NONGbixi/GONGCHUANG_Intelligent_Logistics_Handling_Tower_Crane_Mechanical/README.md

## 📢 装配验证更新｜2026.10.24

近期实车装配过程中发现并修复了三处影响安装的结构干涉与紧固件适配问题，修正涉及云台轴承、升降底板及底板。

**已下载或克隆旧版模型的使用者，请获取最新修复版本后再进行加工。详细修改记录请参阅 [Releases](https://github.com/NONGbixi/GONGCHUANG_Intelligent_Logistics_Handling_Tower_Crane_Mechanical/releases)。项目仍在持续调试与完善中。**

---

# 2027工创赛智梭速运升降台

面向智能物流搬运任务的升降台机械资料，包含 SolidWorks 零件模型、装配体、紧固件清单和三物料搬运动画。

## 原型来源

**原型车来自西安理工大学工程训练中心的 2025 工创赛塔吊方案。**

- 原文：[《工创赛2025-塔吊方案机械开源（2分15秒）》西安理工大学工程训练中心](https://blog.csdn.net/louisaerdusai/article/details/150106890)
- CSDN 作者账号：`louisaerdusai`。
- 本项目在该原型基础上进行升降台及夹取机构的修改与整理；原型设计的署名归原作者所有。
- 原文标示 CC BY-SA 4.0 版权协议；转载原文内容时应保留原作者、出处和版权声明。机械附件及第三方模型的具体授权以原始发布说明为准，详见 [来源与改动说明](文档/来源与改动说明.md)。

## 打开装配体

解压或完整克隆仓库后，用 SolidWorks 打开：

`模型/智梭_2027升降台总_铝条支架_标准紧固件.SLDASM`

请保留整个“模型”文件夹及其中的相对位置。发布副本的 CAD 文件统一添加“智梭_”前缀，方便与本机已有的同名源模型区分。

## 资料目录

| 目录 | 内容 |
| --- | --- |
| 模型 | 指定车辆的 5 个装配体和 85 个零件，共 90 个模型文件 |
| 清单 | 原有紧固件清单及商家采购清单的原样副本 |
| 动画 | 三物料搬运俯视与斜视配乐 MP4 |
| 预览 | 从指定发布总装导出的预览图 |
| 文档 | 来源说明、引用检查与完整性报告 |

## 本次整理

- 以标准紧固件版本总装为发布入口，补入原文件夹外的装配依赖。
- 排除 SolidWorks 锁文件、缓存、建模中间文件与重复备份；历史资料仍保留在本机源目录。
- 仅在新建发布副本中调整模型引用。源目录及源模型未执行改名、移动或保存。
- 发布副本中的旧上下文关联及导入链接处理，见“文档”内记录。

## 清单与动画说明

两份 Excel 清单为原样复制，分别用于紧固件明细与商家采购参考。采购前请结合当前装配、加工工艺和实际库存复核；本次没有重写清单数量。

动画为现有方案演示素材，预览图由指定发布总装导出。它们不代替最终装配的尺寸、运动干涉和加工验证。

## 验证

文档中的 [装配完整性报告](文档/装配完整性报告.txt)、[装配引用检查](文档/装配引用检查.tsv) 及文件校验清单为最初整理版本的历史记录，不代表后续模型变更已重新验证。最新实车装配反馈与修复说明请参阅 [Releases](https://github.com/NONGbixi/GONGCHUANG_Intelligent_Logistics_Handling_Tower_Crane_Mechanical/releases)。
