NONGbixi/GONGCHUANG_Intelligent_Logistics_Handling_Tower_Crane_Mechanical/建模记录/智梭_JY62陀螺仪/模型说明.txt

模型文件：D:\Robot\2027工创赛智梭速运升降台\模型\智梭_JY62陀螺仪.SLDPRT
一个 SolidWorks 多实体零件，陀螺仪模块及载板均包含在同一 SLDPRT 内。
外表无文字。PCB RGB(16,56,32)，银色 RGB(174,186,198)。
模块 15.24 x 15.24 mm，PCB 厚 0.8 mm，屏蔽罩高 2 mm。
12 个完整引脚通孔，D0.8 mm（孔径按图片比例估算），同排间距 2.54 mm，双排中心距 12.7 mm，同时保留板边半孔。
载板 30 x 30 x 1.6 mm，圆角 R1.5，四孔 D2.2，孔距 24.6 mm；载板外形、孔位及外围元件均为按图片比例建立的示意细节。
原目录 88 个已有模型文件的长度与修改时间均未变化。
建模脚本只新建文档，后续 FinishJY62 脚本按完整路径锁定本次新建文件。
