NONGbixi/GONGCHUANG_Intelligent_Logistics_Handling_Tower_Crane_Mechanical/文档/来源与改动说明.md

# 来源与改动说明

原型车来源：西安理工大学工程训练中心，2025 工创赛塔吊方案机械开源。

原文：https://blog.csdn.net/louisaerdusai/article/details/150106890

作者账号：louisaerdusai。原文页面声明采用 CC BY-SA 4.0，并要求转载附原文出处链接和版权声明。保留此署名及声明；机械附件、标准件和第三方模型的授权范围以各自原始说明为准。

本项目基于上述原型整理升降台资料，源目录中已有改动涉及底板、铝条支架、标准紧固件、转台、夹爪和物料模型。这里说明的是资料范围，不将这些改动全部归于本次整理。

本次整理只创建独立发布副本、收集依赖、调整副本文件名与引用、复制清单和动画、补充文档。不改动原目录中的源文件。

发布副本为脱离原电脑路径使用，对部分旧装配上下文关联进行了断开，保留副本中已有特征与几何；具体对象见独立副本说明.tsv。这样不会继续联动旧原型装配。原始参数化关联仍保留在本机源文件中。

未将整套资料另行标为 MIT 或其他新许可证，也未对第三方模型和配乐声明新的授权。
