NONGbixi/GONGCHUANG_Intelligent_Logistics_Handling_Tower_Crane_Mechanical/建模记录/智梭_JY62陀螺仪/智梭_JY62陀螺仪_正视.bmp

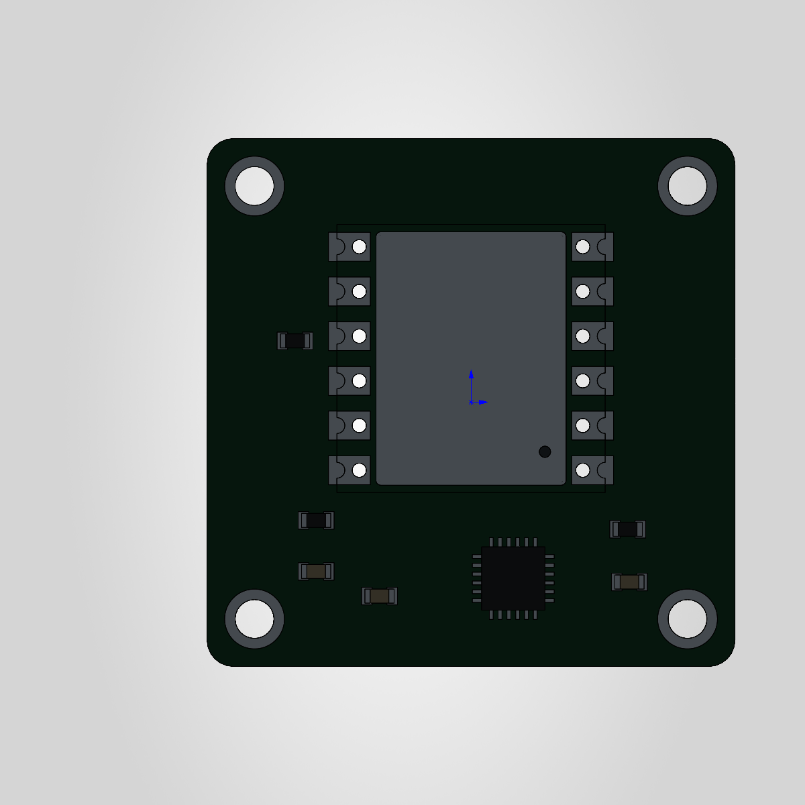
建模记录/智梭_JY62陀螺仪/智梭_JY62陀螺仪_正视.bmp
