NONGbixi/GONGCHUANG_Intelligent_Logistics_Handling_Tower_Crane_Mechanical/预览/指定总装预览.png

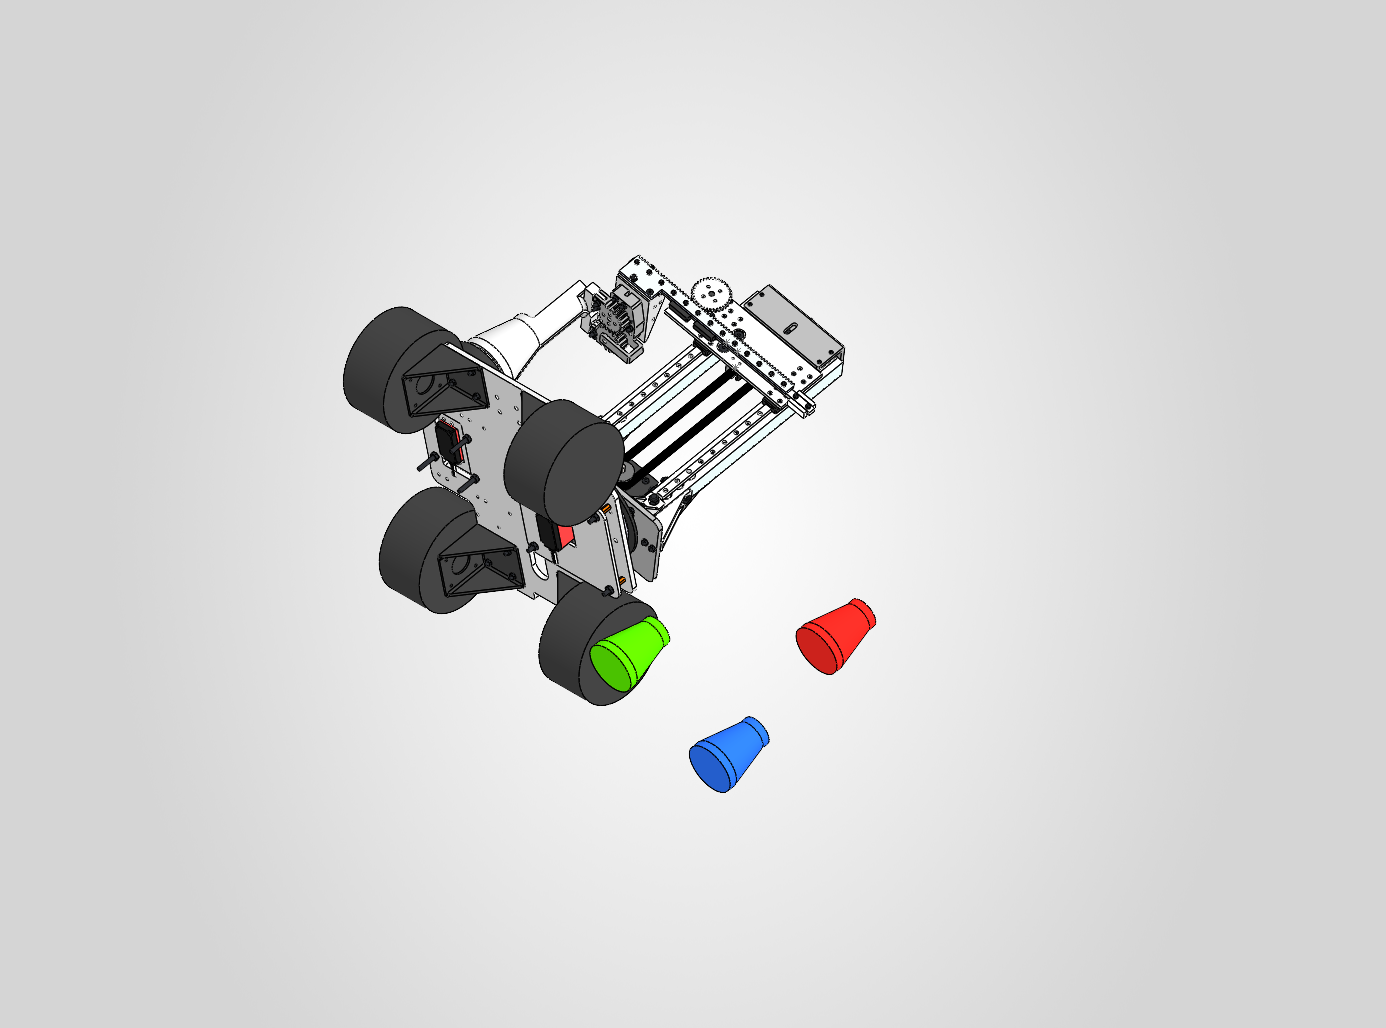
预览/指定总装预览.png
