NONGbixi/GONGCHUANG_Intelligent_Logistics_Handling_Tower_Crane_Mechanical/清单/2027升降台_紧固件商家采购清单.xlsx

种类 | 规格 | 数量
十字槽盘头螺钉 | M2×4（头径 3.5 mm，头厚 1.3 mm） | 24
十字槽盘头螺钉 | M2×6（头径 3.5 mm，头厚 1.3 mm） | 2
十字槽盘头螺钉 | M2×8（头径 3.5 mm，头厚 1.3 mm） | 13
十字槽超薄头螺钉 | M2×12（头径 4 mm，头厚 0.5 mm） | 2
十字槽盘头螺钉 | M2×25（头径 3.5 mm，头厚 1.3 mm） | 12
十字槽盘头螺钉 | M2×40（头径 3.5 mm，头厚 1.3 mm） | 4
十字槽超薄头螺钉 | M3×5（头径 6 mm，头厚 0.8 mm） | 4
十字槽超薄头螺钉 | M3×6（头径 6 mm，头厚 0.8 mm） | 4
十字槽超薄头螺钉 | M3×8（头径 6 mm，头厚 0.8 mm） | 4
十字槽超薄头螺钉 | M3×10（头径 6 mm，头厚 0.8 mm） | 4
十字槽超薄头螺钉 | M3×12（头径 6 mm，头厚 0.8 mm） | 36
十字槽超薄头螺钉 | M3×16（头径 6 mm，头厚 0.8 mm） | 6
十字槽超薄头螺钉 | M3×20（头径 6 mm，头厚 0.8 mm） | 7
十字槽超薄头螺钉 | M3×25（头径 6 mm，头厚 0.8 mm） | 4
十字槽超薄头螺钉 | M4×30（头径 8 mm，头厚 0.9 mm） | 4
十字槽超薄头螺钉 | M5×12（头径 9 mm，头厚 1 mm） | 14
十字槽超薄头螺钉 | M5×16（头径 9 mm，头厚 1 mm） | 2
十字槽超薄头螺钉 | M5×20（头径 9 mm，头厚 1 mm） | 1
十字槽超薄头螺钉 | M5×30（头径 9 mm，头厚 1 mm） | 9
六角螺母（ISO 4032） | M2 | 33
六角螺母（ISO 4032） | M3 | 53
六角螺母（ISO 4032） | M4 | 4
六角螺母（ISO 4032） | M5 | 26
