NONGbixi/GONGCHUANG_Intelligent_Logistics_Handling_Tower_Crane_Mechanical/清单/2027铝条支架总装_紧固件清单.xlsx

Sheet: 采购汇总
铝条支架总装紧固件清单（十字薄头方案）
 | 螺钉（颗） |  | 158 |  | 螺母（颗） |  | 118
 | 螺钉长度为头下长度；螺母对应厚度。数量为本次总装实际布置数量，不含备件。
序号 | 名称 | 规格 | 标准 | 公称直径 (mm) | 长度/厚度 (mm) | 螺距 (mm) | 数量 | 说明
1 | 螺钉 | M2×4 | JIS B 1111 盘头 | 2.0 | 4.0 | 0.4 | 26 | 十字槽盘头；头径 3.5，头厚 1.3 mm
2 | 螺钉 | M2×6 | JIS B 1111 盘头 | 2.0 | 6.0 | 0.4 | 2 | 十字槽盘头；头径 3.5，头厚 1.3 mm
3 | 螺钉 | M2×8 | JIS B 1111 盘头 | 2.0 | 8.0 | 0.4 | 13 | 十字槽盘头；头径 3.5，头厚 1.3 mm
4 | 螺钉 | M2×12 | JIS B 1111 盘头 | 2.0 | 12.0 | 0.4 | 2 | 十字槽盘头；头径 3.5，头厚 1.3 mm
5 | 螺钉 | M2×25 | JIS B 1111 盘头 | 2.0 | 25.0 | 0.4 | 12 | 十字槽盘头；头径 3.5，头厚 1.3 mm
6 | 螺钉 | M2×30 | JIS B 1111 盘头 | 2.0 | 30.0 | 0.4 | 4 | 十字槽盘头；头径 3.5，头厚 1.3 mm
7 | 螺钉 | M3×5 | NBK SEC/SECS 薄头 | 3.0 | 5.0 | 0.5 | 4 | 十字槽超薄头；头径 6，头厚 0.8 mm
8 | 螺钉 | M3×6 | NBK SEC/SECS 薄头 | 3.0 | 6.0 | 0.5 | 4 | 十字槽超薄头；头径 6，头厚 0.8 mm
9 | 螺钉 | M3×8 | NBK SEC/SECS 薄头 | 3.0 | 8.0 | 0.5 | 4 | 十字槽超薄头；头径 6，头厚 0.8 mm
10 | 螺钉 | M3×10 | NBK SEC/SECS 薄头 | 3.0 | 10.0 | 0.5 | 4 | 十字槽超薄头；头径 6，头厚 0.8 mm
11 | 螺钉 | M3×12 | NBK SEC/SECS 薄头 | 3.0 | 12.0 | 0.5 | 36 | 十字槽超薄头；头径 6，头厚 0.8 mm
12 | 螺钉 | M3×16 | NBK SEC/SECS 薄头 | 3.0 | 16.0 | 0.5 | 6 | 十字槽超薄头；头径 6，头厚 0.8 mm
13 | 螺钉 | M3×20 | NBK SEC/SECS 薄头 | 3.0 | 20.0 | 0.5 | 7 | 十字槽超薄头；头径 6，头厚 0.8 mm
14 | 螺钉 | M3×25 | NBK SEC/SECS 薄头 | 3.0 | 25.0 | 0.5 | 4 | 十字槽超薄头；头径 6，头厚 0.8 mm
15 | 螺钉 | M4×30 | NBK SEC/SECS 薄头 | 4.0 | 30.0 | 0.7 | 4 | 十字槽超薄头；头径 8，头厚 0.9 mm
16 | 螺钉 | M5×12 | NBK SEC/SECS 薄头 | 5.0 | 12.0 | 0.8 | 14 | 十字槽超薄头；头径 9，头厚 1 mm
17 | 螺钉 | M5×16 | NBK SEC/SECS 薄头 | 5.0 | 16.0 | 0.8 | 2 | 十字槽超薄头；头径 9，头厚 1 mm
18 | 螺钉 | M5×20 | NBK SEC/SECS 薄头 | 5.0 | 20.0 | 0.8 | 1 | 十字槽超薄头；头径 9，头厚 1 mm
19 | 螺钉 | M5×30 | NBK SEC/SECS 薄头 | 5.0 | 30.0 | 0.8 | 9 | 十字槽超薄头；头径 9，头厚 1 mm
20 | 螺母 | M2 | ISO 4032 | 2.0 | 1.6 | 0.4 | 35 | 标准六角螺母
21 | 螺母 | M3 | ISO 4032 | 3.0 | 2.4 | 0.5 | 53 | 标准六角螺母
22 | 螺母 | M4 | ISO 4032 | 4.0 | 3.2 | 0.7 | 4 | 标准六角螺母
23 | 螺母 | M5 | ISO 4032 | 5.0 | 4.7 | 0.8 | 26 | 标准六角螺母
 | 建模说明 |  | M3/M4/M5 采用十字槽超薄头目录尺寸：Ø6×0.8、Ø8×0.9、Ø9×1.0 mm；杆长按安装位置。螺纹、驱动槽、小圆角为简化表示。原云台、顶端支承等仍有模型穿插，本表不代表整机零干涉制造确认。
 | M2 沉孔适配 |  | M2 采用 JIS 十字槽盘头 Ø3.5×1.3 mm，适配原 Ø4 沉孔；导轨螺钉头落入沉孔，螺母位于齿条或铝管外侧。顶片后侧连接使用 M2×30，舵机支架由其 M3 连接独立夹紧。全部螺钉使用十字驱动。
 | 滑块连接 |  | 仅布置螺钉，旋入滑块螺纹孔，不配置螺母。
 | 侧支架对孔 |  | 利用 v2/v4 底槽调位约 0.535 mm，8 处侧孔轴线对正，使用 M5×30 螺钉和 M5 螺母；与其正交的 M5 连接采用两侧独立紧固，避免铝管内螺杆相交。
 | 排除位置 |  | 云台装配与底板之间不新增紧固件；功能转轴及带轮、齿轮定位轴不按安装孔加螺钉。
 | 薄头尺寸依据 |  | NBK SEC/SECS 目录（薄头为厂家系列规格）：https://www.nbk1560.com/images/en-US/product/lowsmallheadscrew/SEC-TZB/SEC-TZB_1.pdf
 | M2 盘头依据 |  | JIS B 1111:2017 尺寸表：https://www.onoue1950.co.jp/products/koneji/jujikoneji/1667/；螺母按 ISO 4032。

Sheet: 安装明细
紧固件安装明细
编号对应总装中的“紧固_Fxxx”配合；模型沿用原文件引用，头型及采购标准以本清单和零件属性为准。
编号 | 类别 | 零件规格 | 标准 | 公称直径 (mm) | 长度/厚度 (mm) | 螺距 (mm) | 数量 | 安装部位 | 选择说明
F001 | 螺钉 | SEC_十字超薄头_M5x30 | NBK SEC/SECS 目录尺寸 | 5.0 | 30.0 | 0.8 | 1 | 升降台带轮-1 + 升降台惰轮座-1 | 按现有孔径选型；按已确认的十字超薄头系列，头径 9、头厚 1.0 mm。
F002 | 螺母 | ISO4032_M5螺母 | ISO4032 | 5.0 | 4.7 | 0.8 | 1 | 升降台带轮-1 + 升降台惰轮座-1 | 通孔连接，配ISO4032标准六角螺母
F003 | 螺钉 | JISB1111_十字盘头_M2x30 | JIS B 1111:2017 十字槽盘头 | 2.0 | 30.0 | 0.4 | 1 | 升降台250mm导轨-2 + 铝管-2 + 滑轨顶部片-1 | 头部落入导轨原沉孔，使用标准 M2×30 夹紧导轨、铝管和顶片后侧；避免长螺杆横穿滑块通道。
F004 | 螺母 | ISO4032_M2螺母 | ISO 4032 | 2.0 | 1.6 | 0.4 | 1 | 升降台250mm导轨-2 + 滑轨顶部片-1 + 铝管-2 | 通孔连接，配ISO4032标准六角螺母
F005 | 螺钉 | JISB1111_十字盘头_M2x30 | JIS B 1111:2017 十字槽盘头 | 2.0 | 30.0 | 0.4 | 1 | 升降台250mm导轨-2 + 铝管-2 + 滑轨顶部片-1 | 头部落入导轨原沉孔，使用标准 M2×30 夹紧导轨、铝管和顶片后侧；避免长螺杆横穿滑块通道。
F006 | 螺母 | ISO4032_M2螺母 | ISO 4032 | 2.0 | 1.6 | 0.4 | 1 | 升降台250mm导轨-2 + 滑轨顶部片-1 + 铝管-2 | 通孔连接，配ISO4032标准六角螺母
F007 | 螺钉 | JISB1111_十字盘头_M2x25 | JIS B 1111:2017 十字槽盘头 | 2.0 | 25.0 | 0.4 | 1 | 升降台250mm导轨-2 + 铝管-2 | 受限孔采用标准十字槽盘头 Ø3.5×1.3；保持板件、导轨及原孔尺寸。
F008 | 螺母 | ISO4032_M2螺母 | ISO 4032 | 2.0 | 1.6 | 0.4 | 1 | 升降台250mm导轨-2 + 铝管-2 | 通孔连接，配ISO4032标准六角螺母
F009 | 螺钉 | JISB1111_十字盘头_M2x25 | JIS B 1111:2017 十字槽盘头 | 2.0 | 25.0 | 0.4 | 1 | 升降台250mm导轨-2 + 铝管-2 | 受限孔采用标准十字槽盘头 Ø3.5×1.3；保持板件、导轨及原孔尺寸。
F010 | 螺母 | ISO4032_M2螺母 | ISO 4032 | 2.0 | 1.6 | 0.4 | 1 | 升降台250mm导轨-2 + 铝管-2 | 通孔连接，配ISO4032标准六角螺母
F011 | 螺钉 | JISB1111_十字盘头_M2x25 | JIS B 1111:2017 十字槽盘头 | 2.0 | 25.0 | 0.4 | 1 | 升降台250mm导轨-2 + 铝管-2 | 受限孔采用标准十字槽盘头 Ø3.5×1.3；保持板件、导轨及原孔尺寸。
F012 | 螺母 | ISO4032_M2螺母 | ISO 4032 | 2.0 | 1.6 | 0.4 | 1 | 升降台250mm导轨-2 + 铝管-2 | 通孔连接，配ISO4032标准六角螺母
F013 | 螺钉 | JISB1111_十字盘头_M2x25 | JIS B 1111:2017 十字槽盘头 | 2.0 | 25.0 | 0.4 | 1 | 升降台250mm导轨-2 + 铝管-2 | 受限孔采用标准十字槽盘头 Ø3.5×1.3；保持板件、导轨及原孔尺寸。
F014 | 螺母 | ISO4032_M2螺母 | ISO 4032 | 2.0 | 1.6 | 0.4 | 1 | 升降台250mm导轨-2 + 铝管-2 | 通孔连接，配ISO4032标准六角螺母
F015 | 螺钉 | JISB1111_十字盘头_M2x25 | JIS B 1111:2017 十字槽盘头 | 2.0 | 25.0 | 0.4 | 1 | 升降台250mm导轨-2 + 铝管-2 | 受限孔采用标准十字槽盘头 Ø3.5×1.3；保持板件、导轨及原孔尺寸。
F016 | 螺母 | ISO4032_M2螺母 | ISO 4032 | 2.0 | 1.6 | 0.4 | 1 | 升降台250mm导轨-2 + 铝管-2 | 通孔连接，配ISO4032标准六角螺母
F017 | 螺钉 | JISB1111_十字盘头_M2x25 | JIS B 1111:2017 十字槽盘头 | 2.0 | 25.0 | 0.4 | 1 | 升降台250mm导轨-2 + 铝管-2 | 受限孔采用标准十字槽盘头 Ø3.5×1.3；保持板件、导轨及原孔尺寸。
F018 | 螺母 | ISO4032_M2螺母 | ISO 4032 | 2.0 | 1.6 | 0.4 | 1 | 升降台250mm导轨-2 + 铝管-2 | 通孔连接，配ISO4032标准六角螺母
F019 | 螺钉 | JISB1111_十字盘头_M2x6 | JIS B 1111:2017 十字槽盘头 | 2.0 | 6.0 | 0.4 | 1 | 升降台250mm导轨-2 + 铝管-2 | 受限孔采用标准十字槽盘头 Ø3.5×1.3；保持板件、导轨及原孔尺寸。
F020 | 螺母 | ISO4032_M2螺母 | ISO 4032 | 2.0 | 1.6 | 0.4 | 1 | 升降台250mm导轨-2 + 铝管-2 | 通孔连接，配ISO4032标准六角螺母
F021 | 螺钉 | JISB1111_十字盘头_M2x4 | JIS B 1111:2017 十字槽盘头 | 2.0 | 4.0 | 0.4 | 1 | 导轨L形架v2-1 + 铝管-2 | 受限孔采用标准十字槽盘头 Ø3.5×1.3；保持板件、导轨及原孔尺寸。
F022 | 螺母 | ISO4032_M2螺母 | ISO 4032 | 2.0 | 1.6 | 0.4 | 1 | 导轨L形架v2-1 + 铝管-2 | 通孔连接，配ISO4032标准六角螺母
F023 | 螺钉 | SEC_十字超薄头_M5x12 | NBK SEC/SECS 目录尺寸 | 5.0 | 12.0 | 0.8 | 1 | 导轨L形架v2-1 + 铝管-2 | 按现有孔径选型；按已确认的十字超薄头系列，头径 9、头厚 1.0 mm。；从铝管内侧向外安装，薄头在管内、螺母在支架外侧，避开管内横向螺杆。
F024 | 螺母 | ISO4032_M5螺母 | ISO4032 | 5.0 | 4.7 | 0.8 | 1 | 导轨L形架v2-1 + 铝管-2 | 通孔连接，配ISO4032标准六角螺母；从铝管内侧向外安装，薄头在管内、螺母在支架外侧，避开管内横向螺杆。
F025 | 螺钉 | SEC_十字超薄头_M5x12 | NBK SEC/SECS 目录尺寸 | 5.0 | 12.0 | 0.8 | 1 | 导轨L形架v2-1 + 铝管-2 | 按现有孔径选型；按已确认的十字超薄头系列，头径 9、头厚 1.0 mm。；从铝管内侧向外安装，薄头在管内、螺母在支架外侧，避开管内横向螺杆。
F026 | 螺母 | ISO4032_M5螺母 | ISO4032 | 5.0 | 4.7 | 0.8 | 1 | 导轨L形架v2-1 + 铝管-2 | 通孔连接，配ISO4032标准六角螺母；从铝管内侧向外安装，薄头在管内、螺母在支架外侧，避开管内横向螺杆。
F027 | 螺钉 | SEC_十字超薄头_M5x12 | NBK SEC/SECS 目录尺寸 | 5.0 | 12.0 | 0.8 | 1 | 导轨L形架v2-1 + 铝管-2 | 按现有孔径选型；按已确认的十字超薄头系列，头径 9、头厚 1.0 mm。；从铝管内侧向外安装，薄头在管内、螺母在支架外侧，避开管内横向螺杆。
F028 | 螺母 | ISO4032_M5螺母 | ISO4032 | 5.0 | 4.7 | 0.8 | 1 | 导轨L形架v2-1 + 铝管-2 | 通孔连接，配ISO4032标准六角螺母；从铝管内侧向外安装，薄头在管内、螺母在支架外侧，避开管内横向螺杆。
F029 | 螺钉 | JISB1111_十字盘头_M2x4 | JIS B 1111:2017 十字槽盘头 | 2.0 | 4.0 | 0.4 | 1 | 前伸水平轴连接板-1 + 升降台滑块-4 | 受限孔采用标准十字槽盘头 Ø3.5×1.3；保持板件、导轨及原孔尺寸。
F030 | 螺钉 | JISB1111_十字盘头_M2x4 | JIS B 1111:2017 十字槽盘头 | 2.0 | 4.0 | 0.4 | 1 | 前伸水平轴连接板-1 + 升降台滑块-4 | 受限孔采用标准十字槽盘头 Ø3.5×1.3；保持板件、导轨及原孔尺寸。
F031 | 螺钉 | JISB1111_十字盘头_M2x4 | JIS B 1111:2017 十字槽盘头 | 2.0 | 4.0 | 0.4 | 1 | 前伸水平轴连接板-1 + 升降台滑块-4 | 受限孔采用标准十字槽盘头 Ø3.5×1.3；保持板件、导轨及原孔尺寸。
F032 | 螺钉 | JISB1111_十字盘头_M2x4 | JIS B 1111:2017 十字槽盘头 | 2.0 | 4.0 | 0.4 | 1 | 前伸水平轴连接板-1 + 升降台滑块-4 | 受限孔采用标准十字槽盘头 Ø3.5×1.3；保持板件、导轨及原孔尺寸。
F033 | 螺钉 | JISB1111_十字盘头_M2x4 | JIS B 1111:2017 十字槽盘头 | 2.0 | 4.0 | 0.4 | 1 | 前伸水平轴连接板-1 + 升降台滑块-1 | 受限孔采用标准十字槽盘头 Ø3.5×1.3；保持板件、导轨及原孔尺寸。
F034 | 螺钉 | JISB1111_十字盘头_M2x4 | JIS B 1111:2017 十字槽盘头 | 2.0 | 4.0 | 0.4 | 1 | 前伸水平轴连接板-1 + 升降台滑块-1 | 受限孔采用标准十字槽盘头 Ø3.5×1.3；保持板件、导轨及原孔尺寸。
F035 | 螺钉 | JISB1111_十字盘头_M2x4 | JIS B 1111:2017 十字槽盘头 | 2.0 | 4.0 | 0.4 | 1 | 前伸水平轴连接板-1 + 升降台滑块-1 | 受限孔采用标准十字槽盘头 Ø3.5×1.3；保持板件、导轨及原孔尺寸。
F036 | 螺钉 | JISB1111_十字盘头_M2x4 | JIS B 1111:2017 十字槽盘头 | 2.0 | 4.0 | 0.4 | 1 | 前伸水平轴连接板-1 + 升降台滑块-1 | 受限孔采用标准十字槽盘头 Ø3.5×1.3；保持板件、导轨及原孔尺寸。
F037 | 螺钉 | JISB1111_十字盘头_M2x30 | JIS B 1111:2017 十字槽盘头 | 2.0 | 30.0 | 0.4 | 1 | 升降台250mm导轨-3 + 铝管-1 + 滑轨顶部片-1 | 头部落入导轨原沉孔，使用标准 M2×30 夹紧导轨、铝管和顶片后侧；避免长螺杆横穿滑块通道。
F038 | 螺母 | ISO4032_M2螺母 | ISO 4032 | 2.0 | 1.6 | 0.4 | 1 | 升降台250mm导轨-3 + 滑轨顶部片-1 + 铝管-1 | 通孔连接，配ISO4032标准六角螺母
F039 | 螺钉 | JISB1111_十字盘头_M2x30 | JIS B 1111:2017 十字槽盘头 | 2.0 | 30.0 | 0.4 | 1 | 升降台250mm导轨-3 + 铝管-1 + 滑轨顶部片-1 | 头部落入导轨原沉孔，使用标准 M2×30 夹紧导轨、铝管和顶片后侧；避免长螺杆横穿滑块通道。
F040 | 螺母 | ISO4032_M2螺母 | ISO 4032 | 2.0 | 1.6 | 0.4 | 1 | 升降台250mm导轨-3 + 滑轨顶部片-1 + 铝管-1 | 通孔连接，配ISO4032标准六角螺母
F041 | 螺钉 | JISB1111_十字盘头_M2x25 | JIS B 1111:2017 十字槽盘头 | 2.0 | 25.0 | 0.4 | 1 | 升降台250mm导轨-3 + 铝管-1 | 受限孔采用标准十字槽盘头 Ø3.5×1.3；保持板件、导轨及原孔尺寸。
F042 | 螺母 | ISO4032_M2螺母 | ISO 4032 | 2.0 | 1.6 | 0.4 | 1 | 升降台250mm导轨-3 + 铝管-1 | 通孔连接，配ISO4032标准六角螺母
F043 | 螺钉 | JISB1111_十字盘头_M2x25 | JIS B 1111:2017 十字槽盘头 | 2.0 | 25.0 | 0.4 | 1 | 升降台250mm导轨-3 + 铝管-1 | 受限孔采用标准十字槽盘头 Ø3.5×1.3；保持板件、导轨及原孔尺寸。
F044 | 螺母 | ISO4032_M2螺母 | ISO 4032 | 2.0 | 1.6 | 0.4 | 1 | 升降台250mm导轨-3 + 铝管-1 | 通孔连接，配ISO4032标准六角螺母
F045 | 螺钉 | JISB1111_十字盘头_M2x25 | JIS B 1111:2017 十字槽盘头 | 2.0 | 25.0 | 0.4 | 1 | 升降台250mm导轨-3 + 铝管-1 | 受限孔采用标准十字槽盘头 Ø3.5×1.3；保持板件、导轨及原孔尺寸。
F046 | 螺母 | ISO4032_M2螺母 | ISO 4032 | 2.0 | 1.6 | 0.4 | 1 | 升降台250mm导轨-3 + 铝管-1 | 通孔连接，配ISO4032标准六角螺母
F047 | 螺钉 | SEC_十字超薄头_M5x12 | NBK SEC/SECS 目录尺寸 | 5.0 | 12.0 | 0.8 | 1 | 铝管-1 + 导轨L形架v2-2 | 管内横向螺杆避让：原贯穿连接改为两侧分别紧固；采用现有 M5×12 标准薄头螺钉，头在管内，螺母在支架外侧。
F048 | 螺母 | ISO4032_M5螺母 | ISO4032 | 5.0 | 4.7 | 0.8 | 1 | 铝管-1 + 导轨L形架v2-2 | 管内横向螺杆避让：原贯穿连接改为两侧分别紧固；采用现有 M5×12 标准薄头螺钉，头在管内，螺母在支架外侧。
F049 | 螺钉 | JISB1111_十字盘头_M2x25 | JIS B 1111:2017 十字槽盘头 | 2.0 | 25.0 | 0.4 | 1 | 升降台250mm导轨-3 + 铝管-1 | 受限孔采用标准十字槽盘头 Ø3.5×1.3；保持板件、导轨及原孔尺寸。
F050 | 螺母 | ISO4032_M2螺母 | ISO 4032 | 2.0 | 1.6 | 0.4 | 1 | 升降台250mm导轨-3 + 铝管-1 | 通孔连接，配ISO4032标准六角螺母
F051 | 螺钉 | JISB1111_十字盘头_M2x6 | JIS B 1111:2017 十字槽盘头 | 2.0 | 6.0 | 0.4 | 1 | 升降台250mm导轨-3 + 铝管-1 | 受限孔采用标准十字槽盘头 Ø3.5×1.3；保持板件、导轨及原孔尺寸。
F052 | 螺母 | ISO4032_M2螺母 | ISO 4032 | 2.0 | 1.6 | 0.4 | 1 | 升降台250mm导轨-3 + 铝管-1 | 通孔连接，配ISO4032标准六角螺母
F053 | 螺钉 | JISB1111_十字盘头_M2x4 | JIS B 1111:2017 十字槽盘头 | 2.0 | 4.0 | 0.4 | 1 | 导轨L形架v2-2 + 铝管-1 | 受限孔采用标准十字槽盘头 Ø3.5×1.3；保持板件、导轨及原孔尺寸。
F054 | 螺母 | ISO4032_M2螺母 | ISO 4032 | 2.0 | 1.6 | 0.4 | 1 | 导轨L形架v2-2 + 铝管-1 | 通孔连接，配ISO4032标准六角螺母
F055 | 螺钉 | JISB1111_十字盘头_M2x25 | JIS B 1111:2017 十字槽盘头 | 2.0 | 25.0 | 0.4 | 1 | 升降台250mm导轨-3 + 铝管-1 | 受限孔采用标准十字槽盘头 Ø3.5×1.3；保持板件、导轨及原孔尺寸。
F056 | 螺母 | ISO4032_M2螺母 | ISO 4032 | 2.0 | 1.6 | 0.4 | 1 | 升降台250mm导轨-3 + 铝管-1 | 通孔连接，配ISO4032标准六角螺母
F057 | 螺钉 | JISB1111_十字盘头_M2x25 | JIS B 1111:2017 十字槽盘头 | 2.0 | 25.0 | 0.4 | 1 | 升降台250mm导轨-3 + 铝管-1 | 受限孔采用标准十字槽盘头 Ø3.5×1.3；保持板件、导轨及原孔尺寸。
F058 | 螺母 | ISO4032_M2螺母 | ISO 4032 | 2.0 | 1.6 | 0.4 | 1 | 升降台250mm导轨-3 + 铝管-1 | 通孔连接，配ISO4032标准六角螺母
F059 | 螺钉 | SEC_十字超薄头_M5x12 | NBK SEC/SECS 目录尺寸 | 5.0 | 12.0 | 0.8 | 1 | 铝管-1 + 导轨L形架v2-2 | 管内横向螺杆避让：原贯穿连接改为两侧分别紧固；采用现有 M5×12 标准薄头螺钉，头在管内，螺母在支架外侧。
F060 | 螺母 | ISO4032_M5螺母 | ISO4032 | 5.0 | 4.7 | 0.8 | 1 | 铝管-1 + 导轨L形架v2-2 | 管内横向螺杆避让：原贯穿连接改为两侧分别紧固；采用现有 M5×12 标准薄头螺钉，头在管内，螺母在支架外侧。
F061 | 螺钉 | SEC_十字超薄头_M5x12 | NBK SEC/SECS 目录尺寸 | 5.0 | 12.0 | 0.8 | 1 | 导轨L形架v2-2 + 铝管-1 | 按现有孔径选型；按已确认的十字超薄头系列，头径 9、头厚 1.0 mm。；从铝管内侧向外安装，薄头在管内、螺母在支架外侧，避开管内横向螺杆。
F062 | 螺母 | ISO4032_M5螺母 | ISO4032 | 5.0 | 4.7 | 0.8 | 1 | 导轨L形架v2-2 + 铝管-1 | 通孔连接，配ISO4032标准六角螺母；从铝管内侧向外安装，薄头在管内、螺母在支架外侧，避开管内横向螺杆。
F063 | 螺钉 | SEC_十字超薄头_M5x12 | NBK SEC/SECS 目录尺寸 | 5.0 | 12.0 | 0.8 | 1 | 导轨L形架v2-2 + 铝管-1 | 按现有孔径选型；按已确认的十字超薄头系列，头径 9、头厚 1.0 mm。；从铝管内侧向外安装，薄头在管内、螺母在支架外侧，避开管内横向螺杆。
F064 | 螺母 | ISO4032_M5螺母 | ISO4032 | 5.0 | 4.7 | 0.8 | 1 | 导轨L形架v2-2 + 铝管-1 | 通孔连接，配ISO4032标准六角螺母；从铝管内侧向外安装，薄头在管内、螺母在支架外侧，避开管内横向螺杆。
F065 | 螺钉 | SEC_十字超薄头_M5x12 | NBK SEC/SECS 目录尺寸 | 5.0 | 12.0 | 0.8 | 1 | 导轨L形架v2-2 + 铝管-1 | 按现有孔径选型；按已确认的十字超薄头系列，头径 9、头厚 1.0 mm。；从铝管内侧向外安装，薄头在管内、螺母在支架外侧，避开管内横向螺杆。
F066 | 螺母 | ISO4032_M5螺母 | ISO4032 | 5.0 | 4.7 | 0.8 | 1 | 导轨L形架v2-2 + 铝管-1 | 通孔连接，配ISO4032标准六角螺母；从铝管内侧向外安装，薄头在管内、螺母在支架外侧，避开管内横向螺杆。
F067 | 螺钉 | SEC_十字超薄头_M5x30 | NBK SEC/SECS 目录尺寸 | 5.0 | 30.0 | 0.8 | 1 | 导轨L形架v3-1 + 铝管-1 | 按用户要求，铝管侧面 Ø5.3 孔采用 M5 标准螺钉、螺母；通过 v2/v4 底槽调位使 8 处轴线对正。十字超薄头 Ø9×1.0 mm，头下长度 30 mm。
F068 | 螺母 | ISO4032_M5螺母 | ISO 4032 | 5.0 | 4.7 | 0.8 | 1 | 导轨L形架v3-1 + 铝管-1 | 按用户要求，铝管侧面 Ø5.3 孔采用 M5 标准螺钉、螺母；通过 v2/v4 底槽调位使 8 处轴线对正。ISO 4032 M5 标准六角螺母。
F069 | 螺钉 | SEC_十字超薄头_M5x30 | NBK SEC/SECS 目录尺寸 | 5.0 | 30.0 | 0.8 | 1 | 导轨L形架v3-2 + 铝管-2 | 按用户要求，铝管侧面 Ø5.3 孔采用 M5 标准螺钉、螺母；通过 v2/v4 底槽调位使 8 处轴线对正。十字超薄头 Ø9×1.0 mm，头下长度 30 mm。
F070 | 螺母 | ISO4032_M5螺母 | ISO 4032 | 5.0 | 4.7 | 0.8 | 1 | 导轨L形架v3-2 + 铝管-2 | 按用户要求，铝管侧面 Ø5.3 孔采用 M5 标准螺钉、螺母；通过 v2/v4 底槽调位使 8 处轴线对正。ISO 4032 M5 标准六角螺母。
F071 | 螺钉 | SEC_十字超薄头_M5x30 | NBK SEC/SECS 目录尺寸 | 5.0 | 30.0 | 0.8 | 1 | 导轨L形架v3-1 + 铝管-1 | 按用户要求，铝管侧面 Ø5.3 孔采用 M5 标准螺钉、螺母；通过 v2/v4 底槽调位使 8 处轴线对正。十字超薄头 Ø9×1.0 mm，头下长度 30 mm。
F072 | 螺母 | ISO4032_M5螺母 | ISO 4032 | 5.0 | 4.7 | 0.8 | 1 | 导轨L形架v3-1 + 铝管-1 | 按用户要求，铝管侧面 Ø5.3 孔采用 M5 标准螺钉、螺母；通过 v2/v4 底槽调位使 8 处轴线对正。ISO 4032 M5 标准六角螺母。
F073 | 螺钉 | SEC_十字超薄头_M5x30 | NBK SEC/SECS 目录尺寸 | 5.0 | 30.0 | 0.8 | 1 | 导轨L形架v3-2 + 铝管-2 | 按用户要求，铝管侧面 Ø5.3 孔采用 M5 标准螺钉、螺母；通过 v2/v4 底槽调位使 8 处轴线对正。十字超薄头 Ø9×1.0 mm，头下长度 30 mm。
F074 | 螺母 | ISO4032_M5螺母 | ISO 4032 | 5.0 | 4.7 | 0.8 | 1 | 导轨L形架v3-2 + 铝管-2 | 按用户要求，铝管侧面 Ø5.3 孔采用 M5 标准螺钉、螺母；通过 v2/v4 底槽调位使 8 处轴线对正。ISO 4032 M5 标准六角螺母。
F075 | 螺钉 | SEC_十字超薄头_M5x30 | NBK SEC/SECS 目录尺寸 | 5.0 | 30.0 | 0.8 | 1 | 导轨L形架v3-1 + 铝管-1 | 按用户要求，铝管侧面 Ø5.3 孔采用 M5 标准螺钉、螺母；通过 v2/v4 底槽调位使 8 处轴线对正。十字超薄头 Ø9×1.0 mm，头下长度 30 mm。
F076 | 螺母 | ISO4032_M5螺母 | ISO 4032 | 5.0 | 4.7 | 0.8 | 1 | 导轨L形架v3-1 + 铝管-1 | 按用户要求，铝管侧面 Ø5.3 孔采用 M5 标准螺钉、螺母；通过 v2/v4 底槽调位使 8 处轴线对正。ISO 4032 M5 标准六角螺母。
F077 | 螺钉 | SEC_十字超薄头_M5x30 | NBK SEC/SECS 目录尺寸 | 5.0 | 30.0 | 0.8 | 1 | 导轨L形架v3-2 + 铝管-2 | 按用户要求，铝管侧面 Ø5.3 孔采用 M5 标准螺钉、螺母；通过 v2/v4 底槽调位使 8 处轴线对正。十字超薄头 Ø9×1.0 mm，头下长度 30 mm。
F078 | 螺母 | ISO4032_M5螺母 | ISO 4032 | 5.0 | 4.7 | 0.8 | 1 | 导轨L形架v3-2 + 铝管-2 | 按用户要求，铝管侧面 Ø5.3 孔采用 M5 标准螺钉、螺母；通过 v2/v4 底槽调位使 8 处轴线对正。ISO 4032 M5 标准六角螺母。
F079 | 螺钉 | SEC_十字超薄头_M5x30 | NBK SEC/SECS 目录尺寸 | 5.0 | 30.0 | 0.8 | 1 | 导轨L形架v3-1 + 铝管-1 | 按用户要求，铝管侧面 Ø5.3 孔采用 M5 标准螺钉、螺母；通过 v2/v4 底槽调位使 8 处轴线对正。十字超薄头 Ø9×1.0 mm，头下长度 30 mm。
F080 | 螺母 | ISO4032_M5螺母 | ISO 4032 | 5.0 | 4.7 | 0.8 | 1 | 导轨L形架v3-1 + 铝管-1 | 按用户要求，铝管侧面 Ø5.3 孔采用 M5 标准螺钉、螺母；通过 v2/v4 底槽调位使 8 处轴线对正。ISO 4032 M5 标准六角螺母。
F081 | 螺钉 | SEC_十字超薄头_M5x30 | NBK SEC/SECS 目录尺寸 | 5.0 | 30.0 | 0.8 | 1 | 导轨L形架v3-2 + 铝管-2 | 按用户要求，铝管侧面 Ø5.3 孔采用 M5 标准螺钉、螺母；通过 v2/v4 底槽调位使 8 处轴线对正。十字超薄头 Ø9×1.0 mm，头下长度 30 mm。
F082 | 螺母 | ISO4032_M5螺母 | ISO 4032 | 5.0 | 4.7 | 0.8 | 1 | 导轨L形架v3-2 + 铝管-2 | 按用户要求，铝管侧面 Ø5.3 孔采用 M5 标准螺钉、螺母；通过 v2/v4 底槽调位使 8 处轴线对正。ISO 4032 M5 标准六角螺母。
F083 | 螺钉 | JISB1111_十字盘头_M2x4 | JIS B 1111:2017 十字槽盘头 | 2.0 | 4.0 | 0.4 | 1 | 前伸水平轴连接板-1 + 升降台滑块-2 | 受限孔采用标准十字槽盘头 Ø3.5×1.3；保持板件、导轨及原孔尺寸。
F084 | 螺钉 | JISB1111_十字盘头_M2x4 | JIS B 1111:2017 十字槽盘头 | 2.0 | 4.0 | 0.4 | 1 | 前伸水平轴连接板-1 + 升降台滑块-2 | 受限孔采用标准十字槽盘头 Ø3.5×1.3；保持板件、导轨及原孔尺寸。
F085 | 螺钉 | JISB1111_十字盘头_M2x4 | JIS B 1111:2017 十字槽盘头 | 2.0 | 4.0 | 0.4 | 1 | 前伸水平轴连接板-1 + 升降台滑块-2 | 受限孔采用标准十字槽盘头 Ø3.5×1.3；保持板件、导轨及原孔尺寸。
F086 | 螺钉 | JISB1111_十字盘头_M2x4 | JIS B 1111:2017 十字槽盘头 | 2.0 | 4.0 | 0.4 | 1 | 前伸水平轴连接板-1 + 升降台滑块-2 | 受限孔采用标准十字槽盘头 Ø3.5×1.3；保持板件、导轨及原孔尺寸。
F087 | 螺钉 | JISB1111_十字盘头_M2x4 | JIS B 1111:2017 十字槽盘头 | 2.0 | 4.0 | 0.4 | 1 | 前伸水平轴连接板-1 + 升降台滑块-5 | 受限孔采用标准十字槽盘头 Ø3.5×1.3；保持板件、导轨及原孔尺寸。
F088 | 螺钉 | JISB1111_十字盘头_M2x4 | JIS B 1111:2017 十字槽盘头 | 2.0 | 4.0 | 0.4 | 1 | 前伸水平轴连接板-1 + 升降台滑块-5 | 受限孔采用标准十字槽盘头 Ø3.5×1.3；保持板件、导轨及原孔尺寸。
F089 | 螺钉 | JISB1111_十字盘头_M2x4 | JIS B 1111:2017 十字槽盘头 | 2.0 | 4.0 | 0.4 | 1 | 前伸水平轴连接板-1 + 升降台滑块-5 | 受限孔采用标准十字槽盘头 Ø3.5×1.3；保持板件、导轨及原孔尺寸。
F090 | 螺钉 | JISB1111_十字盘头_M2x4 | JIS B 1111:2017 十字槽盘头 | 2.0 | 4.0 | 0.4 | 1 | 前伸水平轴连接板-1 + 升降台滑块-5 | 受限孔采用标准十字槽盘头 Ø3.5×1.3；保持板件、导轨及原孔尺寸。
F091 | 螺钉 | SEC_十字超薄头_M5x12 | NBK SEC/SECS 目录尺寸 | 5.0 | 12.0 | 0.8 | 1 | 铝管-2 + 导轨L形架v2-1 | 管内横向螺杆避让：原贯穿连接改为两侧分别紧固；采用现有 M5×12 标准薄头螺钉，头在管内，螺母在支架外侧。
F092 | 螺母 | ISO4032_M5螺母 | ISO4032 | 5.0 | 4.7 | 0.8 | 1 | 铝管-2 + 导轨L形架v2-1 | 管内横向螺杆避让：原贯穿连接改为两侧分别紧固；采用现有 M5×12 标准薄头螺钉，头在管内，螺母在支架外侧。
F093 | 螺钉 | SEC_十字超薄头_M5x12 | NBK SEC/SECS 目录尺寸 | 5.0 | 12.0 | 0.8 | 1 | 铝管-2 + 导轨L形架v2-1 | 管内横向螺杆避让：原贯穿连接改为两侧分别紧固；采用现有 M5×12 标准薄头螺钉，头在管内，螺母在支架外侧。
F094 | 螺母 | ISO4032_M5螺母 | ISO4032 | 5.0 | 4.7 | 0.8 | 1 | 铝管-2 + 导轨L形架v2-1 | 管内横向螺杆避让：原贯穿连接改为两侧分别紧固；采用现有 M5×12 标准薄头螺钉，头在管内，螺母在支架外侧。
F095 | 螺钉 | JISB1111_十字盘头_M2x4 | JIS B 1111:2017 十字槽盘头 | 2.0 | 4.0 | 0.4 | 1 | 前伸水平轴连接板-1 + 升降台滑块-3 | 受限孔采用标准十字槽盘头 Ø3.5×1.3；保持板件、导轨及原孔尺寸。
F096 | 螺钉 | JISB1111_十字盘头_M2x4 | JIS B 1111:2017 十字槽盘头 | 2.0 | 4.0 | 0.4 | 1 | 前伸水平轴连接板-1 + 升降台滑块-3 | 受限孔采用标准十字槽盘头 Ø3.5×1.3；保持板件、导轨及原孔尺寸。
F097 | 螺钉 | JISB1111_十字盘头_M2x4 | JIS B 1111:2017 十字槽盘头 | 2.0 | 4.0 | 0.4 | 1 | 前伸水平轴连接板-1 + 升降台滑块-3 | 受限孔采用标准十字槽盘头 Ø3.5×1.3；保持板件、导轨及原孔尺寸。
F098 | 螺钉 | JISB1111_十字盘头_M2x4 | JIS B 1111:2017 十字槽盘头 | 2.0 | 4.0 | 0.4 | 1 | 前伸水平轴连接板-1 + 升降台滑块-3 | 受限孔采用标准十字槽盘头 Ø3.5×1.3；保持板件、导轨及原孔尺寸。
F099 | 螺钉 | SEC_十字超薄头_M3x12 | NBK SEC/SECS 目录尺寸 | 3.0 | 12.0 | 0.5 | 1 | 升降台升降底座-3 + 新版42步进电机支架-1 | 按现有孔径选型；按已确认的十字超薄头系列，头径 6、头厚 0.8 mm。
F100 | 螺母 | ISO4032_M3螺母 | ISO4032 | 3.0 | 2.4 | 0.5 | 1 | 升降台升降底座-3 + 新版42步进电机支架-1 | 通孔连接，配ISO4032标准六角螺母
F101 | 螺钉 | SEC_十字超薄头_M3x12 | NBK SEC/SECS 目录尺寸 | 3.0 | 12.0 | 0.5 | 1 | 升降台升降底座-3 + 新版42步进电机支架-1 | 按现有孔径选型；按已确认的十字超薄头系列，头径 6、头厚 0.8 mm。
F102 | 螺母 | ISO4032_M3螺母 | ISO4032 | 3.0 | 2.4 | 0.5 | 1 | 升降台升降底座-3 + 新版42步进电机支架-1 | 通孔连接，配ISO4032标准六角螺母
F103 | 螺钉 | SEC_十字超薄头_M3x12 | NBK SEC/SECS 目录尺寸 | 3.0 | 12.0 | 0.5 | 1 | 升降台升降底座-3 + 新版42步进电机支架-1 | 按现有孔径选型；按已确认的十字超薄头系列，头径 6、头厚 0.8 mm。
F104 | 螺母 | ISO4032_M3螺母 | ISO4032 | 3.0 | 2.4 | 0.5 | 1 | 升降台升降底座-3 + 新版42步进电机支架-1 | 通孔连接，配ISO4032标准六角螺母
F105 | 螺钉 | SEC_十字超薄头_M3x12 | NBK SEC/SECS 目录尺寸 | 3.0 | 12.0 | 0.5 | 1 | 升降台升降底座-3 + 新版42步进电机支架-1 | 按现有孔径选型；按已确认的十字超薄头系列，头径 6、头厚 0.8 mm。
F106 | 螺母 | ISO4032_M3螺母 | ISO4032 | 3.0 | 2.4 | 0.5 | 1 | 升降台升降底座-3 + 新版42步进电机支架-1 | 通孔连接，配ISO4032标准六角螺母
F107 | 螺钉 | SEC_十字超薄头_M3x5 | NBK SEC/SECS 目录尺寸 | 3.0 | 5.0 | 0.5 | 1 | 42步进电机-1/42步进电机-02-1 + 新版42步进电机支架-1 | 旋入电机螺纹孔，无螺母；按现有孔径选型；按已确认的十字超薄头系列，头径 6、头厚 0.8 mm。
F108 | 螺钉 | SEC_十字超薄头_M3x5 | NBK SEC/SECS 目录尺寸 | 3.0 | 5.0 | 0.5 | 1 | 42步进电机-1/42步进电机-02-1 + 新版42步进电机支架-1 | 旋入电机螺纹孔，无螺母；按现有孔径选型；按已确认的十字超薄头系列，头径 6、头厚 0.8 mm。
F109 | 螺钉 | SEC_十字超薄头_M3x5 | NBK SEC/SECS 目录尺寸 | 3.0 | 5.0 | 0.5 | 1 | 42步进电机-1/42步进电机-02-1 + 新版42步进电机支架-1 | 旋入电机螺纹孔，无螺母；按现有孔径选型；按已确认的十字超薄头系列，头径 6、头厚 0.8 mm。
F110 | 螺钉 | SEC_十字超薄头_M3x5 | NBK SEC/SECS 目录尺寸 | 3.0 | 5.0 | 0.5 | 1 | 42步进电机-1/42步进电机-02-1 + 新版42步进电机支架-1 | 旋入电机螺纹孔，无螺母；按现有孔径选型；按已确认的十字超薄头系列，头径 6、头厚 0.8 mm。
F111 | 螺钉 | JISB1111_十字盘头_M2x4 | JIS B 1111:2017 十字槽盘头 | 2.0 | 4.0 | 0.4 | 1 | 前伸水平轴连接板-1 + 升降台滑块-6 | 受限孔采用标准十字槽盘头 Ø3.5×1.3；保持板件、导轨及原孔尺寸。
F112 | 螺钉 | JISB1111_十字盘头_M2x4 | JIS B 1111:2017 十字槽盘头 | 2.0 | 4.0 | 0.4 | 1 | 前伸水平轴连接板-1 + 升降台滑块-6 | 受限孔采用标准十字槽盘头 Ø3.5×1.3；保持板件、导轨及原孔尺寸。
F113 | 螺钉 | JISB1111_十字盘头_M2x4 | JIS B 1111:2017 十字槽盘头 | 2.0 | 4.0 | 0.4 | 1 | 前伸水平轴连接板-1 + 升降台滑块-6 | 受限孔采用标准十字槽盘头 Ø3.5×1.3；保持板件、导轨及原孔尺寸。
F114 | 螺钉 | JISB1111_十字盘头_M2x4 | JIS B 1111:2017 十字槽盘头 | 2.0 | 4.0 | 0.4 | 1 | 前伸水平轴连接板-1 + 升降台滑块-6 | 受限孔采用标准十字槽盘头 Ø3.5×1.3；保持板件、导轨及原孔尺寸。
F115 | 螺钉 | SEC_十字超薄头_M5x16 | NBK SEC/SECS 目录尺寸 | 5.0 | 16.0 | 0.8 | 1 | 前伸水平轴连接板-1 + 升降台皮带固定片1-1 | 按现有孔径选型；按已确认的十字超薄头系列，头径 9、头厚 1.0 mm。
F116 | 螺母 | ISO4032_M5螺母 | ISO4032 | 5.0 | 4.7 | 0.8 | 1 | 前伸水平轴连接板-1 + 升降台皮带固定片1-1 | 通孔连接，配ISO4032标准六角螺母
F117 | 螺钉 | SEC_十字超薄头_M5x16 | NBK SEC/SECS 目录尺寸 | 5.0 | 16.0 | 0.8 | 1 | 前伸水平轴连接板-1 + 升降台皮带固定片1-1 | 按现有孔径选型；按已确认的十字超薄头系列，头径 9、头厚 1.0 mm。
F118 | 螺母 | ISO4032_M5螺母 | ISO4032 | 5.0 | 4.7 | 0.8 | 1 | 前伸水平轴连接板-1 + 升降台皮带固定片1-1 | 通孔连接，配ISO4032标准六角螺母
F119 | 螺钉 | SEC_十字超薄头_M3x8 | NBK SEC/SECS 目录尺寸 | 3.0 | 8.0 | 0.5 | 1 | 28闭环步进电机-1 + 前伸水平轴连接板-1 | 旋入电机螺纹孔，无螺母；电机底孔按标准螺纹公称尺寸选型；按已确认的十字超薄头系列，头径 6、头厚 0.8 mm。
F120 | 螺钉 | SEC_十字超薄头_M3x8 | NBK SEC/SECS 目录尺寸 | 3.0 | 8.0 | 0.5 | 1 | 28闭环步进电机-1 + 前伸水平轴连接板-1 | 旋入电机螺纹孔，无螺母；电机底孔按标准螺纹公称尺寸选型；按已确认的十字超薄头系列，头径 6、头厚 0.8 mm。
F121 | 螺钉 | SEC_十字超薄头_M3x8 | NBK SEC/SECS 目录尺寸 | 3.0 | 8.0 | 0.5 | 1 | 28闭环步进电机-1 + 前伸水平轴连接板-1 | 旋入电机螺纹孔，无螺母；电机底孔按标准螺纹公称尺寸选型；按已确认的十字超薄头系列，头径 6、头厚 0.8 mm。
F122 | 螺钉 | SEC_十字超薄头_M3x8 | NBK SEC/SECS 目录尺寸 | 3.0 | 8.0 | 0.5 | 1 | 28闭环步进电机-1 + 前伸水平轴连接板-1 | 旋入电机螺纹孔，无螺母；电机底孔按标准螺纹公称尺寸选型；按已确认的十字超薄头系列，头径 6、头厚 0.8 mm。
F123 | 螺钉 | SEC_十字超薄头_M3x20 | NBK SEC/SECS 目录尺寸 | 3.0 | 20.0 | 0.5 | 1 | 新版升降台舵机爪子夹片(厚）-1 + 舵机座L形架-3 | 按现有孔径选型；按已确认的十字超薄头系列，头径 6、头厚 0.8 mm。
F124 | 螺母 | ISO4032_M3螺母 | ISO4032 | 3.0 | 2.4 | 0.5 | 1 | 新版升降台舵机爪子夹片(厚）-1 + 舵机座L形架-3 | 通孔连接，配ISO4032标准六角螺母
F125 | 螺钉 | SEC_十字超薄头_M3x20 | NBK SEC/SECS 目录尺寸 | 3.0 | 20.0 | 0.5 | 1 | 新版升降台舵机爪子夹片(厚）-1 + 舵机座L形架-3 | 按现有孔径选型；按已确认的十字超薄头系列，头径 6、头厚 0.8 mm。
F126 | 螺母 | ISO4032_M3螺母 | ISO4032 | 3.0 | 2.4 | 0.5 | 1 | 新版升降台舵机爪子夹片(厚）-1 + 舵机座L形架-3 | 通孔连接，配ISO4032标准六角螺母
F127 | 螺钉 | SEC_十字超薄头_M3x20 | NBK SEC/SECS 目录尺寸 | 3.0 | 20.0 | 0.5 | 1 | 新版升降台舵机爪子夹片(厚）-1 + 舵机座L形架-3 | 空间受限位置采用超薄十字头，头径6.0、头高0.8 mm；保持原杆径和头下长度。；按已确认的十字超薄头系列，头径 6、头厚 0.8 mm。
F128 | 螺母 | ISO4032_M3螺母 | ISO4032 | 3.0 | 2.4 | 0.5 | 1 | 新版升降台舵机爪子夹片(厚）-1 + 舵机座L形架-3 | 通孔连接，配ISO4032标准六角螺母
F129 | 螺钉 | JISB1111_十字盘头_M2x8 | JIS B 1111:2017 十字槽盘头 | 2.0 | 8.0 | 0.4 | 1 | 前伸齿条-1 + 升降台250mm导轨-1 | 头部落入导轨沉孔、螺母位于齿条外侧；舵机支架由其两处 M3 连接独立夹紧，不让 M2 螺杆横穿滑块通道。
F130 | 螺母 | ISO4032_M2螺母 | ISO 4032 | 2.0 | 1.6 | 0.4 | 1 | 前伸齿条-1 + 升降台250mm导轨-1 | 头部落入导轨沉孔、螺母位于齿条外侧；舵机支架由其两处 M3 连接独立夹紧，不让 M2 螺杆横穿滑块通道。
F131 | 螺钉 | JISB1111_十字盘头_M2x8 | JIS B 1111:2017 十字槽盘头 | 2.0 | 8.0 | 0.4 | 1 | 前伸齿条-1 + 升降台250mm导轨-1 | 受限孔采用标准十字槽盘头 Ø3.5×1.3；保持板件、导轨及原孔尺寸。 反向装入，头部落入导轨原沉孔；螺母位于齿条外侧。
F132 | 螺母 | ISO4032_M2螺母 | ISO 4032 | 2.0 | 1.6 | 0.4 | 1 | 前伸齿条-1 + 升降台250mm导轨-1 | 通孔连接，配ISO4032标准六角螺母
F133 | 螺钉 | JISB1111_十字盘头_M2x8 | JIS B 1111:2017 十字槽盘头 | 2.0 | 8.0 | 0.4 | 1 | 前伸齿条-1 + 升降台250mm导轨-1 | 受限孔采用标准十字槽盘头 Ø3.5×1.3；保持板件、导轨及原孔尺寸。 反向装入，头部落入导轨原沉孔；螺母位于齿条外侧。
F134 | 螺母 | ISO4032_M2螺母 | ISO 4032 | 2.0 | 1.6 | 0.4 | 1 | 前伸齿条-1 + 升降台250mm导轨-1 | 通孔连接，配ISO4032标准六角螺母
F135 | 螺钉 | JISB1111_十字盘头_M2x8 | JIS B 1111:2017 十字槽盘头 | 2.0 | 8.0 | 0.4 | 1 | 前伸齿条-1 + 升降台250mm导轨-1 | 受限孔采用标准十字槽盘头 Ø3.5×1.3；保持板件、导轨及原孔尺寸。 反向装入，头部落入导轨原沉孔；螺母位于齿条外侧。
F136 | 螺母 | ISO4032_M2螺母 | ISO 4032 | 2.0 | 1.6 | 0.4 | 1 | 前伸齿条-1 + 升降台250mm导轨-1 | 通孔连接，配ISO4032标准六角螺母
F137 | 螺钉 | JISB1111_十字盘头_M2x8 | JIS B 1111:2017 十字槽盘头 | 2.0 | 8.0 | 0.4 | 1 | 前伸齿条-1 + 升降台250mm导轨-1 | 头部落入导轨沉孔、螺母位于齿条外侧；舵机支架由其两处 M3 连接独立夹紧，不让 M2 螺杆横穿滑块通道。
F138 | 螺母 | ISO4032_M2螺母 | ISO 4032 | 2.0 | 1.6 | 0.4 | 1 | 前伸齿条-1 + 升降台250mm导轨-1 | 头部落入导轨沉孔、螺母位于齿条外侧；舵机支架由其两处 M3 连接独立夹紧，不让 M2 螺杆横穿滑块通道。
F139 | 螺钉 | JISB1111_十字盘头_M2x8 | JIS B 1111:2017 十字槽盘头 | 2.0 | 8.0 | 0.4 | 1 | 前伸齿条-1 + 升降台250mm导轨-1 | 受限孔采用标准十字槽盘头 Ø3.5×1.3；保持板件、导轨及原孔尺寸。 反向装入，头部落入导轨原沉孔；螺母位于齿条外侧。
F140 | 螺母 | ISO4032_M2螺母 | ISO 4032 | 2.0 | 1.6 | 0.4 | 1 | 前伸齿条-1 + 升降台250mm导轨-1 | 通孔连接，配ISO4032标准六角螺母
F141 | 螺钉 | JISB1111_十字盘头_M2x8 | JIS B 1111:2017 十字槽盘头 | 2.0 | 8.0 | 0.4 | 1 | 前伸齿条-1 + 升降台250mm导轨-1 | 受限孔采用标准十字槽盘头 Ø3.5×1.3；保持板件、导轨及原孔尺寸。 反向装入，头部落入导轨原沉孔；螺母位于齿条外侧。
F142 | 螺母 | ISO4032_M2螺母 | ISO 4032 | 2.0 | 1.6 | 0.4 | 1 | 前伸齿条-1 + 升降台250mm导轨-1 | 通孔连接，配ISO4032标准六角螺母
F143 | 螺钉 | JISB1111_十字盘头_M2x8 | JIS B 1111:2017 十字槽盘头 | 2.0 | 8.0 | 0.4 | 1 | 前伸齿条-1 + 升降台250mm导轨-1 | 头部落入导轨沉孔、螺母位于齿条外侧；舵机支架由其两处 M3 连接独立夹紧，不让 M2 螺杆横穿滑块通道。
F144 | 螺母 | ISO4032_M2螺母 | ISO 4032 | 2.0 | 1.6 | 0.4 | 1 | 前伸齿条-1 + 升降台250mm导轨-1 | 头部落入导轨沉孔、螺母位于齿条外侧；舵机支架由其两处 M3 连接独立夹紧，不让 M2 螺杆横穿滑块通道。
F145 | 螺钉 | JISB1111_十字盘头_M2x8 | JIS B 1111:2017 十字槽盘头 | 2.0 | 8.0 | 0.4 | 1 | 前伸齿条-1 + 升降台250mm导轨-1 | 受限孔采用标准十字槽盘头 Ø3.5×1.3；保持板件、导轨及原孔尺寸。 反向装入，头部落入导轨原沉孔；螺母位于齿条外侧。
F146 | 螺母 | ISO4032_M2螺母 | ISO 4032 | 2.0 | 1.6 | 0.4 | 1 | 前伸齿条-1 + 升降台250mm导轨-1 | 通孔连接，配ISO4032标准六角螺母
F147 | 螺钉 | JISB1111_十字盘头_M2x8 | JIS B 1111:2017 十字槽盘头 | 2.0 | 8.0 | 0.4 | 1 | 前伸齿条-1 + 升降台250mm导轨-1 | 受限孔采用标准十字槽盘头 Ø3.5×1.3；保持板件、导轨及原孔尺寸。 反向装入，头部落入导轨原沉孔；螺母位于齿条外侧。
F148 | 螺母 | ISO4032_M2螺母 | ISO 4032 | 2.0 | 1.6 | 0.4 | 1 | 前伸齿条-1 + 升降台250mm导轨-1 | 通孔连接，配ISO4032标准六角螺母
F149 | 螺钉 | JISB1111_十字盘头_M2x8 | JIS B 1111:2017 十字槽盘头 | 2.0 | 8.0 | 0.4 | 1 | 前伸齿条-1 + 升降台250mm导轨-1 | 受限孔采用标准十字槽盘头 Ø3.5×1.3；保持板件、导轨及原孔尺寸。 反向装入，头部落入导轨原沉孔；螺母位于齿条外侧。
F150 | 螺母 | ISO4032_M2螺母 | ISO 4032 | 2.0 | 1.6 | 0.4 | 1 | 前伸齿条-1 + 升降台250mm导轨-1 | 通孔连接，配ISO4032标准六角螺母
F151 | 螺钉 | JISB1111_十字盘头_M2x8 | JIS B 1111:2017 十字槽盘头 | 2.0 | 8.0 | 0.4 | 1 | 前伸齿条-1 + 升降台250mm导轨-1 | 受限孔采用标准十字槽盘头 Ø3.5×1.3；保持板件、导轨及原孔尺寸。 反向装入，头部落入导轨原沉孔；螺母位于齿条外侧。
F152 | 螺母 | ISO4032_M2螺母 | ISO 4032 | 2.0 | 1.6 | 0.4 | 1 | 前伸齿条-1 + 升降台250mm导轨-1 | 通孔连接，配ISO4032标准六角螺母
F153 | 螺钉 | JISB1111_十字盘头_M2x8 | JIS B 1111:2017 十字槽盘头 | 2.0 | 8.0 | 0.4 | 1 | 前伸齿条-1 + 升降台250mm导轨-1 | 受限孔采用标准十字槽盘头 Ø3.5×1.3；保持板件、导轨及原孔尺寸。 反向装入，头部落入导轨原沉孔；螺母位于齿条外侧。
F154 | 螺母 | ISO4032_M2螺母 | ISO 4032 | 2.0 | 1.6 | 0.4 | 1 | 前伸齿条-1 + 升降台250mm导轨-1 | 通孔连接，配ISO4032标准六角螺母
F155 | 螺钉 | SEC_十字超薄头_M3x16 | NBK SEC/SECS 目录尺寸 | 3.0 | 16.0 | 0.5 | 1 | 前伸齿条-1 + 舵机座L形架-3 | 按现有孔径选型；按已确认的十字超薄头系列，头径 6、头厚 0.8 mm。；相邻螺钉采用相反装入方向并调整六角螺母周向，以避让紧邻头部；杆径、杆长、夹持面不变。
F156 | 螺母 | ISO4032_M3螺母 | ISO4032 | 3.0 | 2.4 | 0.5 | 1 | 前伸齿条-1 + 舵机座L形架-3 | 通孔连接，配ISO4032标准六角螺母；相邻螺钉采用相反装入方向并调整六角螺母周向，以避让紧邻头部；杆径、杆长、夹持面不变。
F157 | 螺钉 | SEC_十字超薄头_M3x16 | NBK SEC/SECS 目录尺寸 | 3.0 | 16.0 | 0.5 | 1 | 前伸齿条-1 + 舵机座L形架-3 | 按现有孔径选型；按已确认的十字超薄头系列，头径 6、头厚 0.8 mm。
F158 | 螺母 | ISO4032_M3螺母 | ISO4032 | 3.0 | 2.4 | 0.5 | 1 | 前伸齿条-1 + 舵机座L形架-3 | 通孔连接，配ISO4032标准六角螺母
F159 | 螺钉 | JISB1111_十字盘头_M2x12 | JIS B 1111:2017 十字槽盘头 | 2.0 | 12.0 | 0.4 | 1 | 前伸限位块-1 + 升降台250mm导轨-1 | 受限孔采用标准十字槽盘头 Ø3.5×1.3；保持板件、导轨及原孔尺寸。
F160 | 螺母 | ISO4032_M2螺母 | ISO 4032 | 2.0 | 1.6 | 0.4 | 1 | 前伸限位块-1 + 升降台250mm导轨-1 | 通孔连接，配ISO4032标准六角螺母
F161 | 螺钉 | JISB1111_十字盘头_M2x12 | JIS B 1111:2017 十字槽盘头 | 2.0 | 12.0 | 0.4 | 1 | 前伸限位块-1 + 升降台250mm导轨-1 | 受限孔采用标准十字槽盘头 Ø3.5×1.3；保持板件、导轨及原孔尺寸。
F162 | 螺母 | ISO4032_M2螺母 | ISO 4032 | 2.0 | 1.6 | 0.4 | 1 | 前伸限位块-1 + 升降台250mm导轨-1 | 通孔连接，配ISO4032标准六角螺母
F163 | 螺钉 | SEC_十字超薄头_M3x16 | NBK SEC/SECS 目录尺寸 | 3.0 | 16.0 | 0.5 | 1 | 升降台从动爪齿轮-1 + 镜向初赛夹爪-4 | 空间受限位置采用十字槽盘头，头径5.5、头高2.0 mm；保持原杆径和头下长度。；按已确认的十字超薄头系列，头径 6、头厚 0.8 mm。；相邻螺钉采用相反装入方向并调整六角螺母周向，以避让紧邻头部；杆径、杆长、夹持面不变。
F164 | 螺母 | ISO4032_M3螺母 | ISO4032 | 3.0 | 2.4 | 0.5 | 1 | 升降台从动爪齿轮-1 + 镜向初赛夹爪-4 | 通孔连接，配ISO4032标准六角螺母；相邻螺钉采用相反装入方向并调整六角螺母周向，以避让紧邻头部；杆径、杆长、夹持面不变。
F165 | 螺钉 | SEC_十字超薄头_M3x16 | NBK SEC/SECS 目录尺寸 | 3.0 | 16.0 | 0.5 | 1 | 升降台从动爪齿轮-1 + 镜向初赛夹爪-4 | 空间受限位置采用十字槽盘头，头径5.5、头高2.0 mm；保持原杆径和头下长度。；按已确认的十字超薄头系列，头径 6、头厚 0.8 mm。；相邻螺钉采用相反装入方向并调整六角螺母周向，以避让紧邻头部；杆径、杆长、夹持面不变。
F166 | 螺母 | ISO4032_M3螺母 | ISO4032 | 3.0 | 2.4 | 0.5 | 1 | 升降台从动爪齿轮-1 + 镜向初赛夹爪-4 | 通孔连接，配ISO4032标准六角螺母；相邻螺钉采用相反装入方向并调整六角螺母周向，以避让紧邻头部；杆径、杆长、夹持面不变。
F167 | 螺钉 | SEC_十字超薄头_M3x16 | NBK SEC/SECS 目录尺寸 | 3.0 | 16.0 | 0.5 | 1 | 初赛夹爪-1 + 升降台主动爪齿轮-2 | 空间受限位置采用十字槽盘头，头径5.5、头高2.0 mm；保持原杆径和头下长度。；按已确认的十字超薄头系列，头径 6、头厚 0.8 mm。；相邻螺钉采用相反装入方向并调整六角螺母周向，以避让紧邻头部；杆径、杆长、夹持面不变。
F168 | 螺母 | ISO4032_M3螺母 | ISO4032 | 3.0 | 2.4 | 0.5 | 1 | 初赛夹爪-1 + 升降台主动爪齿轮-2 | 通孔连接，配ISO4032标准六角螺母；相邻螺钉采用相反装入方向并调整六角螺母周向，以避让紧邻头部；杆径、杆长、夹持面不变。
F169 | 螺钉 | SEC_十字超薄头_M3x16 | NBK SEC/SECS 目录尺寸 | 3.0 | 16.0 | 0.5 | 1 | 初赛夹爪-1 + 升降台主动爪齿轮-2 | 空间受限位置采用十字槽盘头，头径5.5、头高2.0 mm；保持原杆径和头下长度。；按已确认的十字超薄头系列，头径 6、头厚 0.8 mm。；相邻螺钉采用相反装入方向并调整六角螺母周向，以避让紧邻头部；杆径、杆长、夹持面不变。
F170 | 螺母 | ISO4032_M3螺母 | ISO4032 | 3.0 | 2.4 | 0.5 | 1 | 初赛夹爪-1 + 升降台主动爪齿轮-2 | 通孔连接，配ISO4032标准六角螺母；相邻螺钉采用相反装入方向并调整六角螺母周向，以避让紧邻头部；杆径、杆长、夹持面不变。
F171 | 螺钉 | SEC_十字超薄头_M3x25 | NBK SEC/SECS 目录尺寸 | 3.0 | 25.0 | 0.5 | 1 | 1云台装配-2/10mm铜柱-1 + 1云台装配-2/舵机夹片-1 + 1云台装配-2/轴承夹片（大）-1 + 轴承夹片（大）-1 | 铜柱两端分别旋入，不加螺母；按现有孔径选型；按已确认的十字超薄头系列，头径 6、头厚 0.8 mm。
F172 | 螺钉 | SEC_十字超薄头_M3x6 | NBK SEC/SECS 目录尺寸 | 3.0 | 6.0 | 0.5 | 1 | 1云台装配-2/10mm铜柱-1 + 1云台装配-2/舵机夹片-1 + 1云台装配-2/轴承夹片（大）-1 + 轴承夹片（大）-1 | 铜柱两端分别旋入，不加螺母；按现有孔径选型；按已确认的十字超薄头系列，头径 6、头厚 0.8 mm。
F173 | 螺钉 | SEC_十字超薄头_M3x25 | NBK SEC/SECS 目录尺寸 | 3.0 | 25.0 | 0.5 | 1 | 1云台装配-2/10mm铜柱-3 + 1云台装配-2/舵机夹片-1 + 1云台装配-2/轴承夹片（大）-1 + 轴承夹片（大）-1 | 铜柱两端分别旋入，不加螺母；按现有孔径选型；按已确认的十字超薄头系列，头径 6、头厚 0.8 mm。
F174 | 螺钉 | SEC_十字超薄头_M3x6 | NBK SEC/SECS 目录尺寸 | 3.0 | 6.0 | 0.5 | 1 | 1云台装配-2/10mm铜柱-3 + 1云台装配-2/舵机夹片-1 + 1云台装配-2/轴承夹片（大）-1 + 轴承夹片（大）-1 | 铜柱两端分别旋入，不加螺母；按现有孔径选型；按已确认的十字超薄头系列，头径 6、头厚 0.8 mm。
F175 | 螺钉 | SEC_十字超薄头_M3x25 | NBK SEC/SECS 目录尺寸 | 3.0 | 25.0 | 0.5 | 1 | 1云台装配-2/10mm铜柱-2 + 1云台装配-2/舵机夹片-1 + 1云台装配-2/轴承夹片（大）-1 + 轴承夹片（大）-1 | 铜柱两端分别旋入，不加螺母；按现有孔径选型；按已确认的十字超薄头系列，头径 6、头厚 0.8 mm。
F176 | 螺钉 | SEC_十字超薄头_M3x6 | NBK SEC/SECS 目录尺寸 | 3.0 | 6.0 | 0.5 | 1 | 1云台装配-2/10mm铜柱-2 + 1云台装配-2/舵机夹片-1 + 1云台装配-2/轴承夹片（大）-1 + 轴承夹片（大）-1 | 铜柱两端分别旋入，不加螺母；按现有孔径选型；按已确认的十字超薄头系列，头径 6、头厚 0.8 mm。
F177 | 螺钉 | SEC_十字超薄头_M3x25 | NBK SEC/SECS 目录尺寸 | 3.0 | 25.0 | 0.5 | 1 | 1云台装配-2/10mm铜柱-4 + 1云台装配-2/舵机夹片-1 + 1云台装配-2/轴承夹片（大）-1 + 轴承夹片（大）-1 | 铜柱两端分别旋入，不加螺母；按现有孔径选型；按已确认的十字超薄头系列，头径 6、头厚 0.8 mm。
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
F254 | 螺母 | ISO4032_M3螺母 | ISO4032 | 3.0 | 2.4 | 0.5 | 1 | 升降台升降底座-3 + 导轨L形架v4-1 | 原底槽连接，配标准六角螺母。
F255 | 螺钉 | SEC_十字超薄头_M3x12 | NBK SEC/SECS 目录尺寸 | 3.0 | 12.0 | 0.5 | 1 | 升降台升降底座-3 + 导轨L形架v4-2 | 薄头螺钉夹紧原长槽，螺栓轴线保持与底座孔同心；底槽调位后紧固。；按已确认的十字超薄头系列，头径 6、头厚 0.8 mm。
F256 | 螺母 | ISO4032_M3螺母 | ISO4032 | 3.0 | 2.4 | 0.5 | 1 | 升降台升降底座-3 + 导轨L形架v4-2 | 原底槽连接，配标准六角螺母。
F257 | 螺钉 | SEC_十字超薄头_M3x12 | NBK SEC/SECS 目录尺寸 | 3.0 | 12.0 | 0.5 | 1 | 升降台升降底座-3 + 导轨L形架v4-1 | 薄头螺钉夹紧原长槽，螺栓轴线保持与底座孔同心；底槽调位后紧固。；按已确认的十字超薄头系列，头径 6、头厚 0.8 mm。
F258 | 螺母 | ISO4032_M3螺母 | ISO4032 | 3.0 | 2.4 | 0.5 | 1 | 升降台升降底座-3 + 导轨L形架v4-1 | 原底槽连接，配标准六角螺母。
F259 | 螺钉 | SEC_十字超薄头_M3x12 | NBK SEC/SECS 目录尺寸 | 3.0 | 12.0 | 0.5 | 1 | 升降台升降底座-3 + 导轨L形架v3-2 | 原 v3 底槽连接，以底座圆孔确定螺钉轴线，夹紧槽面；不改孔槽尺寸。；按已确认的十字超薄头系列，头径 6、头厚 0.8 mm。
F260 | 螺母 | ISO4032_M3螺母 | ISO4032 | 3.0 | 2.4 | 0.5 | 1 | 升降台升降底座-3 + 导轨L形架v3-2 | 原 v3 底槽连接，以底座圆孔确定螺钉轴线，夹紧槽面；不改孔槽尺寸。
F261 | 螺钉 | SEC_十字超薄头_M3x12 | NBK SEC/SECS 目录尺寸 | 3.0 | 12.0 | 0.5 | 1 | 升降台升降底座-3 + 导轨L形架v3-2 | 原 v3 底槽连接，以底座圆孔确定螺钉轴线，夹紧槽面；不改孔槽尺寸。；按已确认的十字超薄头系列，头径 6、头厚 0.8 mm。
F262 | 螺母 | ISO4032_M3螺母 | ISO4032 | 3.0 | 2.4 | 0.5 | 1 | 升降台升降底座-3 + 导轨L形架v3-2 | 原 v3 底槽连接，以底座圆孔确定螺钉轴线，夹紧槽面；不改孔槽尺寸。
F263 | 螺钉 | SEC_十字超薄头_M3x12 | NBK SEC/SECS 目录尺寸 | 3.0 | 12.0 | 0.5 | 1 | 升降台升降底座-3 + 导轨L形架v3-1 | 原 v3 底槽连接，以底座圆孔确定螺钉轴线，夹紧槽面；不改孔槽尺寸。；按已确认的十字超薄头系列，头径 6、头厚 0.8 mm。
F264 | 螺母 | ISO4032_M3螺母 | ISO4032 | 3.0 | 2.4 | 0.5 | 1 | 升降台升降底座-3 + 导轨L形架v3-1 | 原 v3 底槽连接，以底座圆孔确定螺钉轴线，夹紧槽面；不改孔槽尺寸。
F265 | 螺钉 | SEC_十字超薄头_M3x12 | NBK SEC/SECS 目录尺寸 | 3.0 | 12.0 | 0.5 | 1 | 升降台升降底座-3 + 导轨L形架v3-1 | 原 v3 底槽连接，以底座圆孔确定螺钉轴线，夹紧槽面；不改孔槽尺寸。；按已确认的十字超薄头系列，头径 6、头厚 0.8 mm。
F266 | 螺母 | ISO4032_M3螺母 | ISO4032 | 3.0 | 2.4 | 0.5 | 1 | 升降台升降底座-3 + 导轨L形架v3-1 | 原 v3 底槽连接，以底座圆孔确定螺钉轴线，夹紧槽面；不改孔槽尺寸。
F267 | 螺钉 | SEC_十字超薄头_M5x20 | NBK SEC/SECS 目录尺寸 | 5.0 | 20.0 | 0.8 | 1 | 升降台惰轮座底部轴向连接 | 按惰轮座实际 Ø5.1 孔对正；螺钉头、螺母分别在 4 mm 支承两侧就座，保留标准 M5×20 杆长。；按已确认的十字超薄头系列，头径 9、头厚 1.0 mm。
F268 | 螺母 | ISO4032_M5螺母 | ISO4032 | 5.0 | 4.7 | 0.8 | 1 | 升降台惰轮座底部轴向连接 | 按惰轮座实际 Ø5.1 孔对正；螺钉头、螺母分别在 4 mm 支承两侧就座，保留标准 M5×20 杆长。
F269 | 螺钉 | SEC_十字超薄头_M5x12 | NBK SEC/SECS 目录尺寸 | 5 | 12 | 0.8 | 1 | 铝管-1 + 导轨L形架v4-2 | 管内横向螺杆避让：原贯穿连接改为两侧分别紧固；采用现有 M5×12 标准薄头螺钉，头在管内，螺母在支架外侧。
F270 | 螺母 | ISO4032_M5螺母 | ISO4032 | 5 | 4.7 | 0.8 | 1 | 铝管-1 + 导轨L形架v4-2 | 管内横向螺杆避让：原贯穿连接改为两侧分别紧固；采用现有 M5×12 标准薄头螺钉，头在管内，螺母在支架外侧。
F271 | 螺钉 | SEC_十字超薄头_M5x12 | NBK SEC/SECS 目录尺寸 | 5 | 12 | 0.8 | 1 | 铝管-1 + 导轨L形架v4-2 | 管内横向螺杆避让：原贯穿连接改为两侧分别紧固；采用现有 M5×12 标准薄头螺钉，头在管内，螺母在支架外侧。
F272 | 螺母 | ISO4032_M5螺母 | ISO4032 | 5 | 4.7 | 0.8 | 1 | 铝管-1 + 导轨L形架v4-2 | 管内横向螺杆避让：原贯穿连接改为两侧分别紧固；采用现有 M5×12 标准薄头螺钉，头在管内，螺母在支架外侧。
F273 | 螺钉 | SEC_十字超薄头_M5x12 | NBK SEC/SECS 目录尺寸 | 5 | 12 | 0.8 | 1 | 铝管-2 + 导轨L形架v4-1 | 管内横向螺杆避让：原贯穿连接改为两侧分别紧固；采用现有 M5×12 标准薄头螺钉，头在管内，螺母在支架外侧。
F274 | 螺母 | ISO4032_M5螺母 | ISO4032 | 5 | 4.7 | 0.8 | 1 | 铝管-2 + 导轨L形架v4-1 | 管内横向螺杆避让：原贯穿连接改为两侧分别紧固；采用现有 M5×12 标准薄头螺钉，头在管内，螺母在支架外侧。
F275 | 螺钉 | SEC_十字超薄头_M5x12 | NBK SEC/SECS 目录尺寸 | 5 | 12 | 0.8 | 1 | 铝管-2 + 导轨L形架v4-1 | 管内横向螺杆避让：原贯穿连接改为两侧分别紧固；采用现有 M5×12 标准薄头螺钉，头在管内，螺母在支架外侧。
F276 | 螺母 | ISO4032_M5螺母 | ISO4032 | 5 | 4.7 | 0.8 | 1 | 铝管-2 + 导轨L形架v4-1 | 管内横向螺杆避让：原贯穿连接改为两侧分别紧固；采用现有 M5×12 标准薄头螺钉，头在管内，螺母在支架外侧。
