NONGbixi/GONGCHUANG_Intelligent_Logistics_Handling_Tower_Crane_Mechanical/模型/智梭_42步进电机.SLDASM

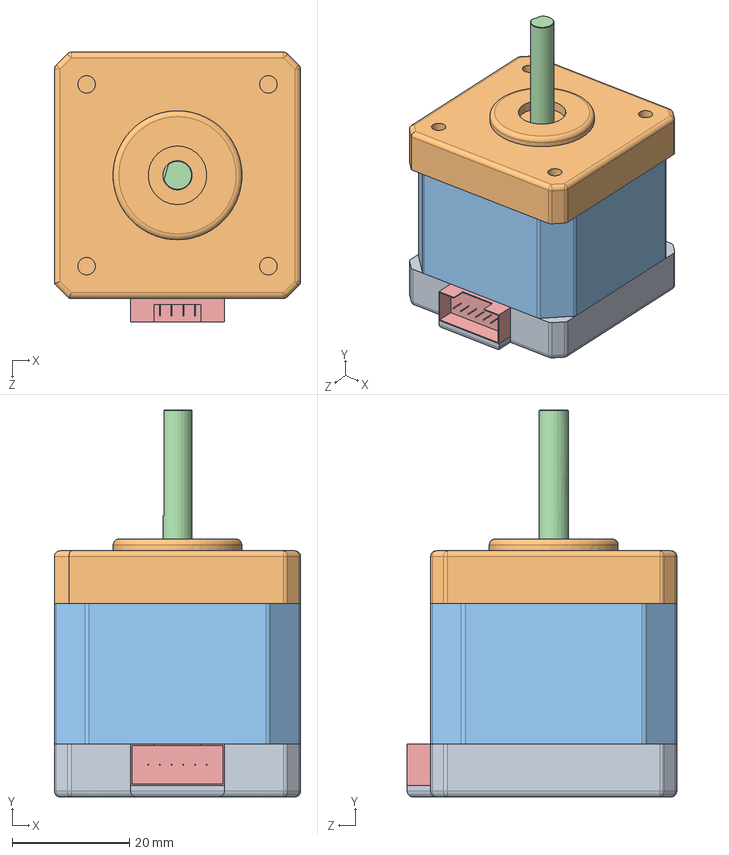
[picture p4: CAD file, 2026-10-18]
模型/智梭_42步进电机.SLDASM
42.0 x 66.0 x 46.0 mm
42步进电机-01
42步进电机-02
42步进电机-03
42步进电机-04
42步进电机-05
