NONGbixi/GONGCHUANG_Intelligent_Logistics_Handling_Tower_Crane_Mechanical/模型/智梭_转盘舵机座.SLDPRT

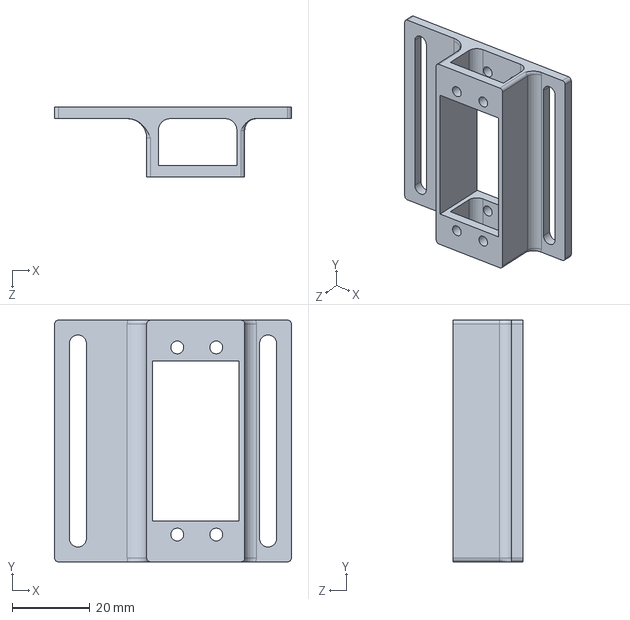
[picture p5: CAD file, 2026-10-24]
模型/智梭_转盘舵机座.SLDPRT
60.8 x 62.0 x 18.0 mm
