NONGbixi/GONGCHUANG_Intelligent_Logistics_Handling_Tower_Crane_Mechanical/模型/智梭_前伸水平轴连接板.SLDPRT

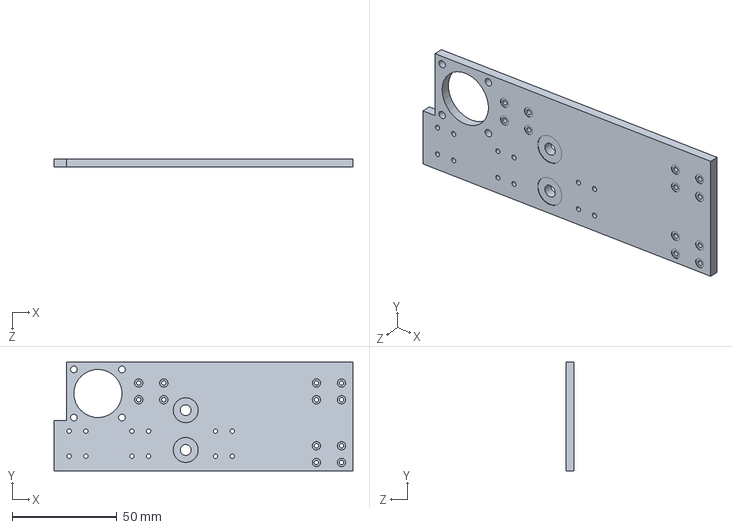
[picture p6: CAD file, 2026-10-24]
模型/智梭_前伸水平轴连接板.SLDPRT
143.0 x 52.0 x 4.00 mm
