NONGbixi/GONGCHUANG_Intelligent_Logistics_Handling_Tower_Crane_Mechanical/模型/智梭_升降台升降底座.SLDPRT

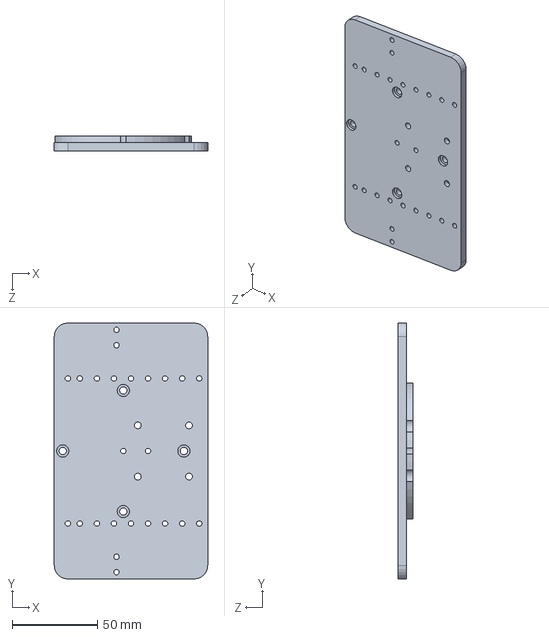
[picture p7: CAD file, 2026-10-24]
模型/智梭_升降台升降底座.SLDPRT
90.0 x 150.0 x 9.00 mm
