NONGbixi/GONGCHUANG_Intelligent_Logistics_Handling_Tower_Crane_Mechanical/模型/智梭_UVC摄像头.SLDPRT

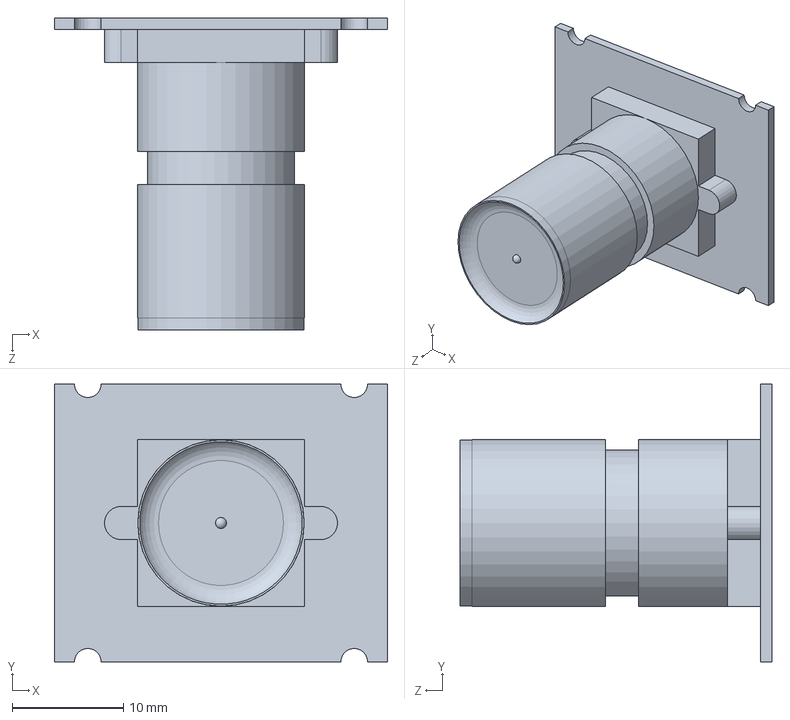
[picture p8: CAD file, 2026-10-24]
模型/智梭_UVC摄像头.SLDPRT
30.0 x 25.0 x 28.1 mm
