NONGbixi/GONGCHUANG_Intelligent_Logistics_Handling_Tower_Crane_Mechanical/模型/智梭_轴承夹片（小上）.SLDPRT

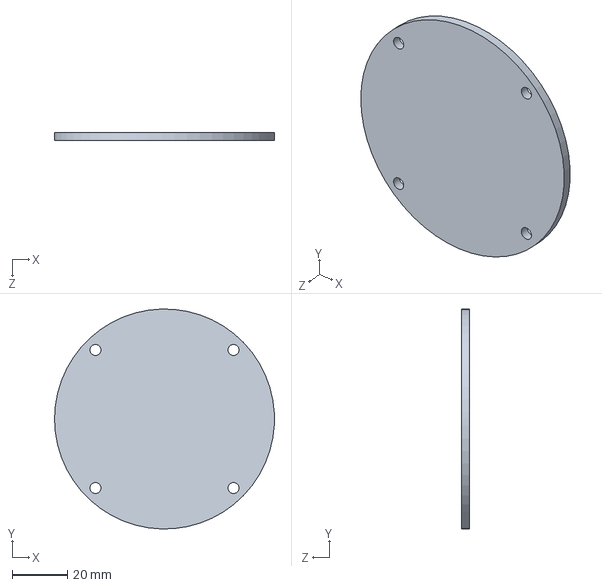
[picture p9: CAD file, 2026-10-24]
模型/智梭_轴承夹片（小上）.SLDPRT
80.0 x 80.0 x 3.00 mm
