NONGbixi/GONGCHUANG_Intelligent_Logistics_Handling_Tower_Crane_Mechanical/模型/智梭_转盘.SLDPRT

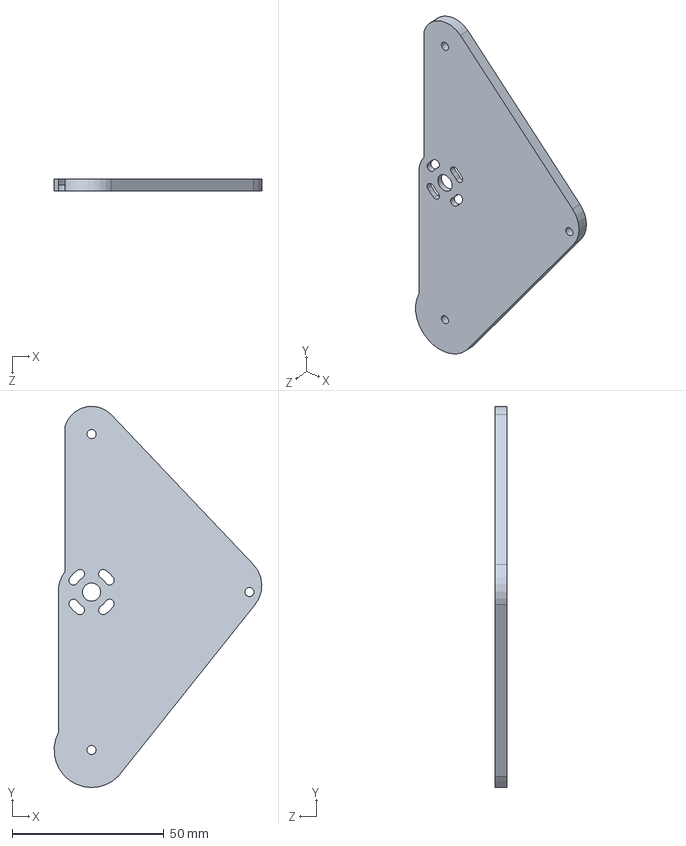
[picture p10: CAD file, 2026-10-24]
模型/智梭_转盘.SLDPRT
68.4 x 125.4 x 4.00 mm
