NONGbixi/GONGCHUANG_Intelligent_Logistics_Handling_Tower_Crane_Mechanical/模型/智梭_舵机夹片.SLDPRT

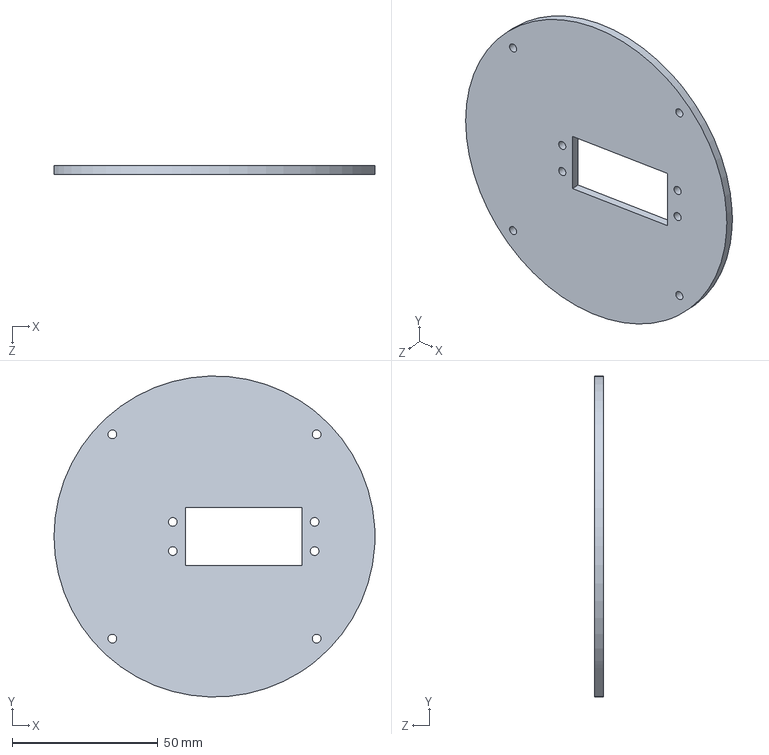
[picture p11: CAD file, 2026-10-24]
模型/智梭_舵机夹片.SLDPRT
110.0 x 110.0 x 3.00 mm
