NONGbixi/GONGCHUANG_Intelligent_Logistics_Handling_Tower_Crane_Mechanical/模型/智梭_云台托架.SLDPRT

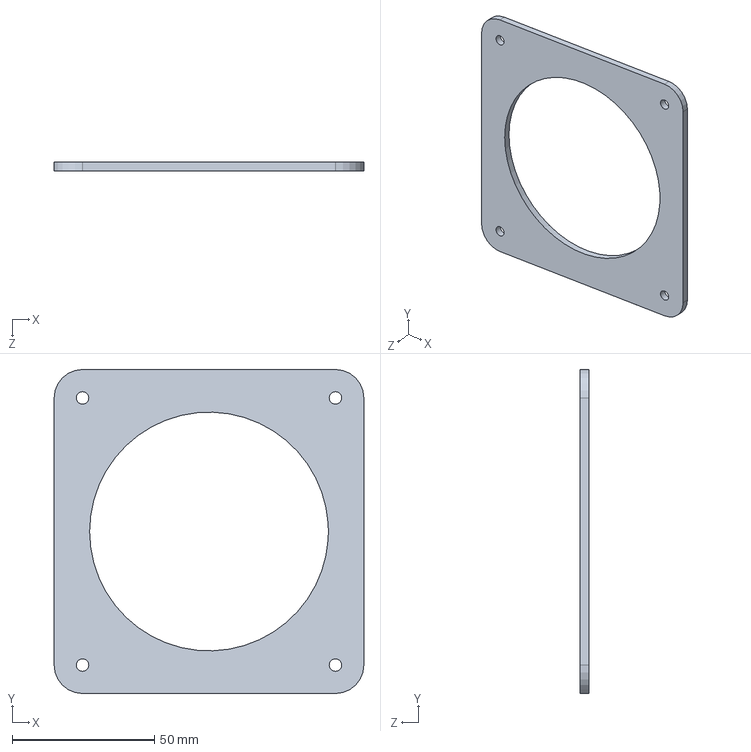
[picture p12: CAD file, 2026-10-24]
模型/智梭_云台托架.SLDPRT
109.0 x 114.0 x 3.00 mm
