NONGbixi/GONGCHUANG_Intelligent_Logistics_Handling_Tower_Crane_Mechanical/模型/智梭_舵机座L形架.SLDPRT

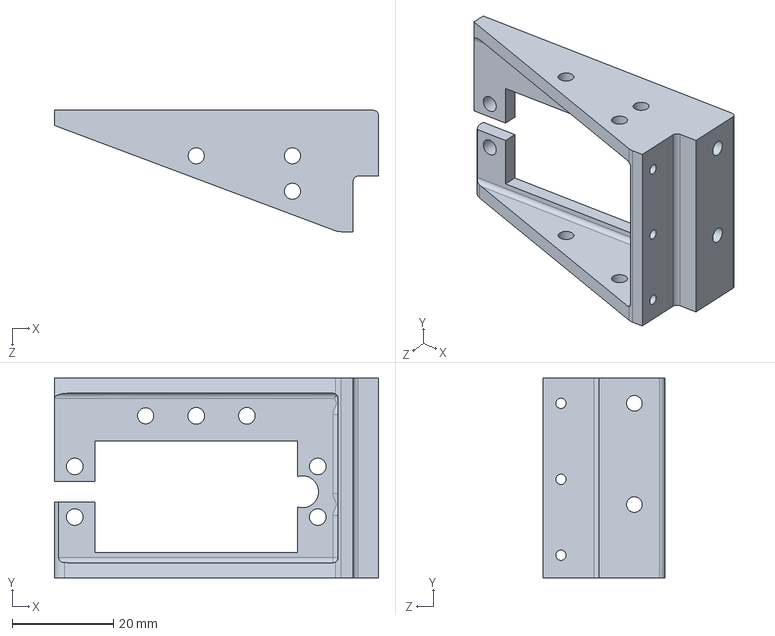
[picture p13: CAD file, 2026-10-23]
模型/智梭_舵机座L形架.SLDPRT
64.0 x 39.5 x 24.0 mm
