NONGbixi/GONGCHUANG_Intelligent_Logistics_Handling_Tower_Crane_Mechanical/模型/智梭_底板_增加11mm_2027独立版.SLDPRT

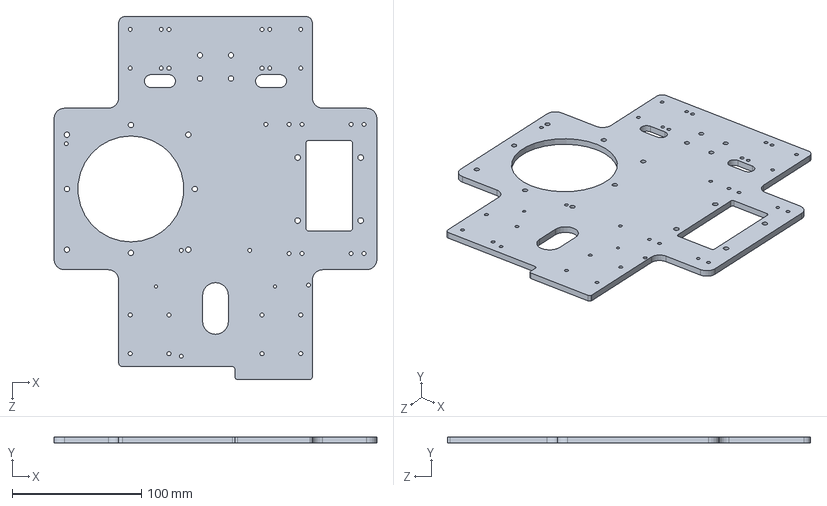
[picture p14: CAD file, 2026-10-23]
模型/智梭_底板_增加11mm_2027独立版.SLDPRT
250.0 x 5.00 x 281.0 mm
