NONGbixi/GONGCHUANG_Intelligent_Logistics_Handling_Tower_Crane_Mechanical/模型/智梭_地面.SLDPRT

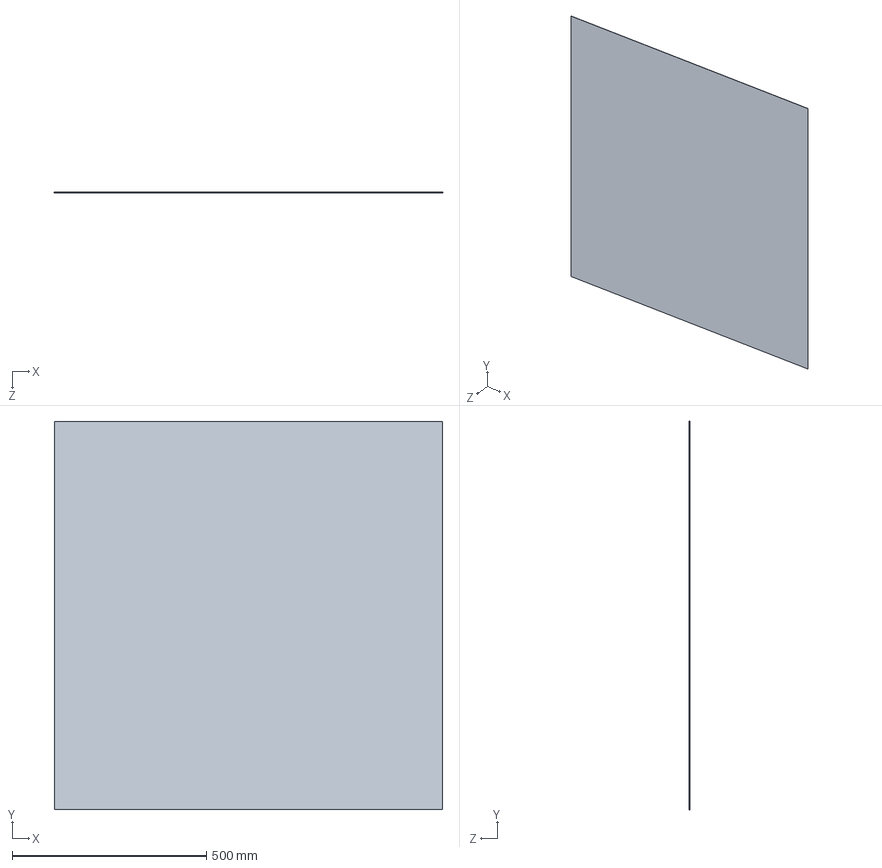
[picture p15: CAD file, 2026-10-23]
模型/智梭_地面.SLDPRT
1000.0 x 1000.0 x 1.00 mm
