NONGbixi/GONGCHUANG_Intelligent_Logistics_Handling_Tower_Crane_Mechanical/模型/智梭_JY62陀螺仪.SLDPRT

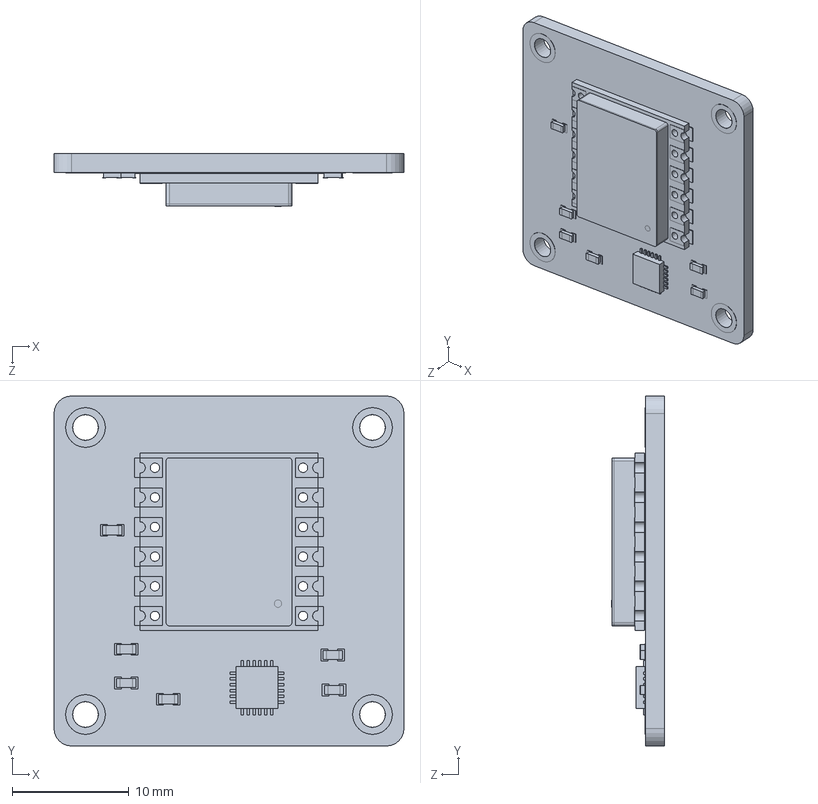
[picture p16: CAD file, 2026-10-21]
模型/智梭_JY62陀螺仪.SLDPRT
30.0 x 30.0 x 4.51 mm
