NONGbixi/GONGCHUANG_Intelligent_Logistics_Handling_Tower_Crane_Mechanical/模型/智梭_电池仓1.SLDPRT

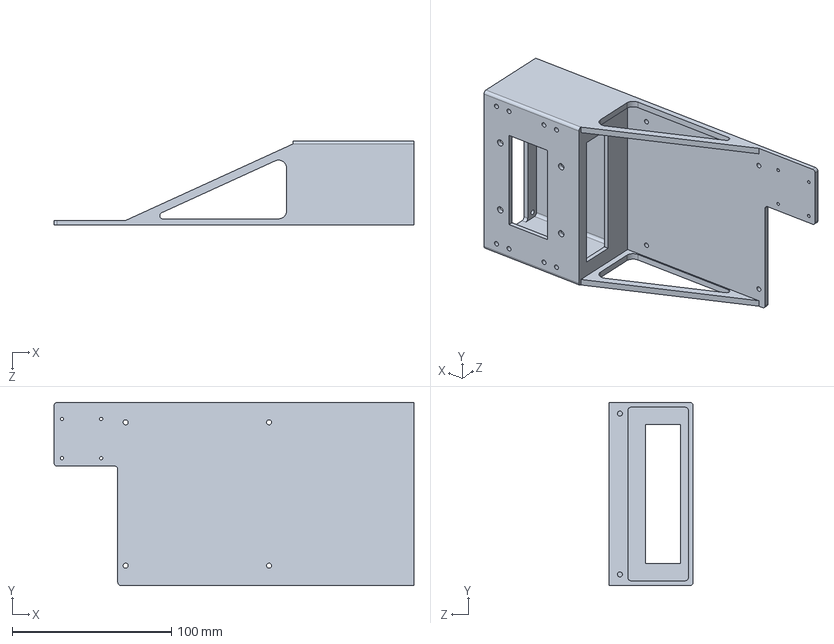
[picture p17: CAD file, 2026-10-21]
模型/智梭_电池仓1.SLDPRT
226.0 x 115.0 x 53.0 mm
