NONGbixi/GONGCHUANG_Intelligent_Logistics_Handling_Tower_Crane_Mechanical/模型/智梭_摄像头支架.SLDPRT

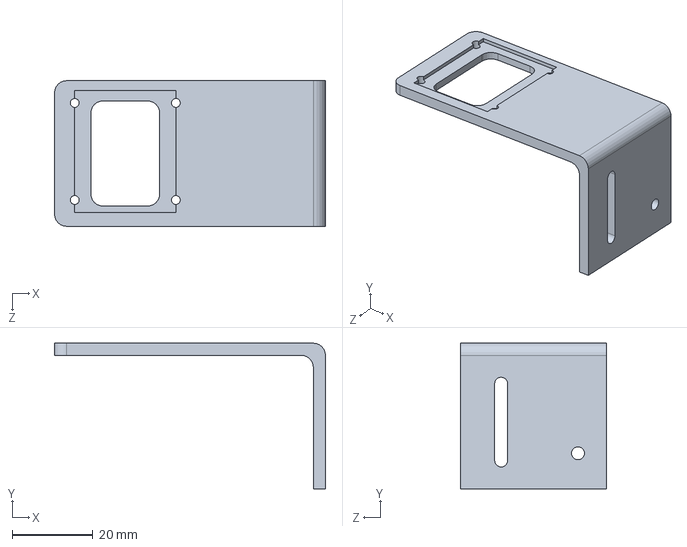
[picture p18: CAD file, 2026-10-21]
模型/智梭_摄像头支架.SLDPRT
67.0 x 36.0 x 36.0 mm
