NONGbixi/GONGCHUANG_Intelligent_Logistics_Handling_Tower_Crane_Mechanical/模型/智梭_初赛物料3.SLDPRT

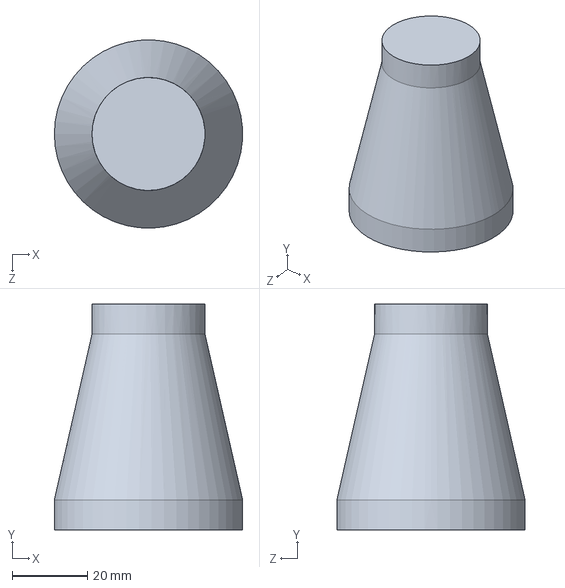
[picture p19: CAD file, 2026-10-21]
模型/智梭_初赛物料3.SLDPRT
50.0 x 60.0 x 50.0 mm
