NONGbixi/GONGCHUANG_Intelligent_Logistics_Handling_Tower_Crane_Mechanical/模型/智梭_电路板示意_100x100_孔距90.SLDPRT

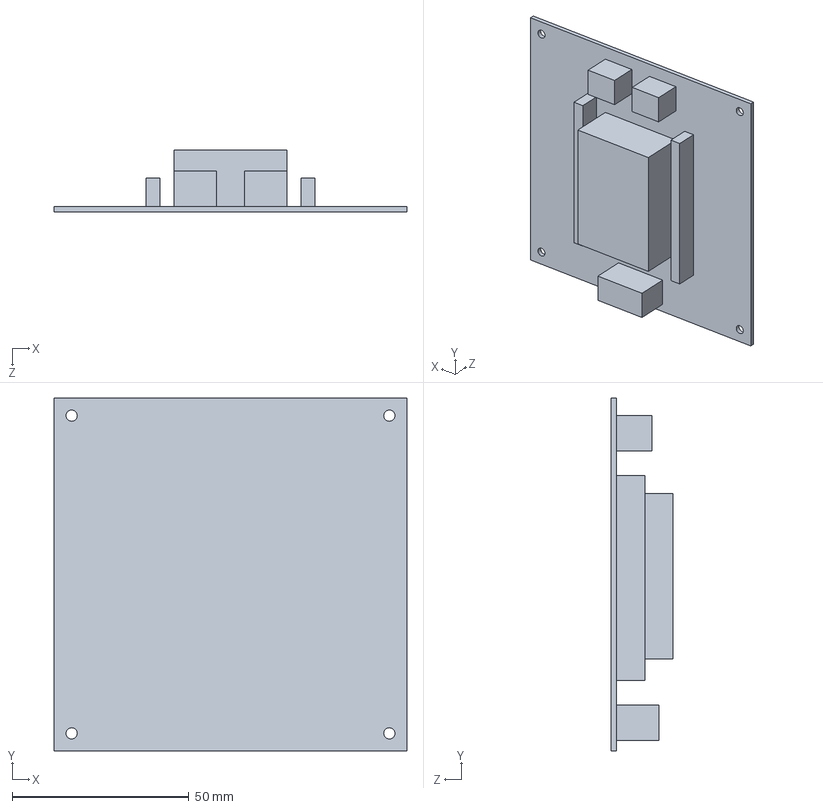
[picture p20: CAD file, 2026-10-20]
模型/智梭_电路板示意_100x100_孔距90.SLDPRT
100.0 x 100.0 x 17.6 mm
