NONGbixi/GONGCHUANG_Intelligent_Logistics_Handling_Tower_Crane_Mechanical/模型/智梭_调车用电池示意_70x70x80.SLDPRT

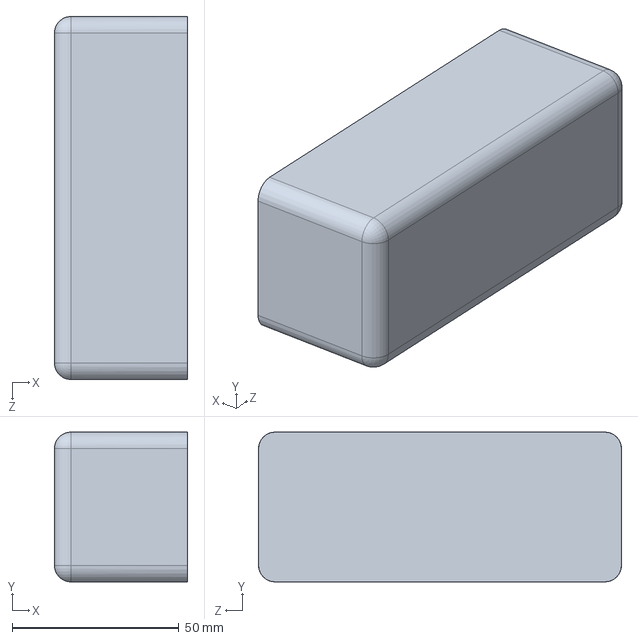
[picture p21: CAD file, 2026-10-20]
模型/智梭_调车用电池示意_70x70x80.SLDPRT
40.0 x 45.0 x 109.0 mm
