NONGbixi/GONGCHUANG_Intelligent_Logistics_Handling_Tower_Crane_Mechanical/模型/智梭_电池仓2.SLDPRT

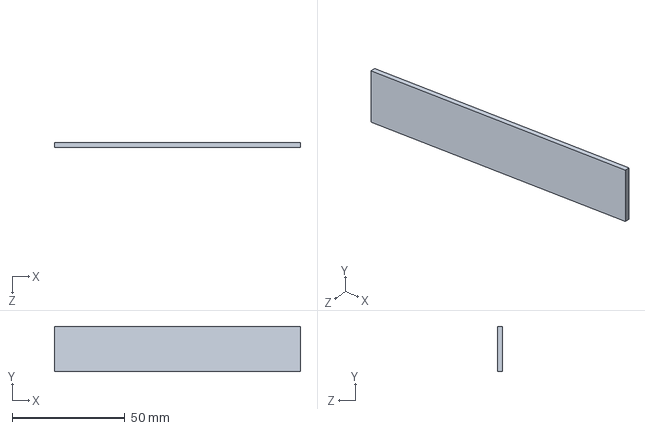
[picture p22: CAD file, 2026-10-20]
模型/智梭_电池仓2.SLDPRT
109.0 x 20.0 x 2.00 mm
