NONGbixi/GONGCHUANG_Intelligent_Logistics_Handling_Tower_Crane_Mechanical/模型/智梭_轴承夹片（大）.SLDPRT

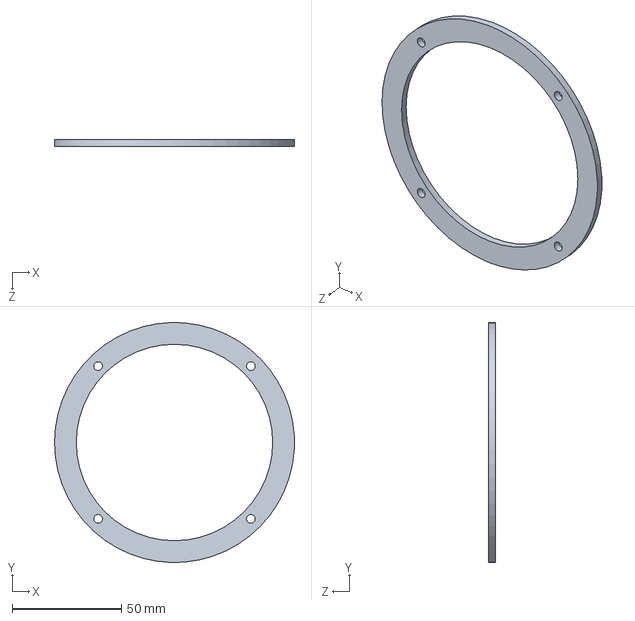
[picture p23: CAD file, 2026-10-20]
模型/智梭_轴承夹片（大）.SLDPRT
110.0 x 110.0 x 3.00 mm
