NONGbixi/GONGCHUANG_Intelligent_Logistics_Handling_Tower_Crane_Mechanical/模型/智梭_六角联轴器.SLDPRT

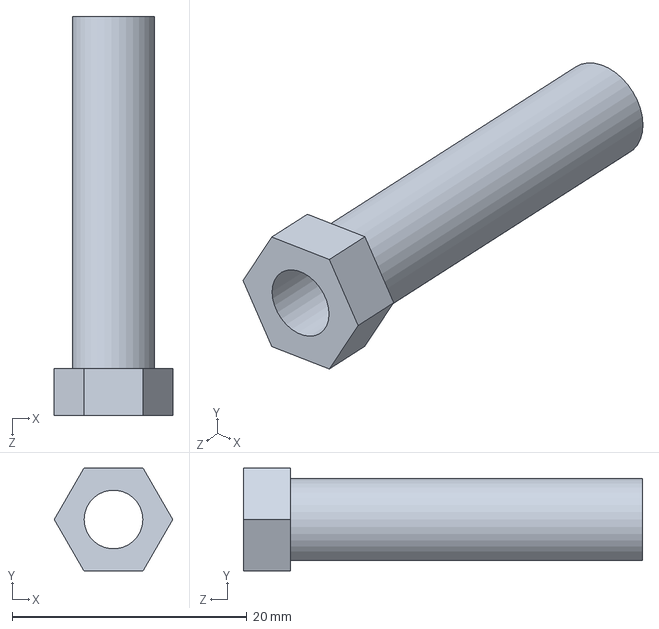
[picture p24: CAD file, 2026-10-20]
模型/智梭_六角联轴器.SLDPRT
10.1 x 8.75 x 34.0 mm
