NONGbixi/GONGCHUANG_Intelligent_Logistics_Handling_Tower_Crane_Mechanical/模型/智梭_麦轮（正）.SLDPRT

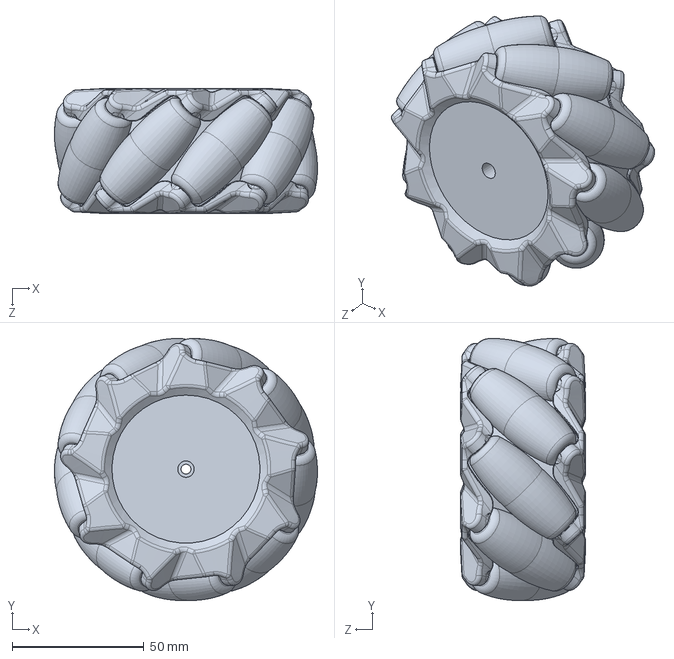
[picture p25: CAD file, 2026-10-20]
模型/智梭_麦轮（正）.SLDPRT
99.9 x 99.5 x 47.4 mm
