NONGbixi/GONGCHUANG_Intelligent_Logistics_Handling_Tower_Crane_Mechanical/模型/智梭_DIN7984_M4x12.SLDPRT

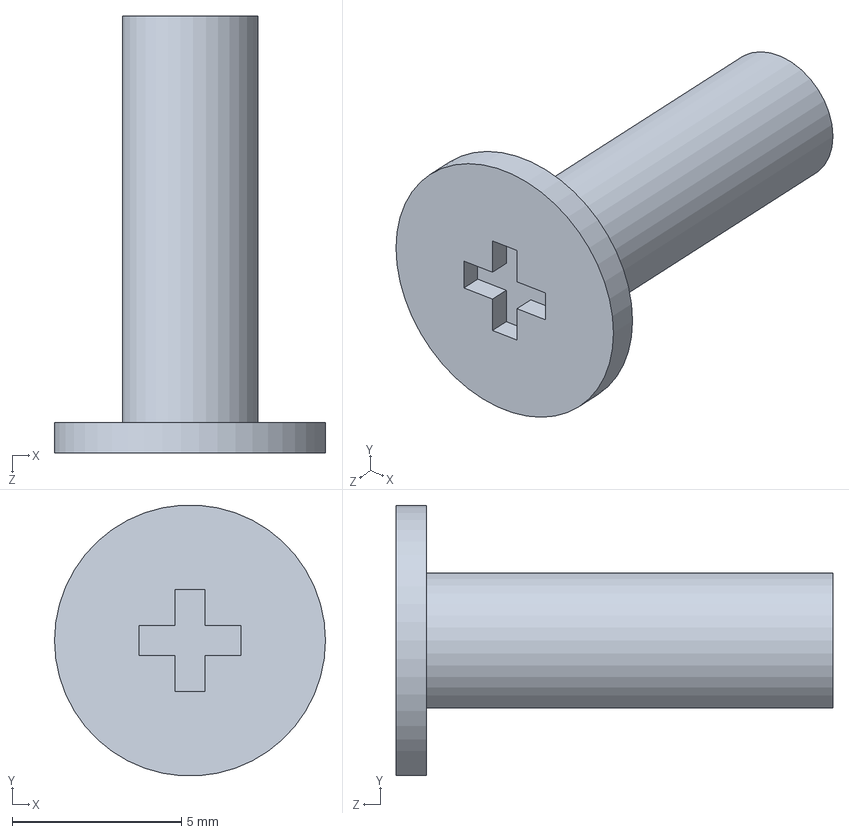
[picture p26: CAD file, 2026-10-19]
模型/智梭_DIN7984_M4x12.SLDPRT
8.00 x 7.98 x 12.9 mm
