NONGbixi/GONGCHUANG_Intelligent_Logistics_Handling_Tower_Crane_Mechanical/模型/智梭_升降台皮带固定片1.SLDPRT

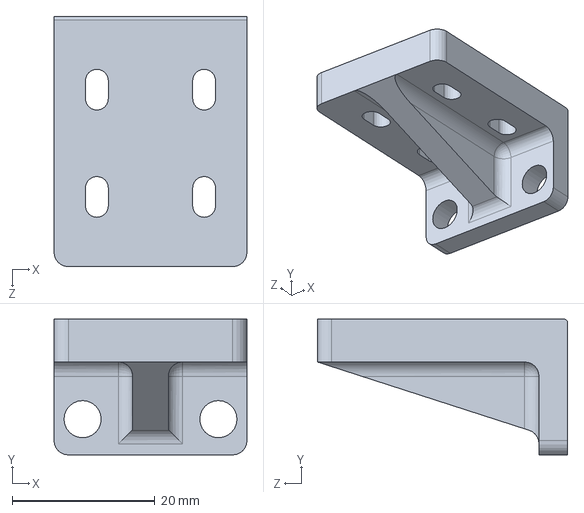
[picture p27: CAD file, 2026-10-19]
模型/智梭_升降台皮带固定片1.SLDPRT
27.0 x 19.0 x 35.0 mm
