NONGbixi/GONGCHUANG_Intelligent_Logistics_Handling_Tower_Crane_Mechanical/模型/智梭_初赛夹爪.SLDPRT

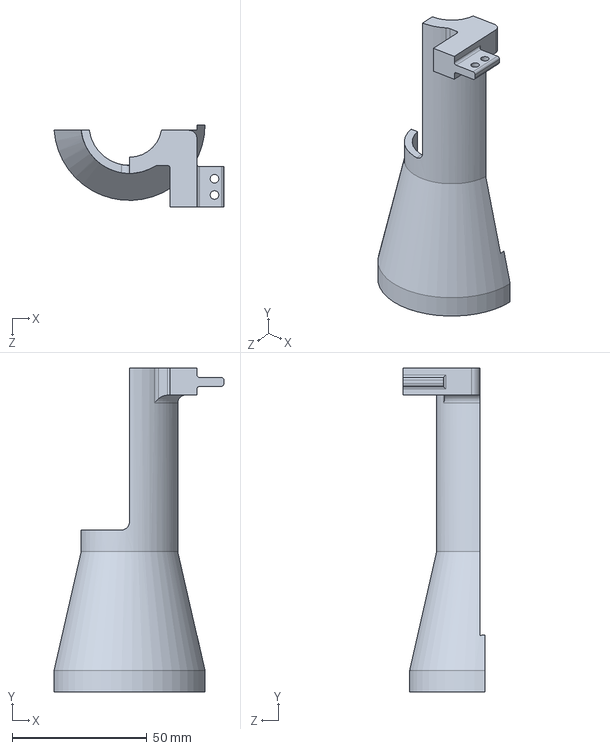
[picture p28: CAD file, 2026-10-18]
模型/智梭_初赛夹爪.SLDPRT
62.9 x 120.0 x 30.5 mm
