NONGbixi/GONGCHUANG_Intelligent_Logistics_Handling_Tower_Crane_Mechanical/模型/智梭_DIN7984_M3x12.SLDPRT

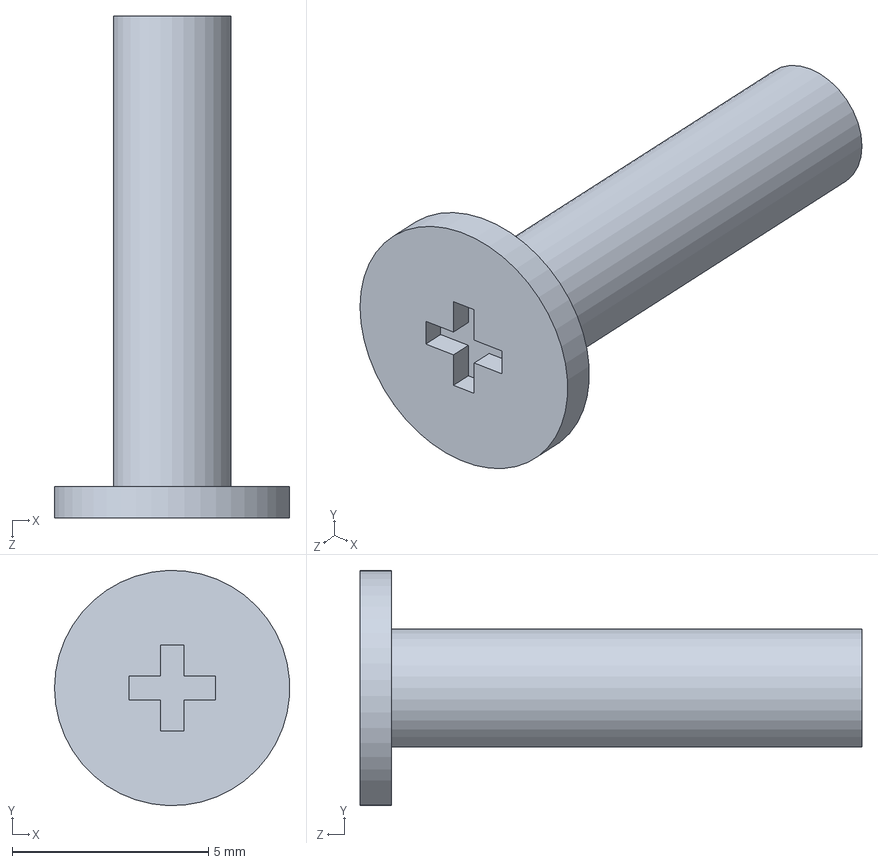
[picture p29: CAD file, 2026-10-18]
模型/智梭_DIN7984_M3x12.SLDPRT
5.99 x 6.00 x 12.8 mm
