NONGbixi/GONGCHUANG_Intelligent_Logistics_Handling_Tower_Crane_Mechanical/模型/智梭_DIN7984_M3x20.SLDPRT

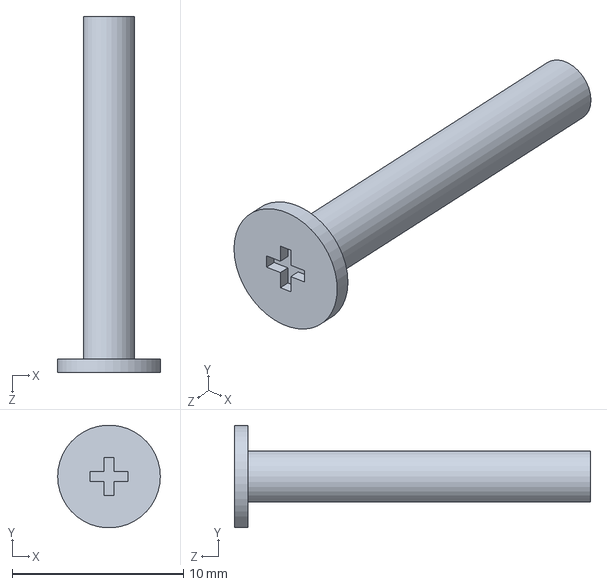
[picture p30: CAD file, 2026-10-18]
模型/智梭_DIN7984_M3x20.SLDPRT
6.00 x 5.98 x 20.8 mm
