NONGbixi/GONGCHUANG_Intelligent_Logistics_Handling_Tower_Crane_Mechanical/模型/智梭_DIN7984_M3x10.SLDPRT

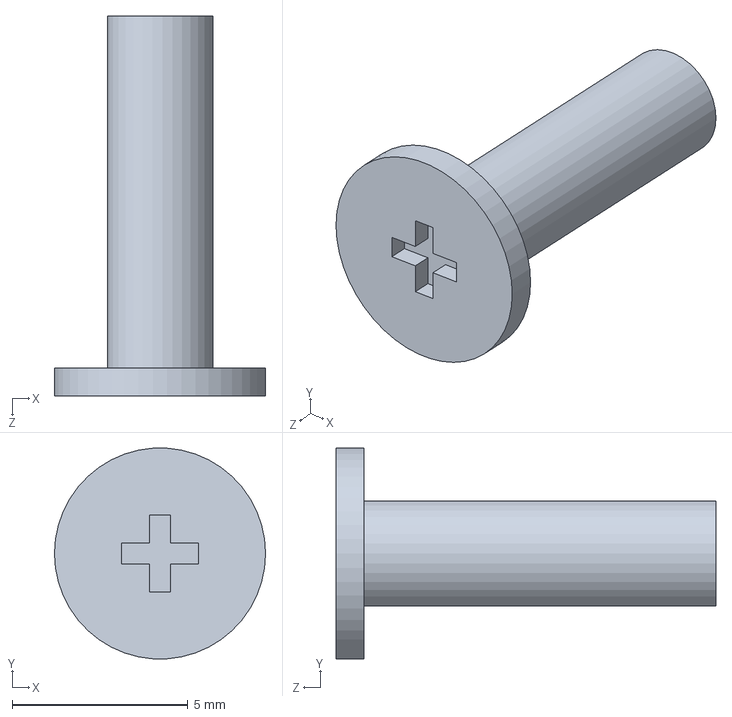
[picture p31: CAD file, 2026-10-18]
模型/智梭_DIN7984_M3x10.SLDPRT
6.00 x 5.99 x 10.8 mm
