NONGbixi/GONGCHUANG_Intelligent_Logistics_Handling_Tower_Crane_Mechanical/模型/智梭_42步进电机-02.SLDPRT

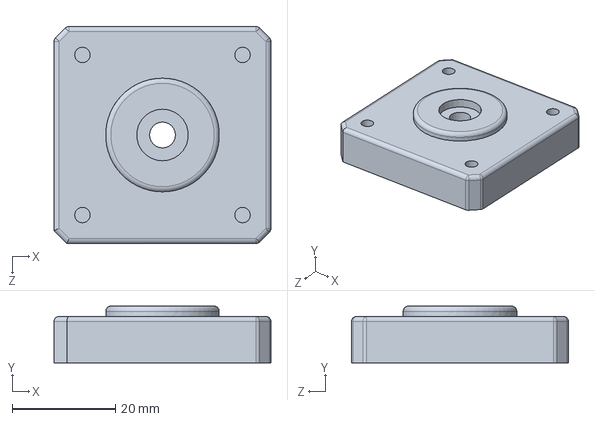
[picture p32: CAD file, 2026-10-18]
模型/智梭_42步进电机-02.SLDPRT
42.0 x 11.0 x 42.0 mm
