NONGbixi/GONGCHUANG_Intelligent_Logistics_Handling_Tower_Crane_Mechanical/模型/智梭_前伸齿条.SLDPRT

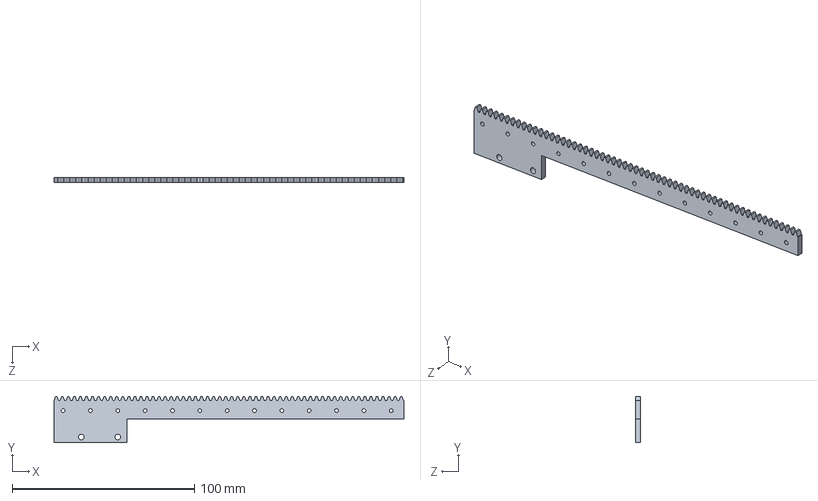
[picture p33: CAD file, 2026-10-18]
模型/智梭_前伸齿条.SLDPRT
192.0 x 25.2 x 3.00 mm
