NONGbixi/GONGCHUANG_Intelligent_Logistics_Handling_Tower_Crane_Mechanical/模型/智梭_DIN7984_M4x30.SLDPRT

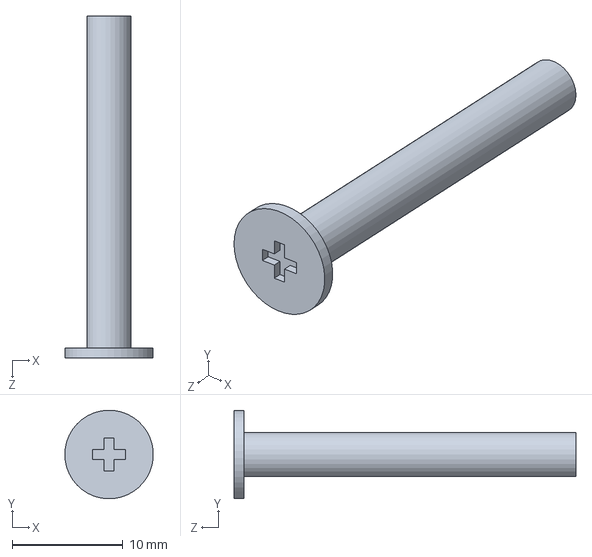
[picture p34: CAD file, 2026-10-18]
模型/智梭_DIN7984_M4x30.SLDPRT
7.99 x 7.99 x 30.9 mm
