NONGbixi/GONGCHUANG_Intelligent_Logistics_Handling_Tower_Crane_Mechanical/模型/智梭_导轨L形架v4.SLDPRT

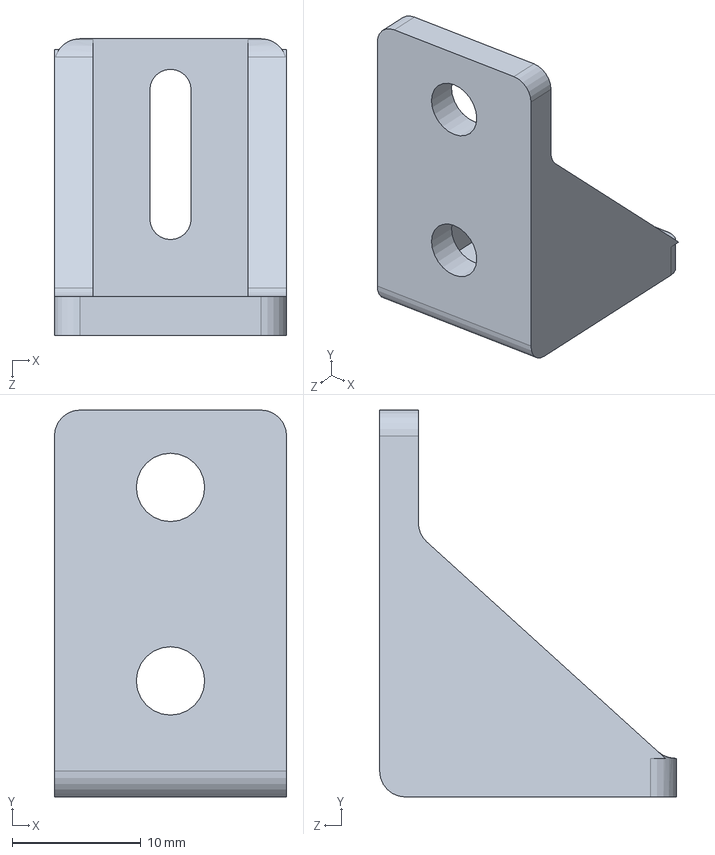
[picture p35: CAD file, 2026-10-18]
模型/智梭_导轨L形架v4.SLDPRT
18.0 x 30.0 x 23.0 mm
