NONGbixi/GONGCHUANG_Intelligent_Logistics_Handling_Tower_Crane_Mechanical/模型/智梭_DIN7984_M5x30.SLDPRT

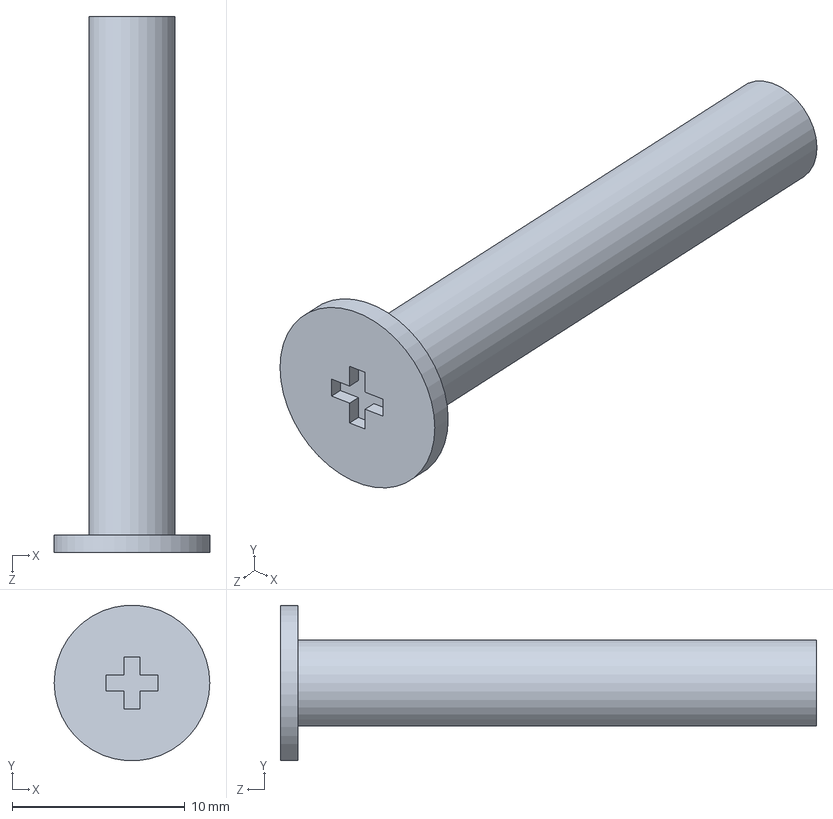
[picture p36: CAD file, 2026-10-18]
模型/智梭_DIN7984_M5x30.SLDPRT
9.00 x 8.97 x 31.0 mm
