NONGbixi/GONGCHUANG_Intelligent_Logistics_Handling_Tower_Crane_Mechanical/模型/智梭_升降台轴承.SLDPRT

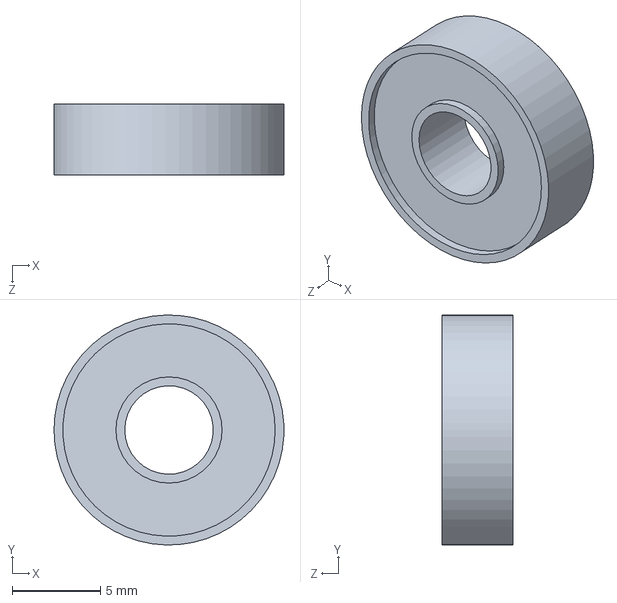
[picture p37: CAD file, 2026-10-18]
模型/智梭_升降台轴承.SLDPRT
13.0 x 13.0 x 4.00 mm
