NONGbixi/GONGCHUANG_Intelligent_Logistics_Handling_Tower_Crane_Mechanical/模型/智梭_42步进电机-04.SLDPRT

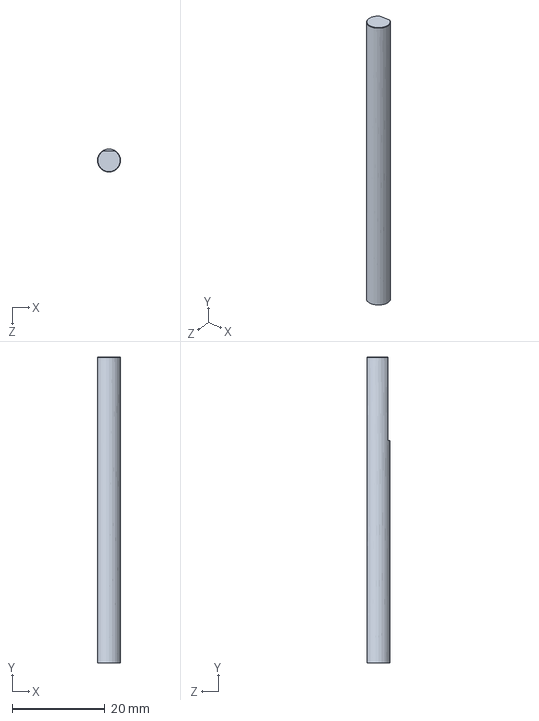
[picture p38: CAD file, 2026-10-18]
模型/智梭_42步进电机-04.SLDPRT
5.00 x 66.0 x 5.00 mm
