NONGbixi/GONGCHUANG_Intelligent_Logistics_Handling_Tower_Crane_Mechanical/模型/智梭_42步进电机-05.SLDPRT

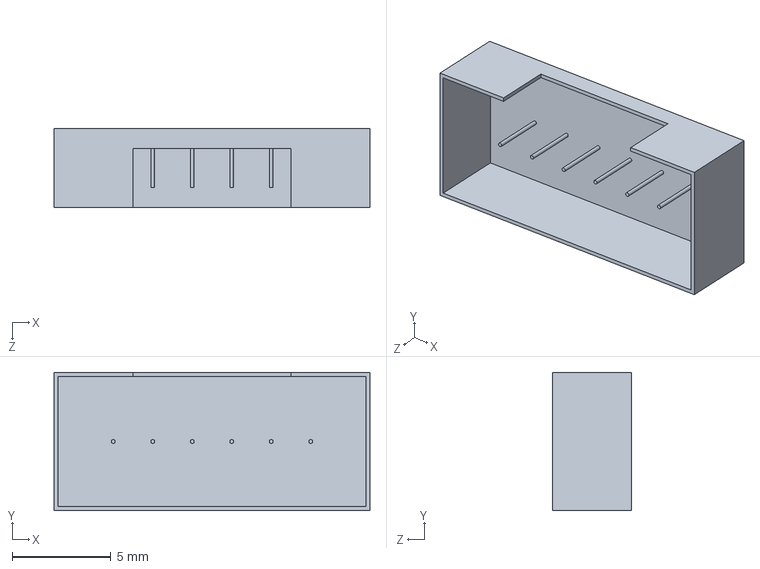
[picture p39: CAD file, 2026-10-18]
模型/智梭_42步进电机-05.SLDPRT
16.0 x 7.00 x 4.00 mm
