NONGbixi/GONGCHUANG_Intelligent_Logistics_Handling_Tower_Crane_Mechanical/模型/智梭_DIN7984_M5x16.SLDPRT

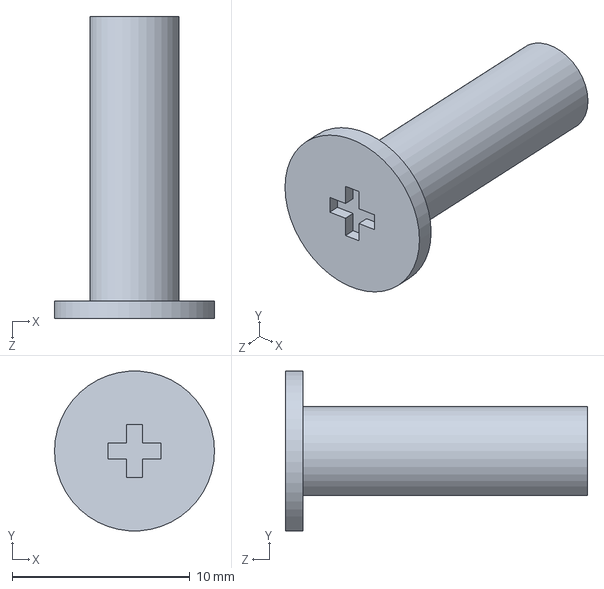
[picture p40: CAD file, 2026-10-18]
模型/智梭_DIN7984_M5x16.SLDPRT
9.00 x 8.98 x 17.0 mm
