NONGbixi/GONGCHUANG_Intelligent_Logistics_Handling_Tower_Crane_Mechanical/模型/智梭_前伸齿轮.SLDPRT

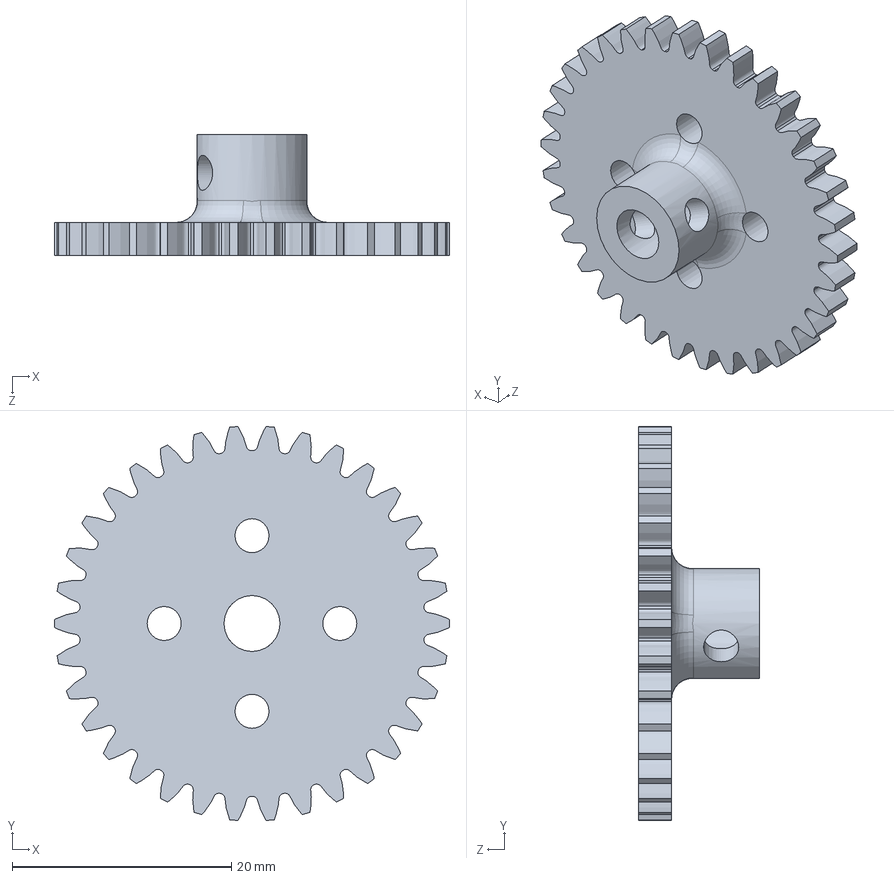
[picture p41: CAD file, 2026-10-18]
模型/智梭_前伸齿轮.SLDPRT
36.0 x 35.9 x 11.0 mm
