NONGbixi/GONGCHUANG_Intelligent_Logistics_Handling_Tower_Crane_Mechanical/模型/智梭_ISO4032_M5螺母.SLDPRT

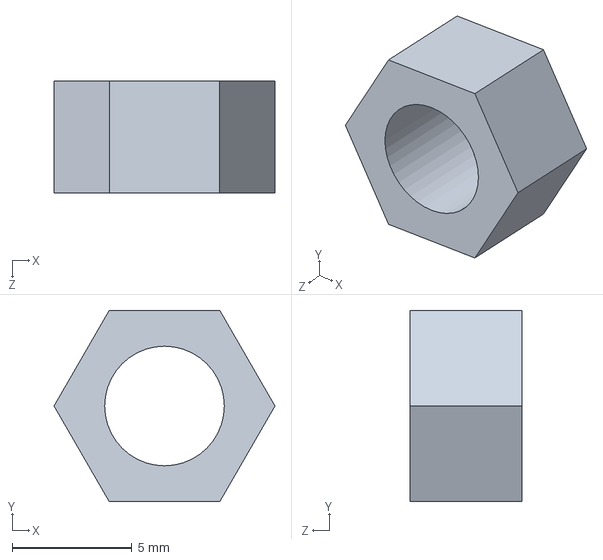
[picture p42: CAD file, 2026-10-18]
模型/智梭_ISO4032_M5螺母.SLDPRT
9.24 x 8.00 x 4.70 mm
