NONGbixi/GONGCHUANG_Intelligent_Logistics_Handling_Tower_Crane_Mechanical/模型/智梭_ISO4762_M2x12.SLDPRT

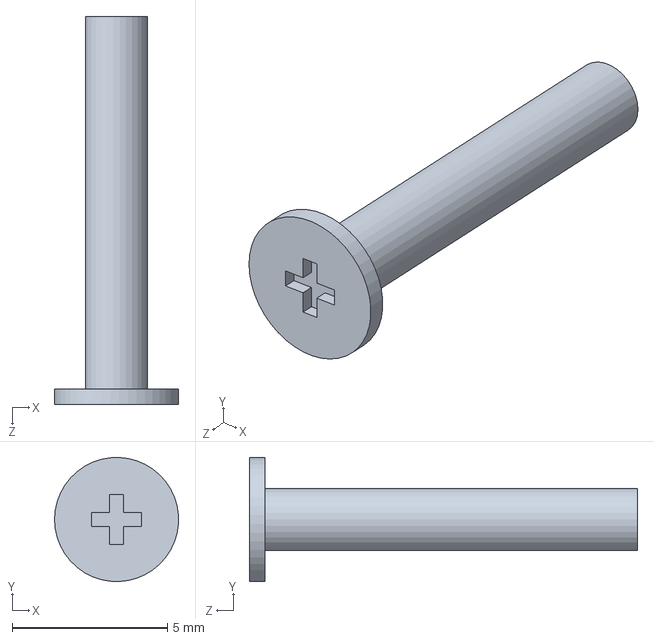
[picture p43: CAD file, 2026-10-18]
模型/智梭_ISO4762_M2x12.SLDPRT
3.99 x 4.00 x 12.5 mm
