NONGbixi/GONGCHUANG_Intelligent_Logistics_Handling_Tower_Crane_Mechanical/模型/智梭_转盘物料盘1.SLDPRT

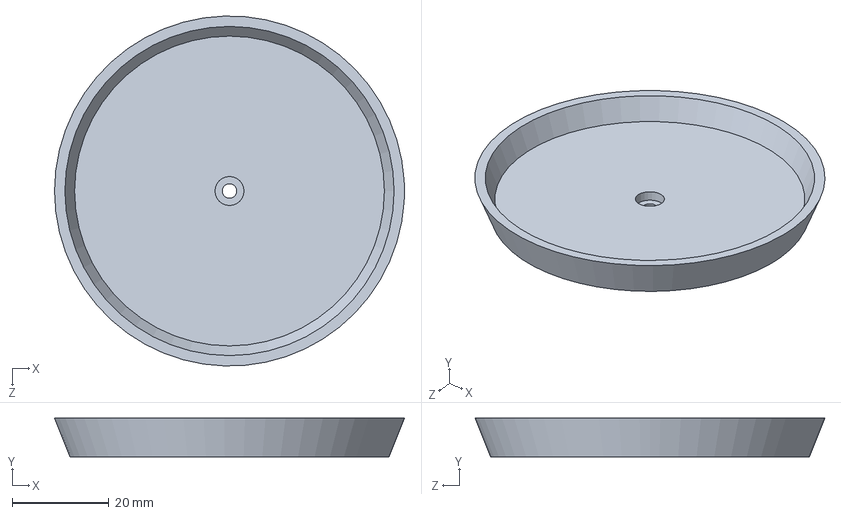
[picture p44: CAD file, 2026-10-18]
模型/智梭_转盘物料盘1.SLDPRT
72.3 x 8.00 x 72.3 mm
