NONGbixi/GONGCHUANG_Intelligent_Logistics_Handling_Tower_Crane_Mechanical/模型/智梭_升降台从动爪齿轮.SLDPRT

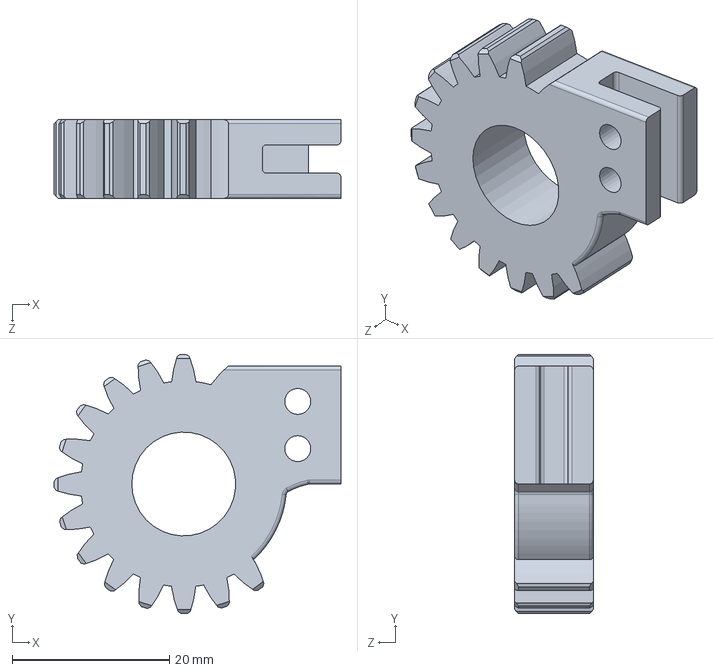
[picture p45: CAD file, 2026-10-18]
模型/智梭_升降台从动爪齿轮.SLDPRT
36.5 x 33.0 x 10.0 mm
