NONGbixi/GONGCHUANG_Intelligent_Logistics_Handling_Tower_Crane_Mechanical/模型/智梭_DIN7984_M3x25.SLDPRT

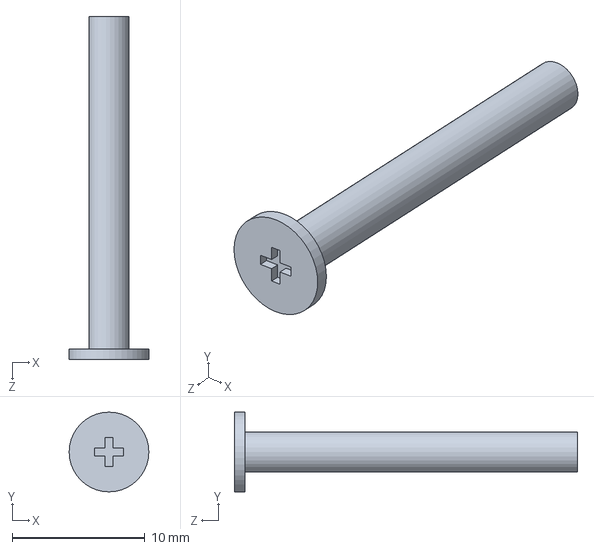
[picture p47: CAD file, 2026-10-18]
模型/智梭_DIN7984_M3x25.SLDPRT
6.00 x 6.00 x 25.8 mm
