NONGbixi/GONGCHUANG_Intelligent_Logistics_Handling_Tower_Crane_Mechanical/模型/智梭_升降台惰轮座.SLDPRT

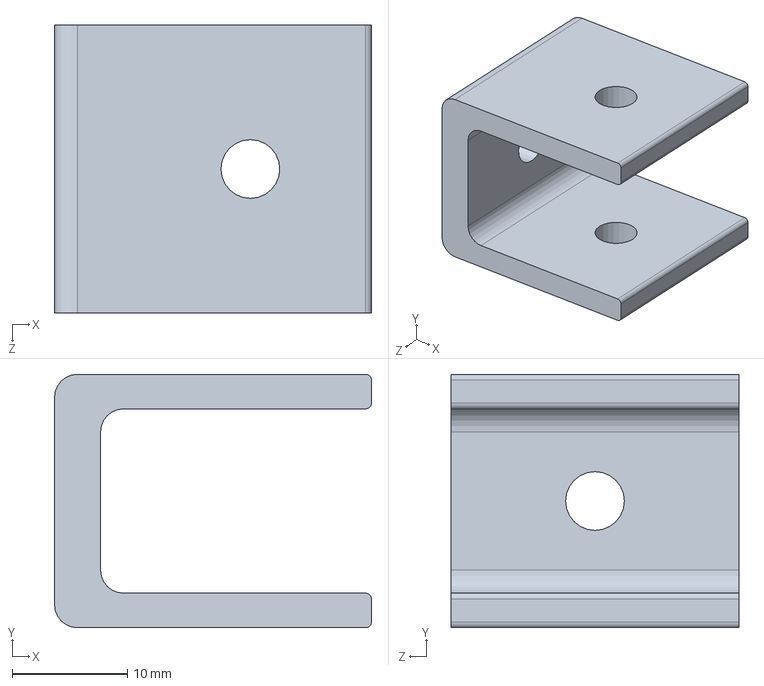
[picture p48: CAD file, 2026-10-18]
模型/智梭_升降台惰轮座.SLDPRT
27.5 x 22.0 x 25.0 mm
