NONGbixi/GONGCHUANG_Intelligent_Logistics_Handling_Tower_Crane_Mechanical/模型/智梭_升降台皮带固定片2.SLDPRT

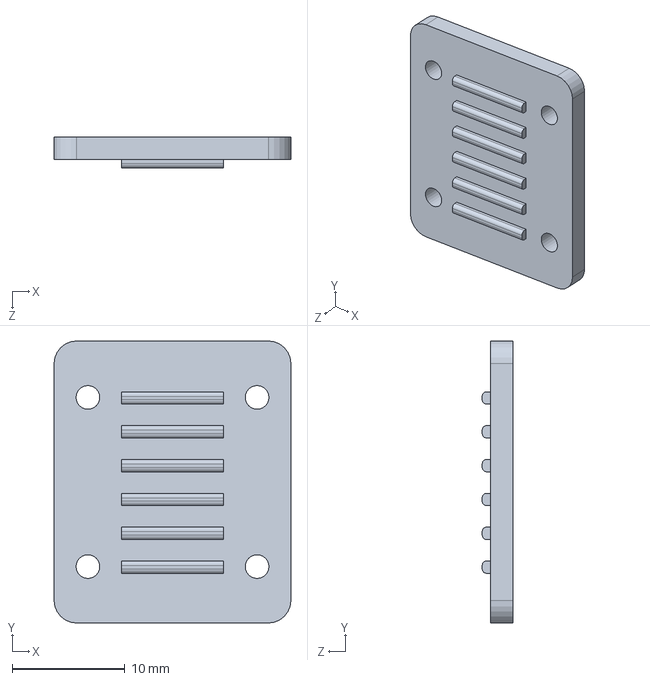
[picture p49: CAD file, 2026-10-18]
模型/智梭_升降台皮带固定片2.SLDPRT
21.0 x 25.0 x 2.72 mm
