NONGbixi/GONGCHUANG_Intelligent_Logistics_Handling_Tower_Crane_Mechanical/模型/智梭_10mm铜柱.SLDPRT

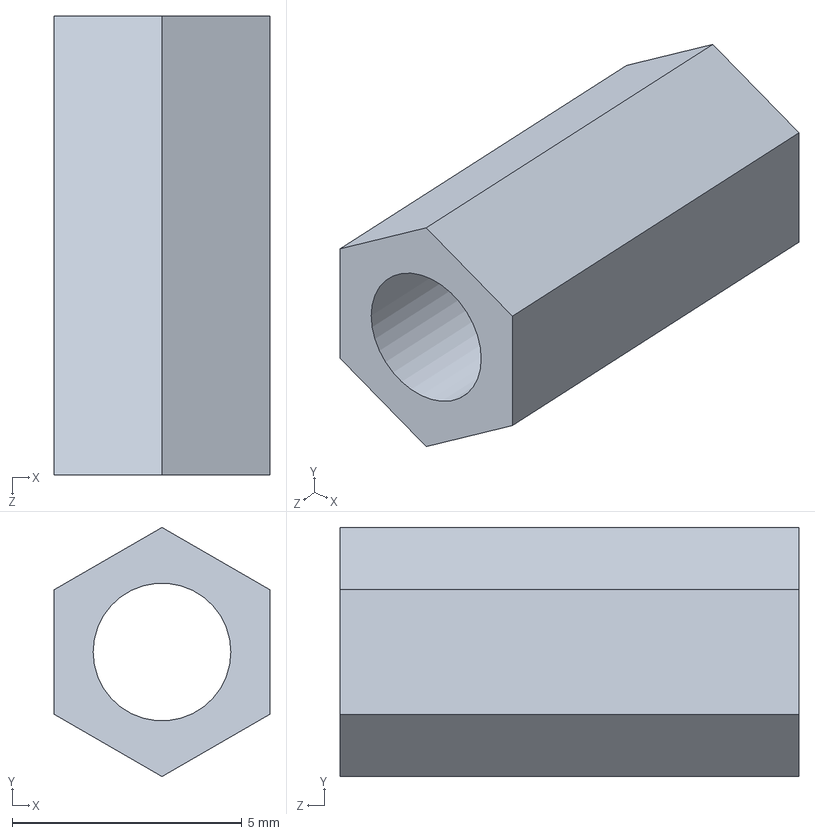
[picture p50: CAD file, 2026-10-18]
模型/智梭_10mm铜柱.SLDPRT
4.70 x 5.43 x 10.0 mm
