NONGbixi/GONGCHUANG_Intelligent_Logistics_Handling_Tower_Crane_Mechanical/模型/智梭_升降台带轮.SLDPRT

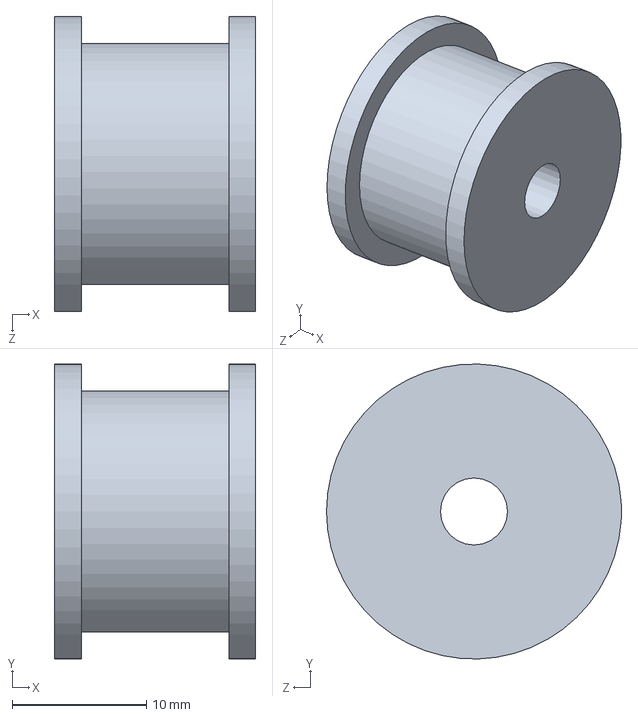
[picture p51: CAD file, 2026-10-18]
模型/智梭_升降台带轮.SLDPRT
15.0 x 22.0 x 22.0 mm
