NONGbixi/GONGCHUANG_Intelligent_Logistics_Handling_Tower_Crane_Mechanical/模型/智梭_铝管.SLDPRT

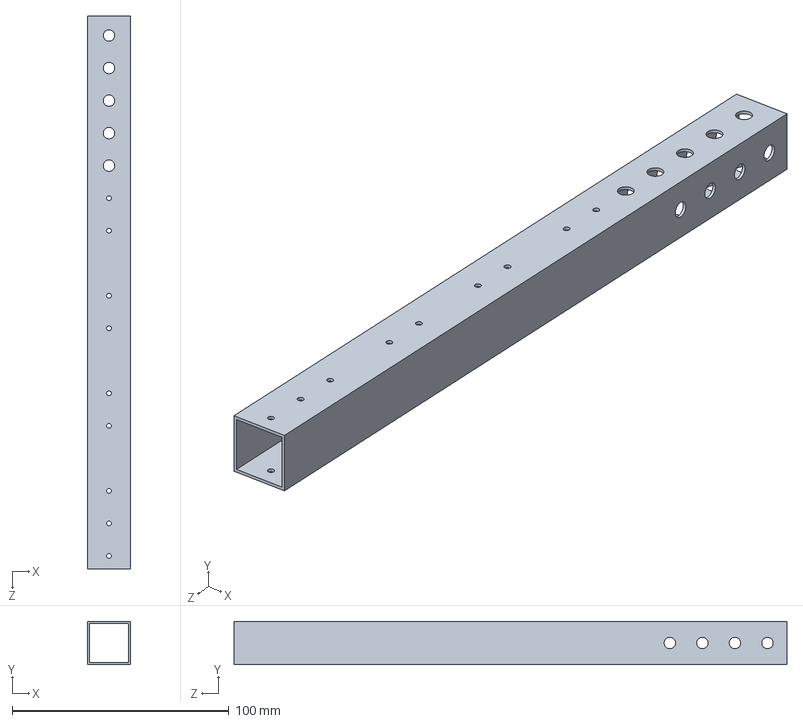
[picture p52: CAD file, 2026-10-18]
模型/智梭_铝管.SLDPRT
20.0 x 20.0 x 255.0 mm
