NONGbixi/GONGCHUANG_Intelligent_Logistics_Handling_Tower_Crane_Mechanical/模型/智梭_ISO4762_M2x40.SLDPRT

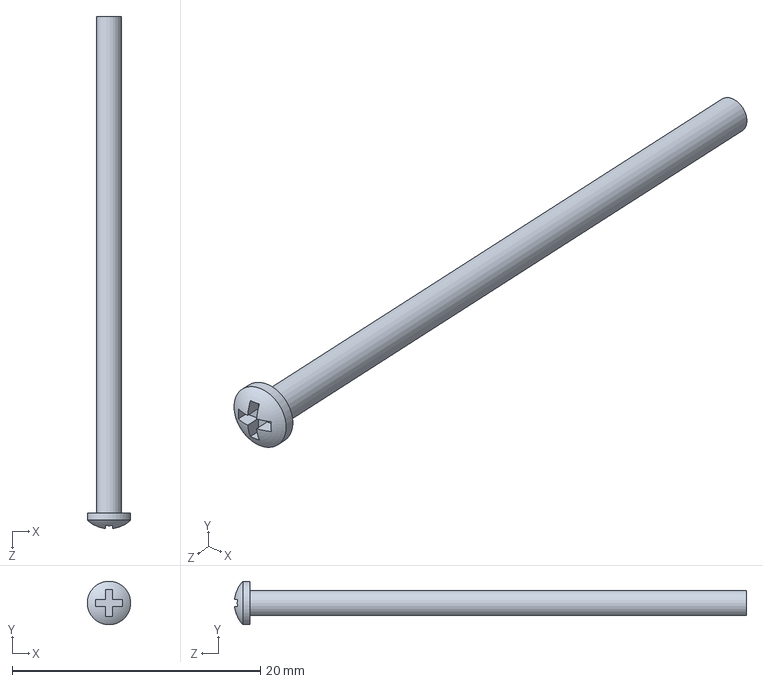
[picture p54: CAD file, 2026-10-18]
模型/智梭_ISO4762_M2x40.SLDPRT
3.50 x 3.50 x 41.3 mm
