NONGbixi/GONGCHUANG_Intelligent_Logistics_Handling_Tower_Crane_Mechanical/模型/智梭_轴承.SLDPRT

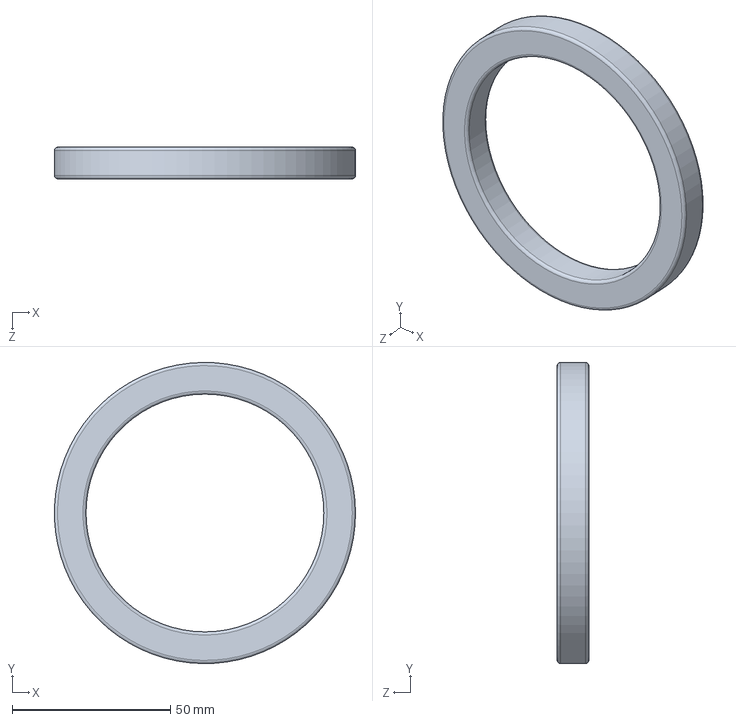
[picture p55: CAD file, 2026-10-18]
模型/智梭_轴承.SLDPRT
95.0 x 95.0 x 10.0 mm
