NONGbixi/GONGCHUANG_Intelligent_Logistics_Handling_Tower_Crane_Mechanical/模型/智梭_ISO4032_M3螺母.SLDPRT

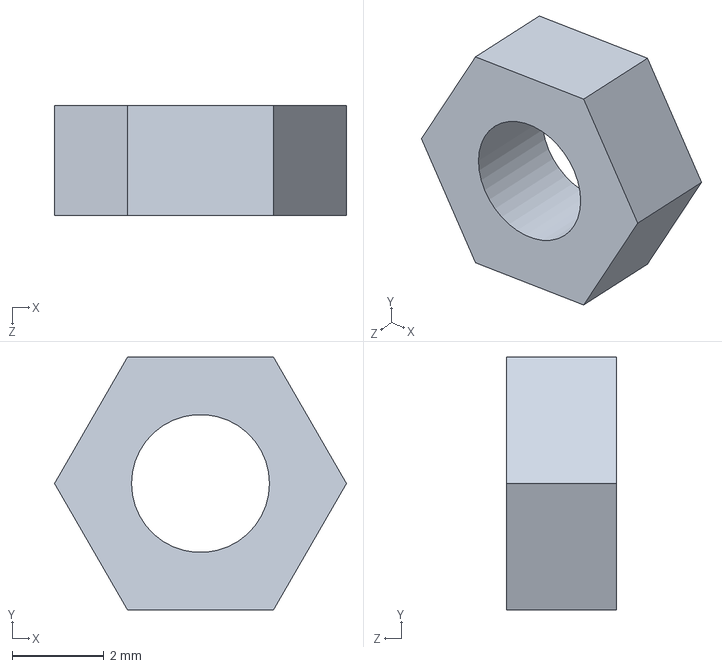
[picture p56: CAD file, 2026-10-18]
模型/智梭_ISO4032_M3螺母.SLDPRT
6.35 x 5.50 x 2.40 mm
