NONGbixi/GONGCHUANG_Intelligent_Logistics_Handling_Tower_Crane_Mechanical/模型/智梭_麦轮.SLDPRT

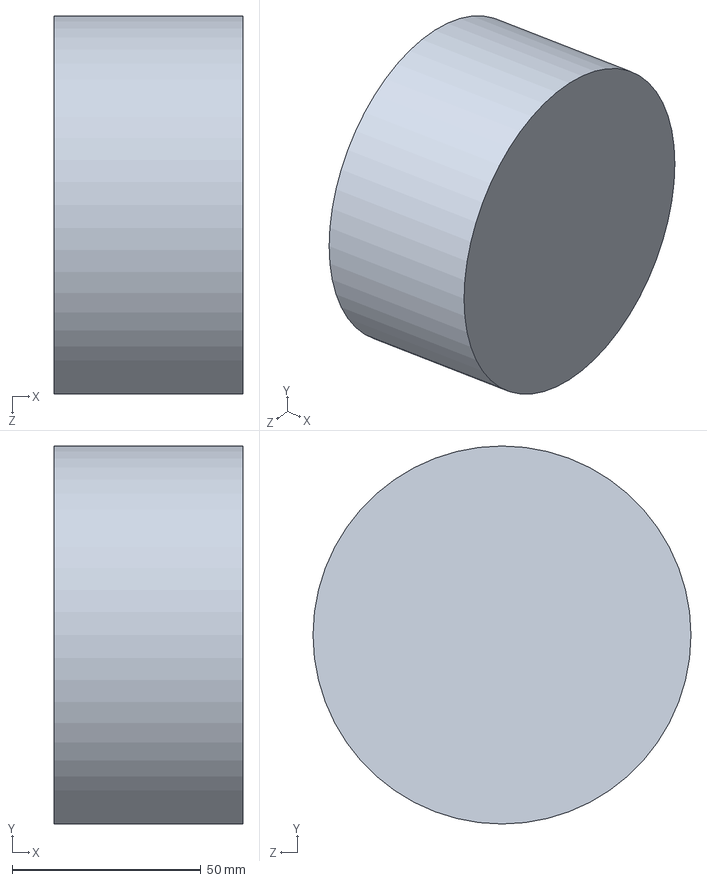
[picture p57: CAD file, 2026-10-18]
模型/智梭_麦轮.SLDPRT
50.0 x 100.0 x 100.0 mm
