NONGbixi/GONGCHUANG_Intelligent_Logistics_Handling_Tower_Crane_Mechanical/模型/智梭_升降台主动爪齿轮.SLDPRT

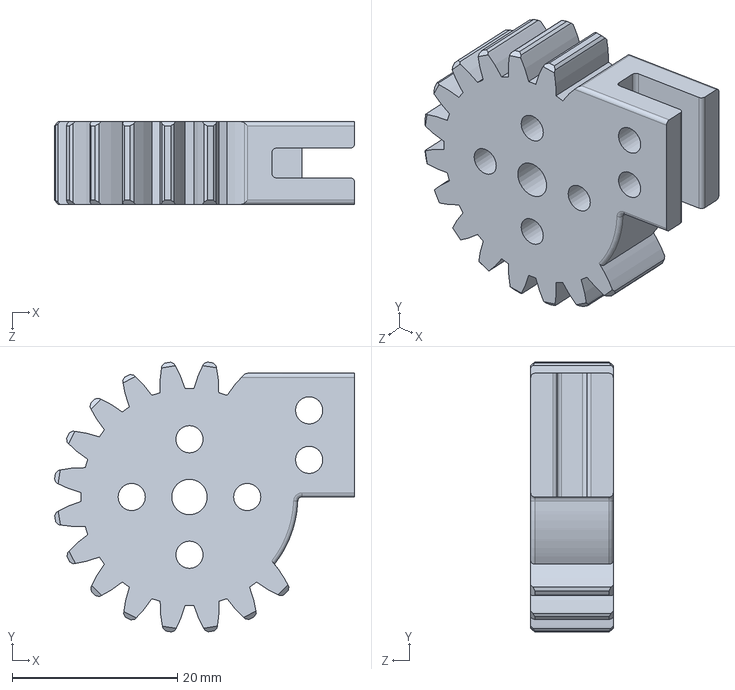
[picture p58: CAD file, 2026-10-18]
模型/智梭_升降台主动爪齿轮.SLDPRT
36.4 x 32.7 x 10.0 mm
