NONGbixi/GONGCHUANG_Intelligent_Logistics_Handling_Tower_Crane_Mechanical/模型/智梭_升降台250mm导轨.SLDPRT

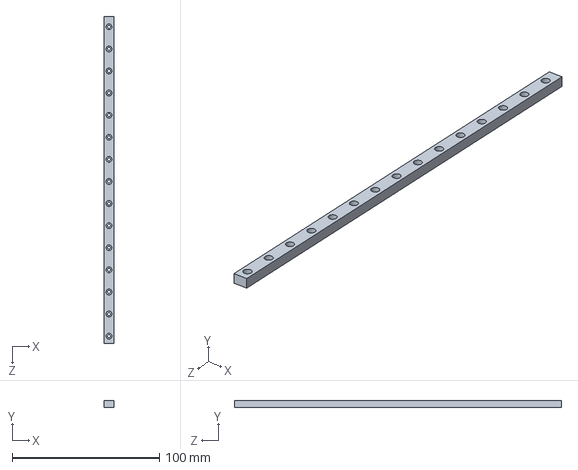
[picture p59: CAD file, 2026-10-18]
模型/智梭_升降台250mm导轨.SLDPRT
7.00 x 4.80 x 222.0 mm
