NONGbixi/GONGCHUANG_Intelligent_Logistics_Handling_Tower_Crane_Mechanical/模型/智梭_28闭环步进电机.SLDPRT

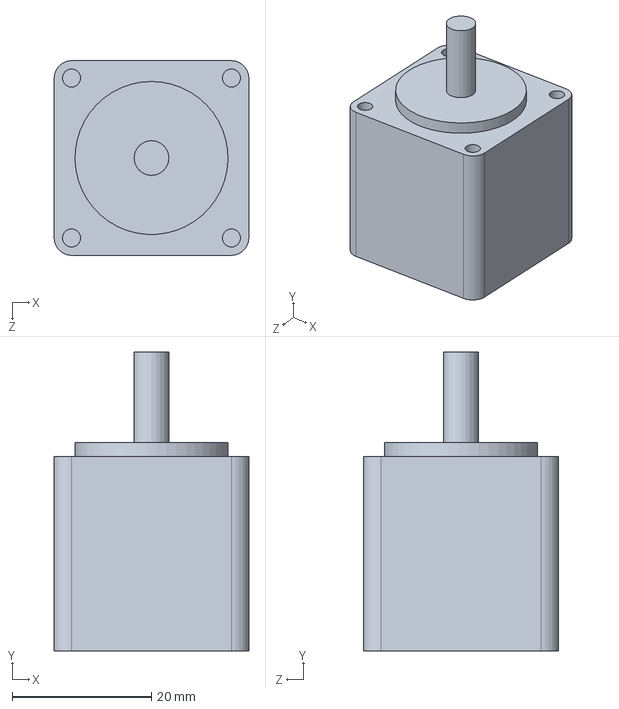
[picture p60: CAD file, 2026-10-18]
模型/智梭_28闭环步进电机.SLDPRT
28.0 x 43.0 x 28.0 mm
