NONGbixi/GONGCHUANG_Intelligent_Logistics_Handling_Tower_Crane_Mechanical/模型/智梭_舵机（大）.SLDPRT

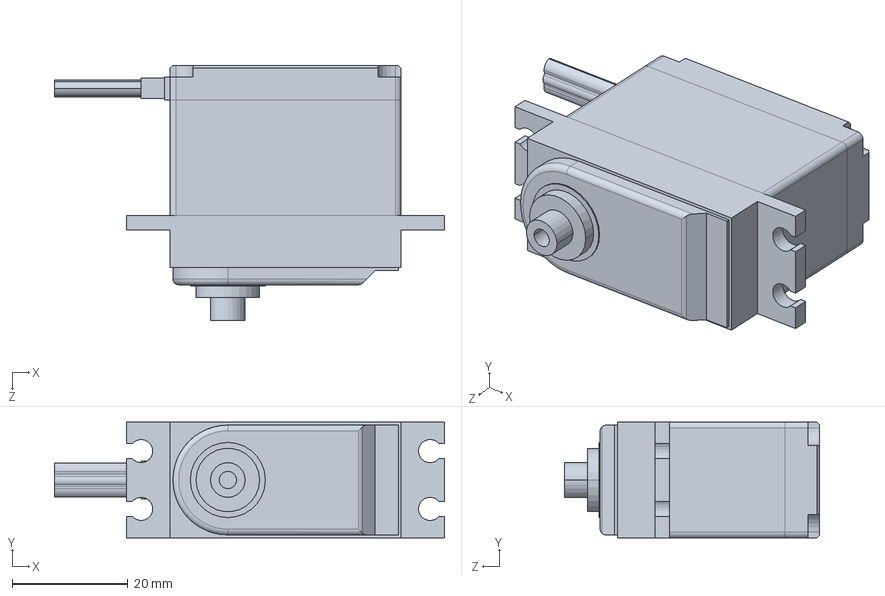
[picture p61: CAD file, 2026-10-18]
模型/智梭_舵机（大）.SLDPRT
67.5 x 20.0 x 44.2 mm
