NONGbixi/GONGCHUANG_Intelligent_Logistics_Handling_Tower_Crane_Mechanical/模型/智梭_ISO4762_M2x25.SLDPRT

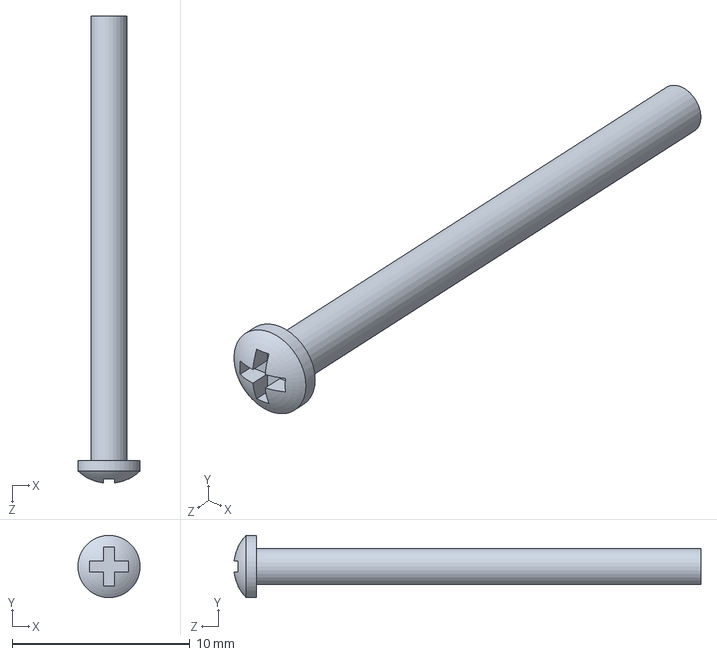
[picture p62: CAD file, 2026-10-18]
模型/智梭_ISO4762_M2x25.SLDPRT
3.50 x 3.50 x 26.3 mm
