NONGbixi/GONGCHUANG_Intelligent_Logistics_Handling_Tower_Crane_Mechanical/模型/智梭_DIN7984_M3x6.SLDPRT

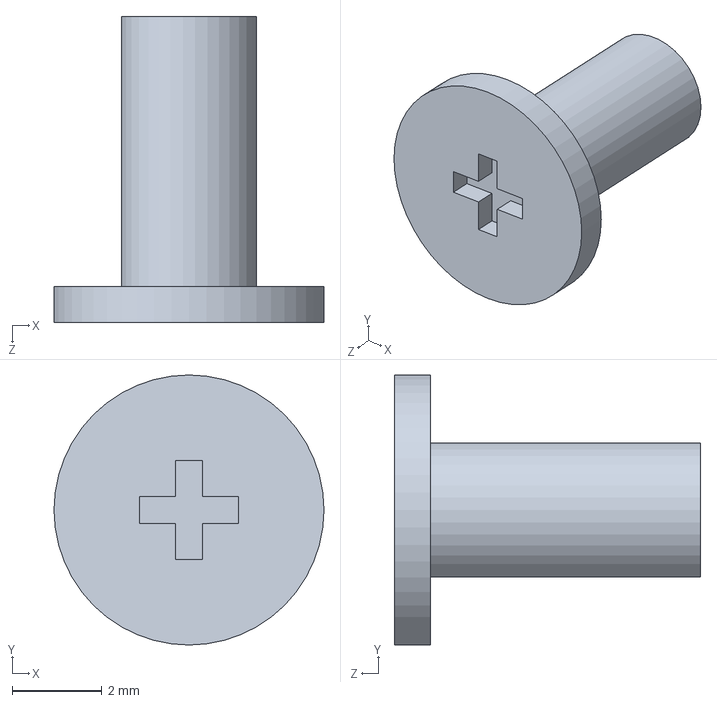
[picture p65: CAD file, 2026-10-18]
模型/智梭_DIN7984_M3x6.SLDPRT
6.00 x 6.00 x 6.80 mm
