NONGbixi/GONGCHUANG_Intelligent_Logistics_Handling_Tower_Crane_Mechanical/模型/智梭_DIN7984_M3x16.SLDPRT

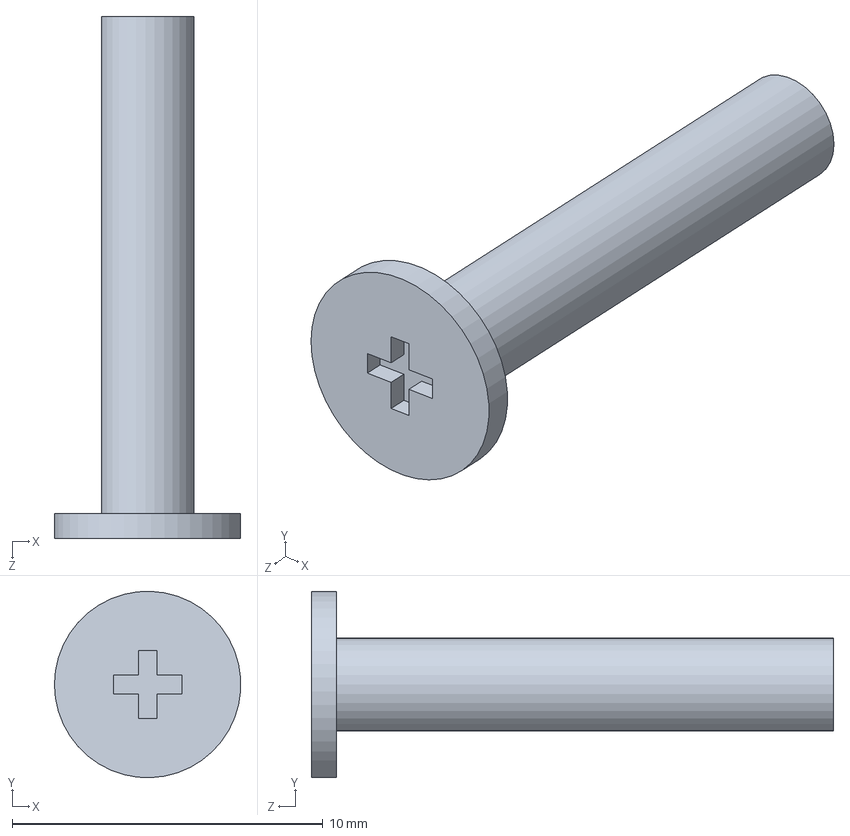
[picture p66: CAD file, 2026-10-18]
模型/智梭_DIN7984_M3x16.SLDPRT
5.99 x 6.00 x 16.8 mm
