NONGbixi/GONGCHUANG_Intelligent_Logistics_Handling_Tower_Crane_Mechanical/模型/智梭_DIN7984_M3x8.SLDPRT

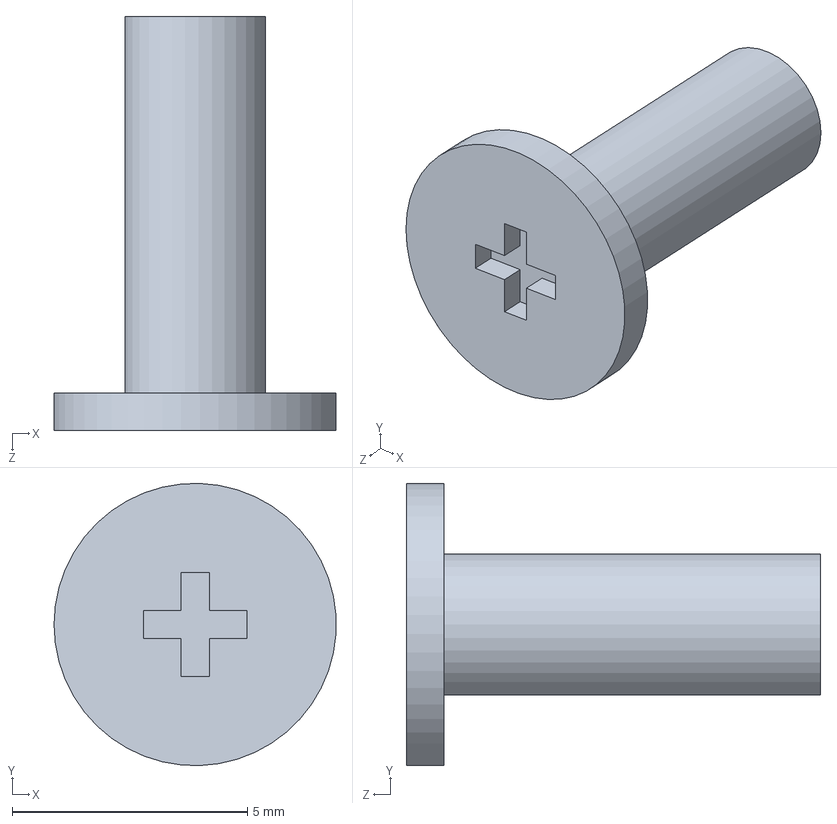
[picture p67: CAD file, 2026-10-18]
模型/智梭_DIN7984_M3x8.SLDPRT
5.99 x 6.00 x 8.80 mm
