NONGbixi/GONGCHUANG_Intelligent_Logistics_Handling_Tower_Crane_Mechanical/模型/智梭_DIN7984_M3x5.SLDPRT

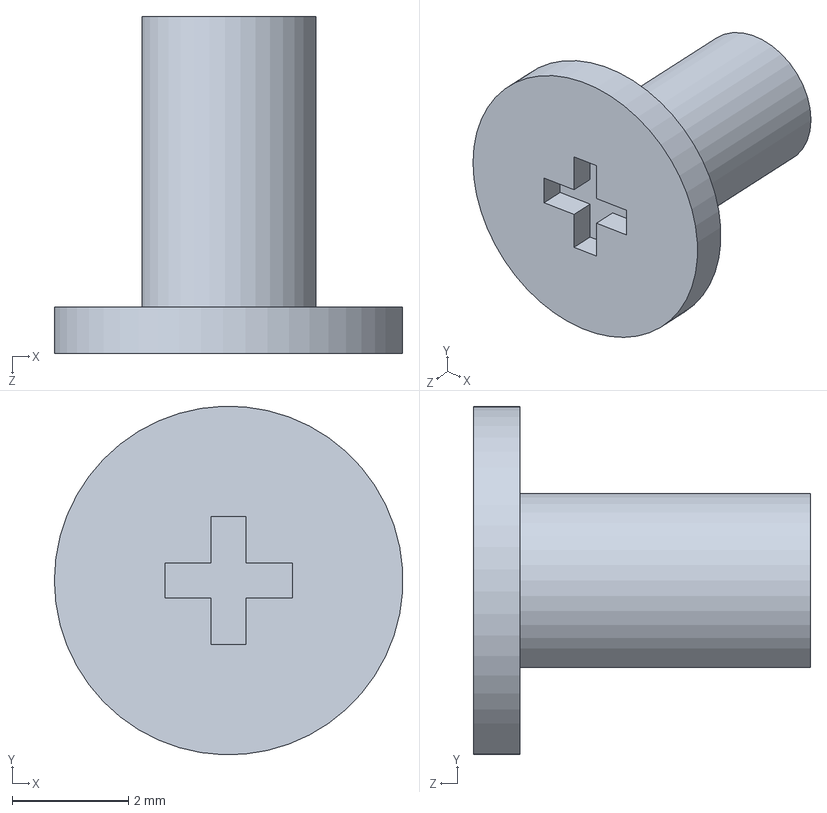
[picture p68: CAD file, 2026-10-18]
模型/智梭_DIN7984_M3x5.SLDPRT
5.99 x 6.00 x 5.80 mm
