NONGbixi/GONGCHUANG_Intelligent_Logistics_Handling_Tower_Crane_Mechanical/模型/智梭_ISO4032_M4螺母.SLDPRT

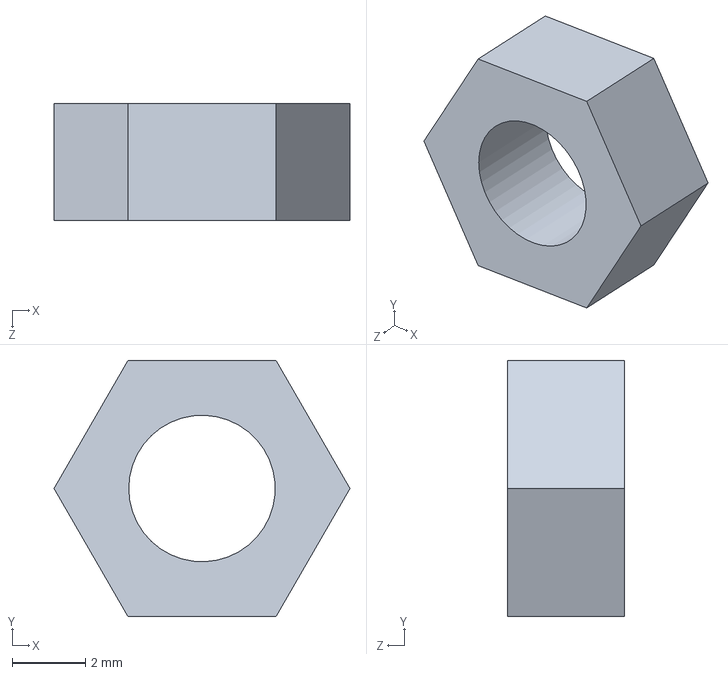
[picture p69: CAD file, 2026-10-18]
模型/智梭_ISO4032_M4螺母.SLDPRT
8.08 x 7.00 x 3.20 mm
