NONGbixi/GONGCHUANG_Intelligent_Logistics_Handling_Tower_Crane_Mechanical/模型/智梭_DIN7984_M5x12.SLDPRT

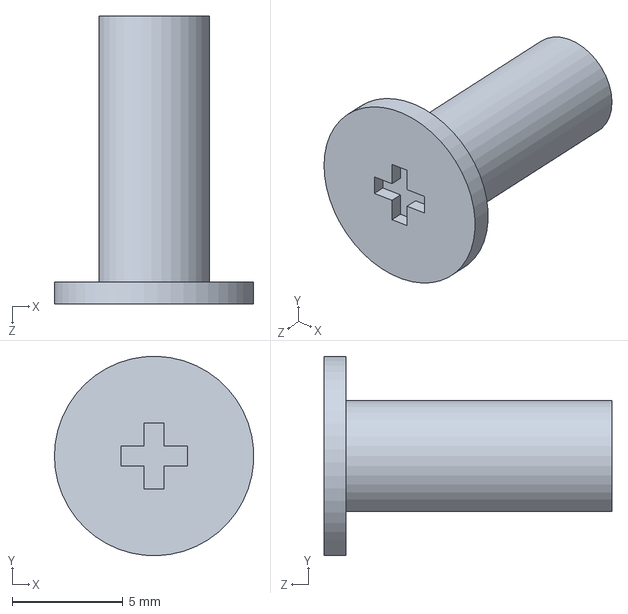
[picture p70: CAD file, 2026-10-18]
模型/智梭_DIN7984_M5x12.SLDPRT
8.99 x 8.99 x 13.0 mm
