NONGbixi/GONGCHUANG_Intelligent_Logistics_Handling_Tower_Crane_Mechanical/模型/智梭_前伸限位块.SLDPRT

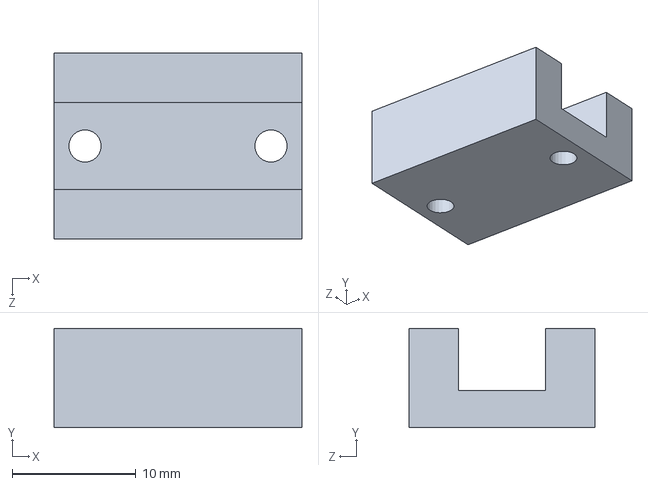
[picture p71: CAD file, 2026-10-18]
模型/智梭_前伸限位块.SLDPRT
20.0 x 8.00 x 15.0 mm
