NONGbixi/GONGCHUANG_Intelligent_Logistics_Handling_Tower_Crane_Mechanical/模型/智梭_升降台滑块.SLDPRT

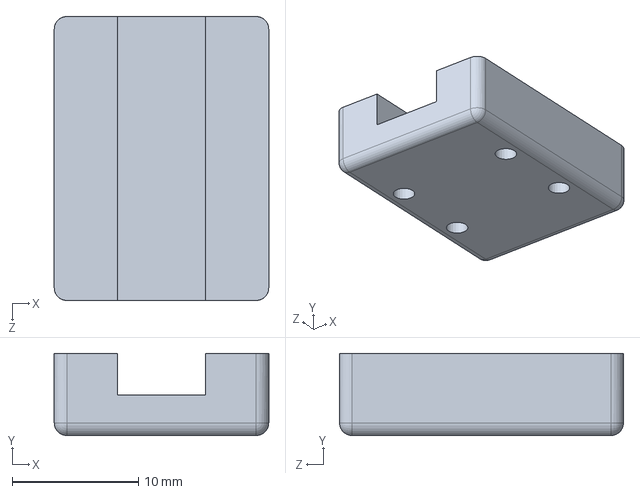
[picture p72: CAD file, 2026-10-18]
模型/智梭_升降台滑块.SLDPRT
17.0 x 6.50 x 22.5 mm
