NONGbixi/GONGCHUANG_Intelligent_Logistics_Handling_Tower_Crane_Mechanical/模型/智梭_42步进电机-01.SLDPRT

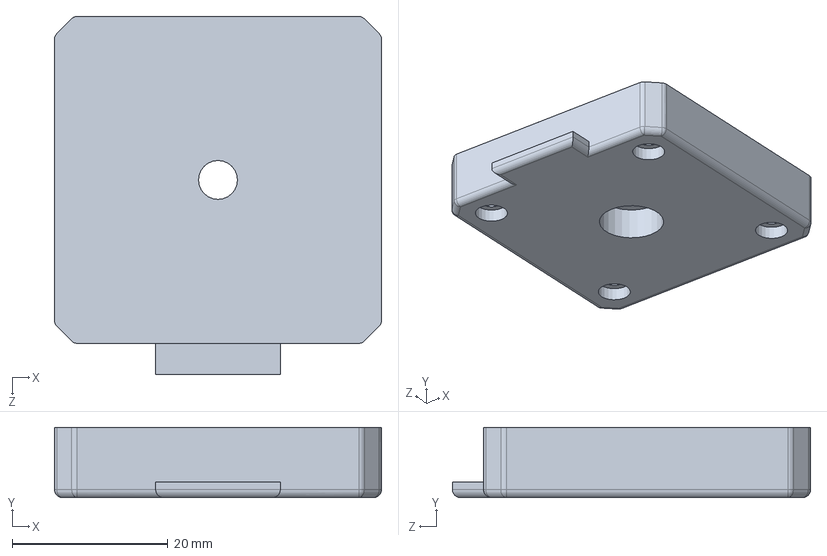
[picture p73: CAD file, 2026-10-18]
模型/智梭_42步进电机-01.SLDPRT
42.0 x 9.00 x 46.0 mm
