NONGbixi/GONGCHUANG_Intelligent_Logistics_Handling_Tower_Crane_Mechanical/模型/智梭_DIN7984_M5x20.SLDPRT

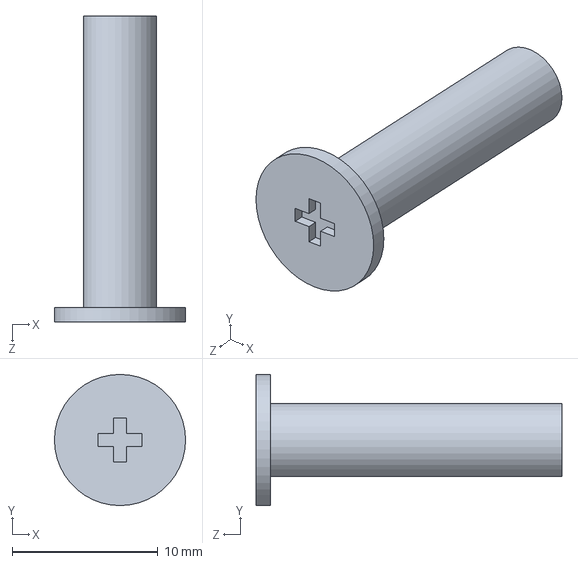
[picture p74: CAD file, 2026-10-18]
模型/智梭_DIN7984_M5x20.SLDPRT
9.00 x 9.00 x 21.0 mm
