NONGbixi/GONGCHUANG_Intelligent_Logistics_Handling_Tower_Crane_Mechanical/模型/智梭_升降台皮带.SLDPRT

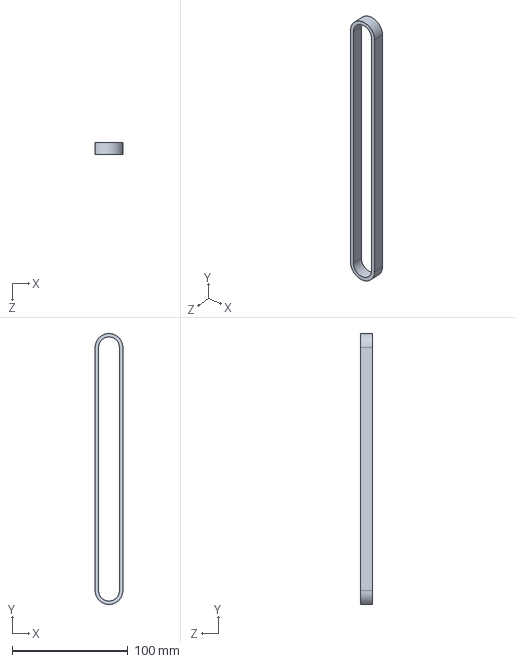
[picture p77: CAD file, 2026-10-18]
模型/智梭_升降台皮带.SLDPRT
24.0 x 234.0 x 10.0 mm
