NONGbixi/GONGCHUANG_Intelligent_Logistics_Handling_Tower_Crane_Mechanical/模型/智梭_ISO4032_M2螺母.SLDPRT

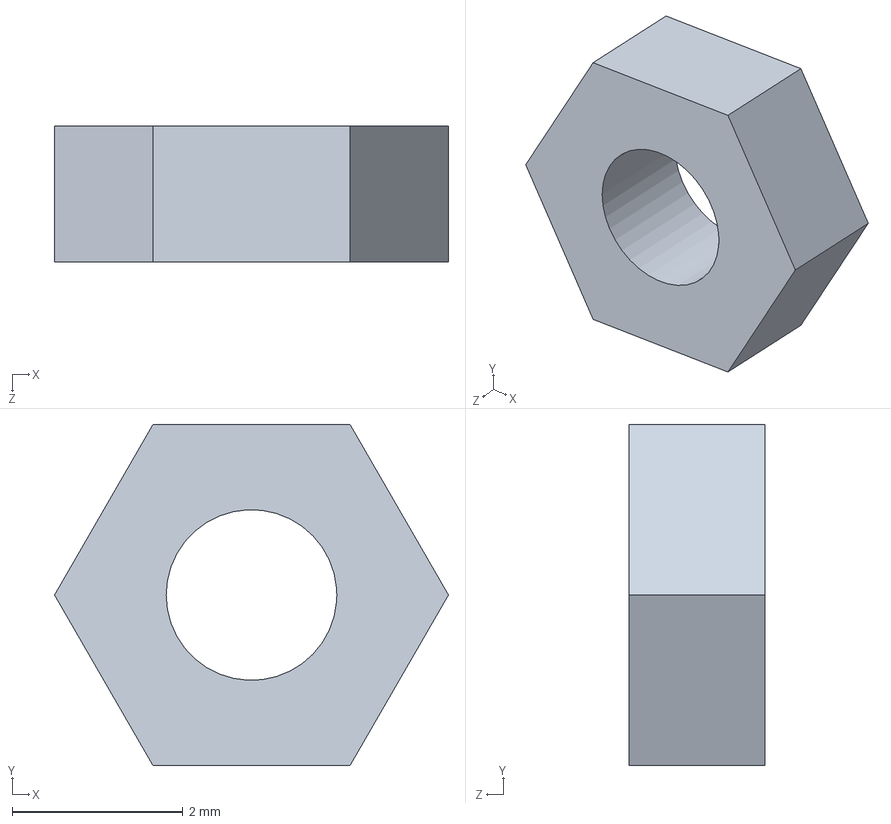
[picture p78: CAD file, 2026-10-18]
模型/智梭_ISO4032_M2螺母.SLDPRT
4.62 x 4.00 x 1.60 mm
