NONGbixi/GONGCHUANG_Intelligent_Logistics_Handling_Tower_Crane_Mechanical/模型/智梭_滑轨顶部片.SLDPRT

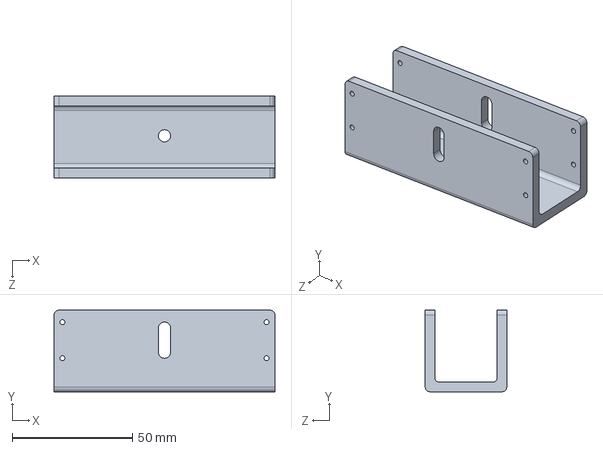
[picture p79: CAD file, 2026-10-18]
模型/智梭_滑轨顶部片.SLDPRT
92.0 x 34.0 x 34.0 mm
