NONGbixi/GONGCHUANG_Intelligent_Logistics_Handling_Tower_Crane_Mechanical/模型/智梭_金属舵盘.SLDPRT

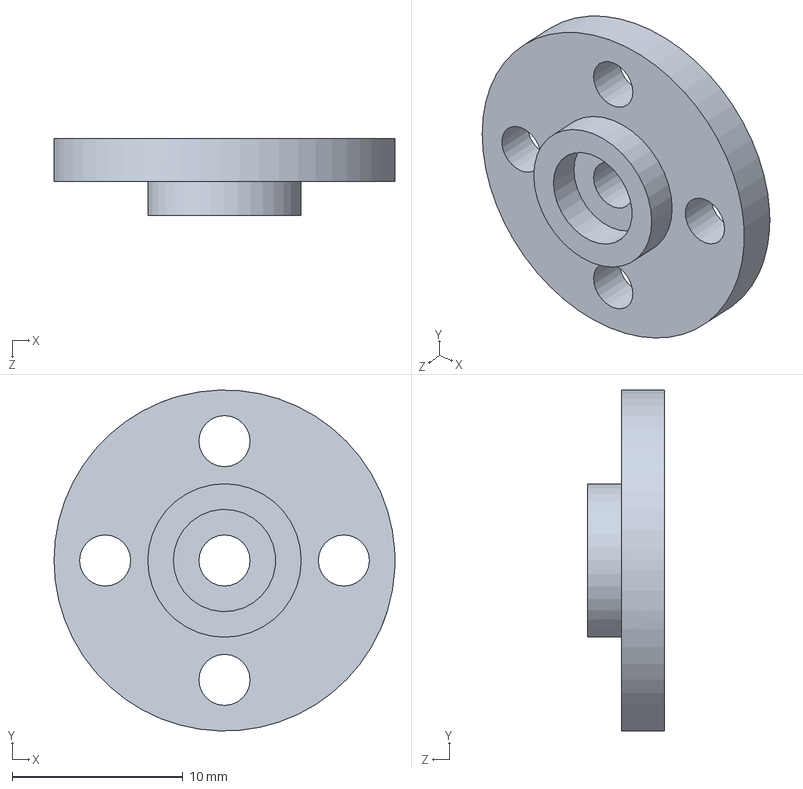
[picture p80: CAD file, 2026-10-18]
模型/智梭_金属舵盘.SLDPRT
20.0 x 20.0 x 4.50 mm
