NONGbixi/GONGCHUANG_Intelligent_Logistics_Handling_Tower_Crane_Mechanical/模型/智梭_新版42步进电机支架.SLDPRT

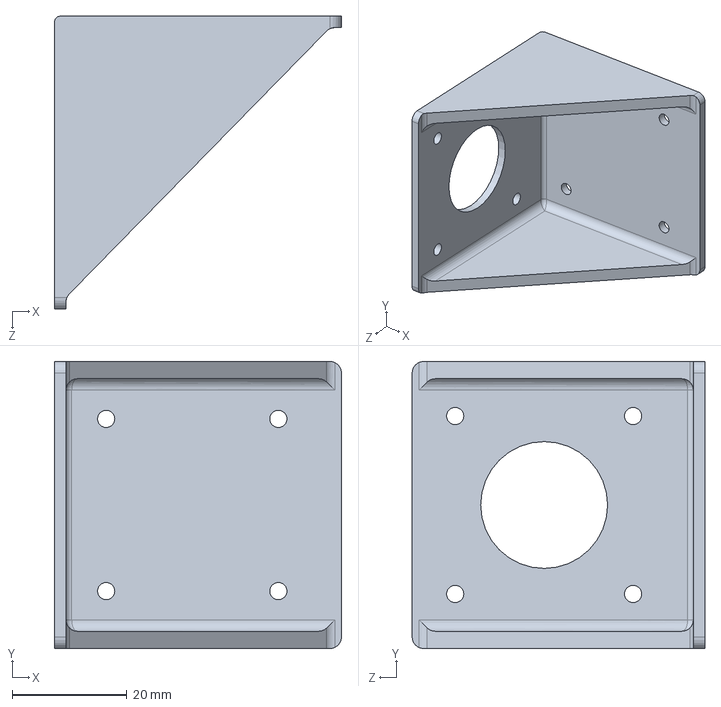
[picture p81: CAD file, 2026-10-18]
模型/智梭_新版42步进电机支架.SLDPRT
50.0 x 50.0 x 51.0 mm
