NONGbixi/GONGCHUANG_Intelligent_Logistics_Handling_Tower_Crane_Mechanical/模型/智梭_新版升降台舵机爪子夹片(厚）.SLDPRT

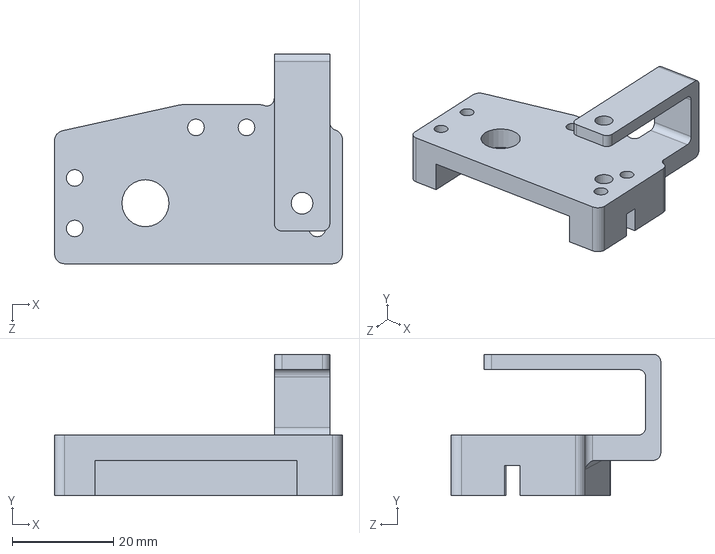
[picture p82: CAD file, 2026-10-18]
模型/智梭_新版升降台舵机爪子夹片(厚）.SLDPRT
57.0 x 28.0 x 41.5 mm
