NONGbixi/GONGCHUANG_Intelligent_Logistics_Handling_Tower_Crane_Mechanical/模型/智梭_2027升降台总_铝条支架_标准紧固件.SLDASM

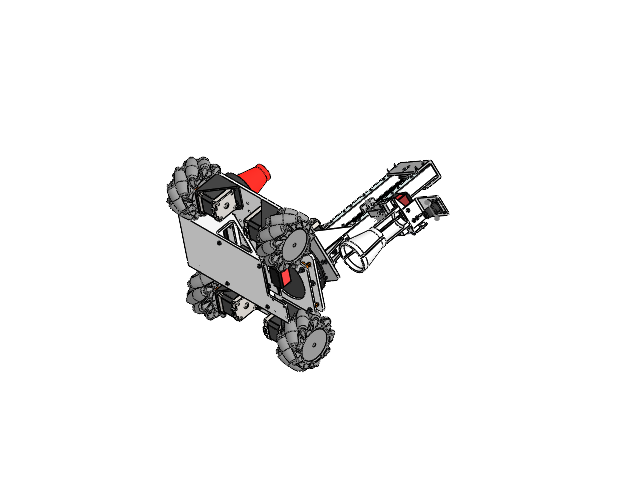
[picture p83: CAD file, 2026-10-24]
模型/智梭_2027升降台总_铝条支架_标准紧固件.SLDASM
智梭_升降台带轮 x 2
智梭_升降台250mm导轨 x 3
智梭_升降台皮带
智梭_升降台惰轮座
智梭_滑轨顶部片
智梭_升降台滑块 x 5
智梭_铝管 x 2
智梭_导轨L形架v2 x 2
智梭_新版42步进电机支架 x 5
智梭_42步进电机-01 x 5
智梭_42步进电机-02 x 5
智梭_42步进电机-03 x 5
智梭_42步进电机-04 x 5
智梭_42步进电机-05 x 5
智梭_前伸水平轴连接板
智梭_28闭环步进电机
智梭_前伸限位块
智梭_前伸齿轮
智梭_前伸齿条
智梭_新版升降台舵机爪子夹片(厚）
智梭_升降台从动爪齿轮
智梭_升降台金属舵盘
智梭_升降台轴承
零件2^智梭_2027升降台总_铝条支架_标准紧固件
智梭_升降台主动爪齿轮
智梭_导轨L形架v3 x 2
智梭_导轨L形架v4 x 2
智梭_初赛夹爪
智梭_镜向初赛夹爪
智梭_舵机座L形架
智梭_舵机（大） x 3
智梭_升降台皮带固定片1
智梭_升降台皮带固定片2
智梭_轴承
智梭_轴承夹片（大） x 2
智梭_轴承夹片（小上）
智梭_轴承夹片（小下）
智梭_舵机夹片
智梭_金属舵盘 x 2
智梭_10mm铜柱 x 4
智梭_底板_增加11mm_2027独立版
智梭_升降台升降底座
智梭_云台托架
智梭_DIN7984_M5x30 x 9
智梭_ISO4032_M5螺母 x 26
智梭_ISO4762_M2x40 x 4
智梭_ISO4032_M2螺母 x 37
智梭_ISO4762_M2x25 x 12
智梭_ISO4762_M2x6 x 6
智梭_DIN7984_M5x12 x 14
智梭_ISO4762_M2x4 x 24
智梭_DIN7984_M3x12 x 40
智梭_ISO4032_M3螺母 x 63
智梭_DIN7984_M3x5 x 4
智梭_DIN7984_M5x16 x 2
智梭_DIN7984_M3x8 x 11
智梭_DIN7984_M3x20 x 7
智梭_ISO4762_M2x8 x 13
智梭_DIN7984_M3x16 x 6
智梭_ISO4762_M2x12 x 2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
