NONGbixi/GONGCHUANG_Intelligent_Logistics_Handling_Tower_Crane_Mechanical/模型/智梭_1云台装配.SLDASM

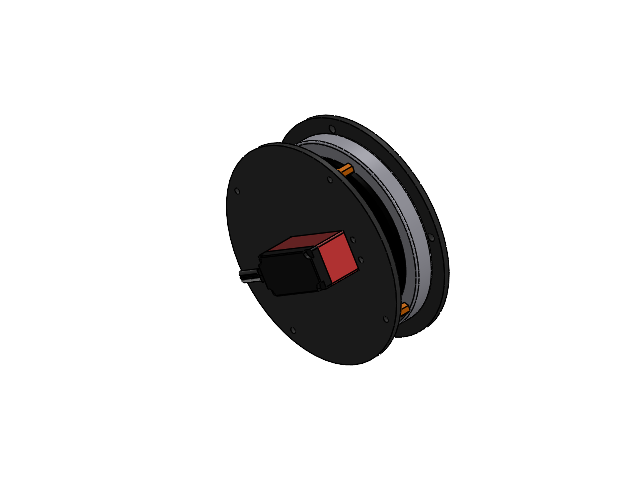
[picture p84: CAD file, 2026-10-24]
模型/智梭_1云台装配.SLDASM
智梭_轴承
智梭_轴承夹片（大）
智梭_轴承夹片（小上）
智梭_轴承夹片（小下）
智梭_舵机夹片
智梭_金属舵盘
智梭_舵机（大）
智梭_10mm铜柱 x 4
