NONGbixi/GONGCHUANG_Intelligent_Logistics_Handling_Tower_Crane_Mechanical/模型/智梭_电池电控模块.SLDASM

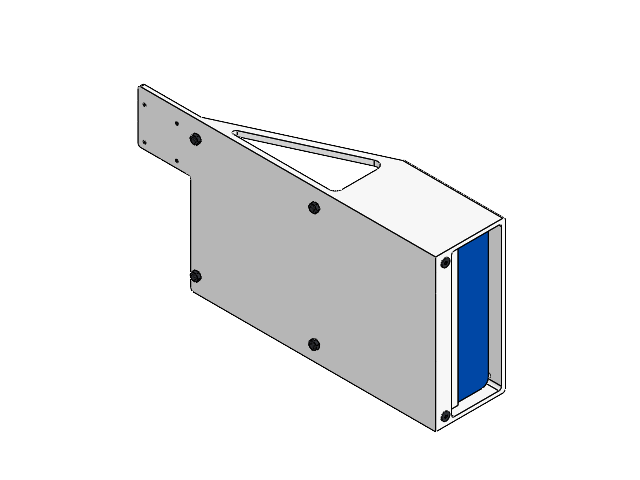
[picture p85: CAD file, 2026-10-24]
模型/智梭_电池电控模块.SLDASM
智梭_电池仓1
智梭_调车用电池示意_70x70x80
智梭_DIN7984_M3x6 x 2
智梭_电池仓2
智梭_电路板示意_100x100_孔距90
智梭_DIN7984_M3x8 x 4
智梭_ISO4032_M3螺母 x 4
智梭_JY62陀螺仪
智梭_ISO4762_M2x4 x 4
