NONGbixi/GONGCHUANG_Intelligent_Logistics_Handling_Tower_Crane_Mechanical/模型/智梭_转台.SLDASM

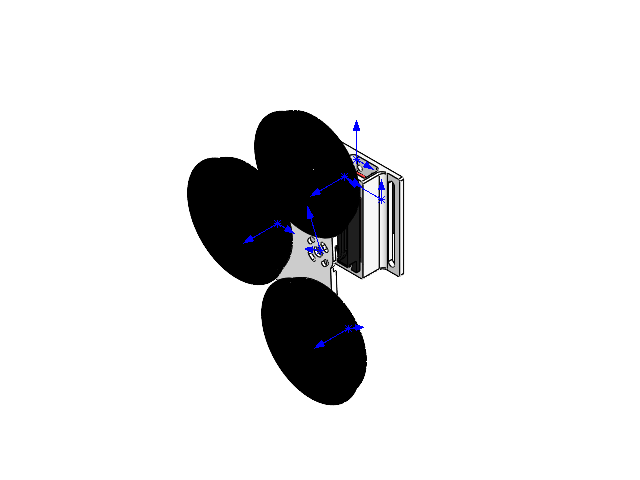
[picture p86: CAD file, 2026-10-24]
模型/智梭_转台.SLDASM
智梭_转盘舵机座
智梭_舵机（大）
智梭_金属舵盘
智梭_转盘
智梭_转盘物料盘1 x 3
