NONGbixi/GONGCHUANG_Intelligent_Logistics_Handling_Tower_Crane_Mechanical/(list of files, cad)

Other CAD files:
模型/智梭_麦轮（反）.SLDPRT
模型/智梭_轴承夹片（小下）.SLDPRT
模型/智梭_初赛物料.SLDPRT
模型/智梭_镜向初赛夹爪.SLDPRT
模型/智梭_初赛物料2.SLDPRT
模型/智梭_导轨L形架v2.SLDPRT
模型/智梭_导轨L形架v3.SLDPRT
