NONGbixi/GONGCHUANG_Intelligent_Logistics_Handling_Tower_Crane_Mechanical/文档/装配完整性报告.txt

有效模型及参考文件=77
缺失有效引用=0
外部有效引用=0
嵌入式虚拟引用=1
打开错误=0
打开警告=0
活动组件=373
压缩组件=0
未加载活动组件=0
活动组件外部路径=0
顶层配合错误=0
检查范围：当前有效依赖，不含已断开的历史建模关联。
