NONGbixi/GONGCHUANG_Intelligent_Logistics_Handling_Tower_Crane_Mechanical/文档/装配引用检查.tsv

文件 | 引用 | 状态
智梭_2027升降台总_铝条支架_标准紧固件.SLDASM | D:\Robot\2027工创赛智梭速运升降台\模型\智梭_升降台带轮.SLDPRT | 本地存在
智梭_2027升降台总_铝条支架_标准紧固件.SLDASM | D:\Robot\2027工创赛智梭速运升降台\模型\智梭_升降台皮带.SLDPRT | 本地存在
智梭_2027升降台总_铝条支架_标准紧固件.SLDASM | D:\Robot\2027工创赛智梭速运升降台\模型\智梭_升降台惰轮座.SLDPRT | 本地存在
智梭_2027升降台总_铝条支架_标准紧固件.SLDASM | D:\Robot\2027工创赛智梭速运升降台\模型\智梭_升降台滑块.SLDPRT | 本地存在
智梭_2027升降台总_铝条支架_标准紧固件.SLDASM | D:\Robot\2027工创赛智梭速运升降台\模型\智梭_升降台升降底座.SLDPRT | 本地存在
智梭_2027升降台总_铝条支架_标准紧固件.SLDASM | D:\Robot\2027工创赛智梭速运升降台\模型\智梭_导轨L形架v2.SLDPRT | 本地存在
智梭_2027升降台总_铝条支架_标准紧固件.SLDASM | D:\Robot\2027工创赛智梭速运升降台\模型\智梭_新版42步进电机支架.SLDPRT | 本地存在
智梭_2027升降台总_铝条支架_标准紧固件.SLDASM | D:\Robot\2027工创赛智梭速运升降台\模型\智梭_42步进电机.SLDASM | 本地存在
智梭_2027升降台总_铝条支架_标准紧固件.SLDASM | D:\Robot\2027工创赛智梭速运升降台\模型\智梭_前伸水平轴连接板.SLDPRT | 本地存在
智梭_2027升降台总_铝条支架_标准紧固件.SLDASM | D:\Robot\2027工创赛智梭速运升降台\模型\智梭_28闭环步进电机.SLDPRT | 本地存在
智梭_2027升降台总_铝条支架_标准紧固件.SLDASM | D:\Robot\2027工创赛智梭速运升降台\模型\智梭_前伸限位块.SLDPRT | 本地存在
智梭_2027升降台总_铝条支架_标准紧固件.SLDASM | D:\Robot\2027工创赛智梭速运升降台\模型\智梭_前伸齿轮.SLDPRT | 本地存在
智梭_2027升降台总_铝条支架_标准紧固件.SLDASM | D:\Robot\2027工创赛智梭速运升降台\模型\智梭_前伸齿条.SLDPRT | 本地存在
智梭_2027升降台总_铝条支架_标准紧固件.SLDASM | D:\Robot\2027工创赛智梭速运升降台\模型\智梭_升降台金属舵盘.SLDPRT | 本地存在
智梭_2027升降台总_铝条支架_标准紧固件.SLDASM | D:\Robot\2027工创赛智梭速运升降台\模型\智梭_升降台250mm导轨.SLDPRT | 本地存在
智梭_2027升降台总_铝条支架_标准紧固件.SLDASM | D:\Robot\2027工创赛智梭速运升降台\模型\智梭_新版升降台舵机爪子夹片(厚）.SLDPRT | 本地存在
智梭_2027升降台总_铝条支架_标准紧固件.SLDASM | D:\Robot\2027工创赛智梭速运升降台\模型\智梭_升降台主动爪齿轮.SLDPRT | 本地存在
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
智梭_42步进电机.SLDASM | D:\Robot\2027工创赛智梭速运升降台\模型\智梭_42步进电机-03.SLDPRT | 本地存在
智梭_42步进电机.SLDASM | D:\Robot\2027工创赛智梭速运升降台\模型\智梭_42步进电机-04.SLDPRT | 本地存在
智梭_42步进电机.SLDASM | D:\Robot\2027工创赛智梭速运升降台\模型\智梭_42步进电机-05.SLDPRT | 本地存在
智梭_1云台装配.SLDASM | D:\Robot\2027工创赛智梭速运升降台\模型\智梭_轴承.SLDPRT | 本地存在
智梭_1云台装配.SLDASM | D:\Robot\2027工创赛智梭速运升降台\模型\智梭_轴承夹片（大）.SLDPRT | 本地存在
智梭_1云台装配.SLDASM | D:\Robot\2027工创赛智梭速运升降台\模型\智梭_轴承夹片（小上）.SLDPRT | 本地存在
智梭_1云台装配.SLDASM | D:\Robot\2027工创赛智梭速运升降台\模型\智梭_轴承夹片（小下）.SLDPRT | 本地存在
智梭_1云台装配.SLDASM | D:\Robot\2027工创赛智梭速运升降台\模型\智梭_舵机夹片.SLDPRT | 本地存在
智梭_1云台装配.SLDASM | D:\Robot\2027工创赛智梭速运升降台\模型\智梭_金属舵盘.SLDPRT | 本地存在
智梭_1云台装配.SLDASM | D:\Robot\2027工创赛智梭速运升降台\模型\智梭_舵机（大）.SLDPRT | 本地存在
智梭_1云台装配.SLDASM | D:\Robot\2027工创赛智梭速运升降台\模型\智梭_10mm铜柱.SLDPRT | 本地存在
智梭_转台.SLDASM | D:\Robot\2027工创赛智梭速运升降台\模型\智梭_转盘舵机座.SLDPRT | 本地存在
智梭_转台.SLDASM | D:\Robot\2027工创赛智梭速运升降台\模型\智梭_舵机（大）.SLDPRT | 本地存在
智梭_转台.SLDASM | D:\Robot\2027工创赛智梭速运升降台\模型\智梭_金属舵盘.SLDPRT | 本地存在
智梭_转台.SLDASM | D:\Robot\2027工创赛智梭速运升降台\模型\智梭_转盘.SLDPRT | 本地存在
智梭_转台.SLDASM | D:\Robot\2027工创赛智梭速运升降台\模型\智梭_转盘物料盘1.SLDPRT | 本地存在
