NONGbixi/GONGCHUANG_Intelligent_Logistics_Handling_Tower_Crane_Mechanical/(commit log)

2026-10-18 整理智梭速运升降台机械资料
    [2027升降台_紧固件商家采购清单.xlsx, 2027铝条支架总装_紧固件清单.xlsx, 智梭_10mm铜柱.SLDPRT, 智梭_13mm铜柱.SLDPRT, 智梭_1云台装配.SLDASM, 智梭_2027升降台总_铝条支架_标准紧固件.SLDASM, 智梭_28闭环步进电机.SLDPRT, 智梭_42步进电机-01.SLDPRT]
2026-10-19 更新升降台装配、皮带固定片及M4螺钉模型
    [智梭_1云台装配.SLDASM, 智梭_2027升降台总_铝条支架_标准紧固件.SLDASM, 智梭_DIN7984_M4x12.SLDPRT, 智梭_升降台皮带固定片1.SLDPRT, 智梭_转台.SLDASM]
2026-10-20 更新升降台装配、六角联轴器及麦轮模型
    [智梭_1云台装配.SLDASM, 智梭_2027升降台总_铝条支架_标准紧固件.SLDASM, 智梭_六角联轴器.SLDPRT, 智梭_转台.SLDASM, 智梭_麦轮_（正）.SLDPRT, 智梭_麦轮（反）.SLDPRT, 智梭_麦轮（正）.SLDPRT]
2026-10-20 更新升降台装配及电池电控模块
    [智梭_1云台装配.SLDASM, 智梭_2027升降台总_铝条支架_标准紧固件.SLDASM, 智梭_底板_增加11mm_2027独立版.SLDPRT, 智梭_电池仓1.SLDPRT, 智梭_电池仓2.SLDPRT, 智梭_电路板示意_100x100_孔距90.SLDPRT, 智梭_舵机夹片.SLDPRT, 智梭_调车用电池示意_70x70x80.SLDPRT]
2026-10-21 新增陀螺仪与摄像头模型并更新升降台装配
    新增 JY62 陀螺仪、UVC 摄像头及摄像头支架模型。更新升降台总装、云台、转台、电池仓1、电池电控模块和初赛物料3。补充 JY62 建模脚本、模型说明、预览图及核对记录。
    [智梭_1云台装配.SLDASM, 智梭_2027升降台总_铝条支架_标准紧固件.SLDASM, 智梭_JY62陀螺仪.SLDPRT, 智梭_UVC摄像头.SLDPRT, 智梭_初赛物料3.SLDPRT, 智梭_摄像头支架.SLDPRT, 智梭_电池仓1.SLDPRT, 智梭_转台.SLDASM]
2026-10-23 重大更新：解决底板、升降底座、前伸L形架干涉问题
    解决底板、升降底座、前伸L形架干涉问题。修改相关零件并同步更新整车总装，新增地面模型。
    [地面.SLDPRT, 智梭_2027升降台总_铝条支架_标准紧固件.SLDASM, 智梭_前伸水平轴连接板.SLDPRT, 智梭_升降台升降底座.SLDPRT, 智梭_底板_增加11mm_2027独立版.SLDPRT, 智梭_舵机座L形架.SLDPRT]
2026-10-24 重大更新：解决底板、升降底座、前伸L形架干涉问题
    重要改动：装配体滑块数量由6个调整为5个，减少1个；当前正确数量为5个。
    更新整车总装、云台装配、云台托架及舵机夹片；将地面和电池电控模块文件名统一添加“智梭_”前缀。
    [智梭_1云台装配.SLDASM, 智梭_2027升降台总_铝条支架_标准紧固件.SLDASM, 智梭_云台托架.SLDPRT, 智梭_地面.SLDPRT, 智梭_电池电控模块.SLDASM, 智梭_舵机夹片.SLDPRT]
2026-10-24 重大更新：解决底板、升降底座、前伸L形架干涉问题
    README置顶2026.10.24装配验证公告，同步修复模型。发布记录包含底板圆孔增大至82mm、垫圈增高至4mm、增加避让孔位、前伸L形架改形及升降台下沉安装说明，共5项。
    [智梭_1云台装配.SLDASM, 智梭_2027升降台总_铝条支架_标准紧固件.SLDASM, 智梭_UVC摄像头.SLDPRT, 智梭_前伸水平轴连接板.SLDPRT, 智梭_升降台升降底座.SLDPRT, 智梭_电池电控模块.SLDASM, 智梭_转台.SLDASM, 智梭_转盘.SLDPRT]
